Victor-JB/IEEE-Minimalist-AI-Challenge-2026/tools/arm_mujoco/drive_parts.png

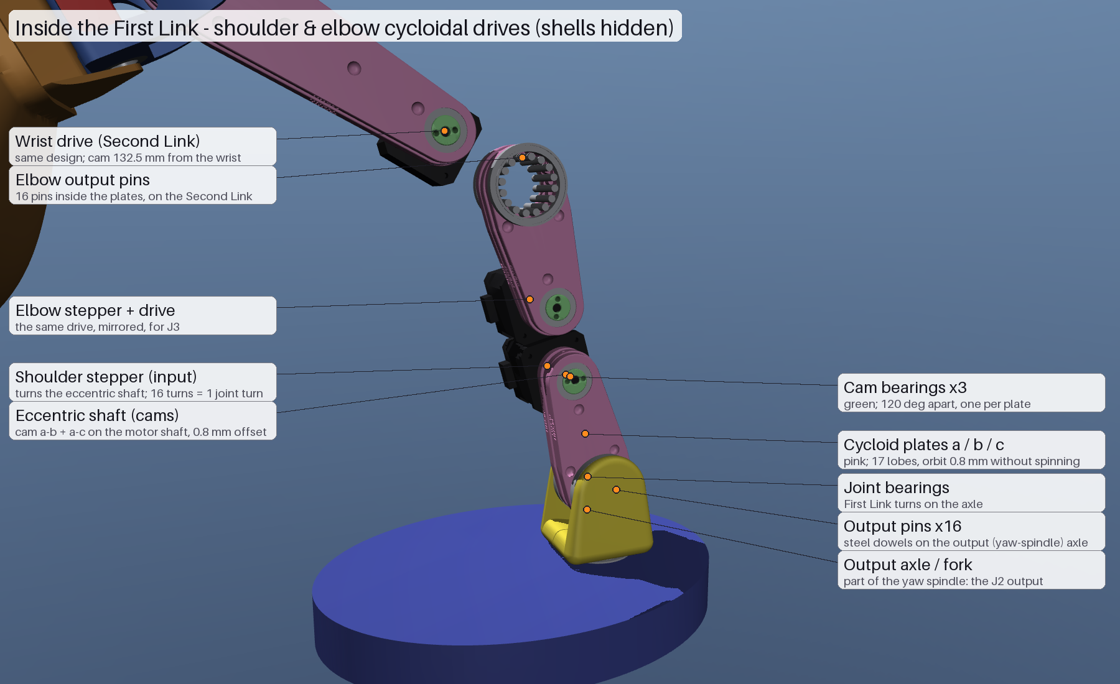
tools/arm_mujoco/drive_parts.png
