Victor-JB/IEEE-Minimalist-AI-Challenge-2026/docs/state_machine_v0_happy_path.png

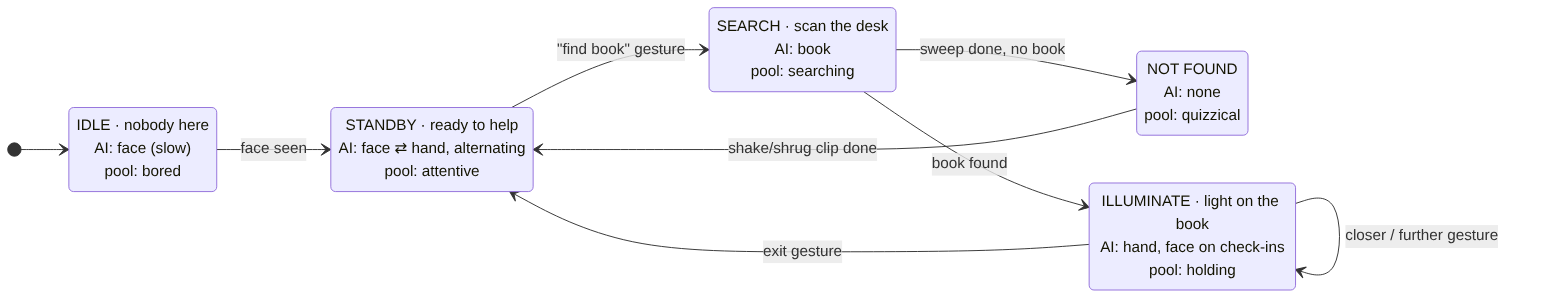
docs/state_machine_v0_happy_path.png
