Victor-JB/IEEE-Minimalist-AI-Challenge-2026/docs/state_machine_v1_fault.png

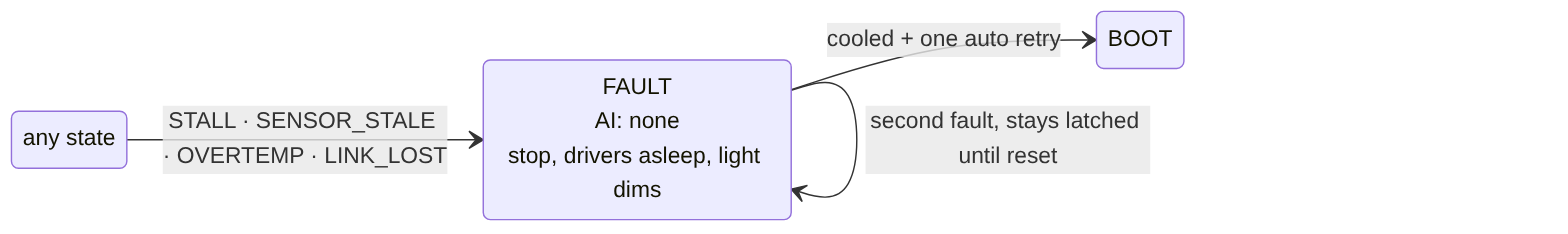
docs/state_machine_v1_fault.png
