Victor-JB/IEEE-Minimalist-AI-Challenge-2026/docs/state_machine_v1_production.png

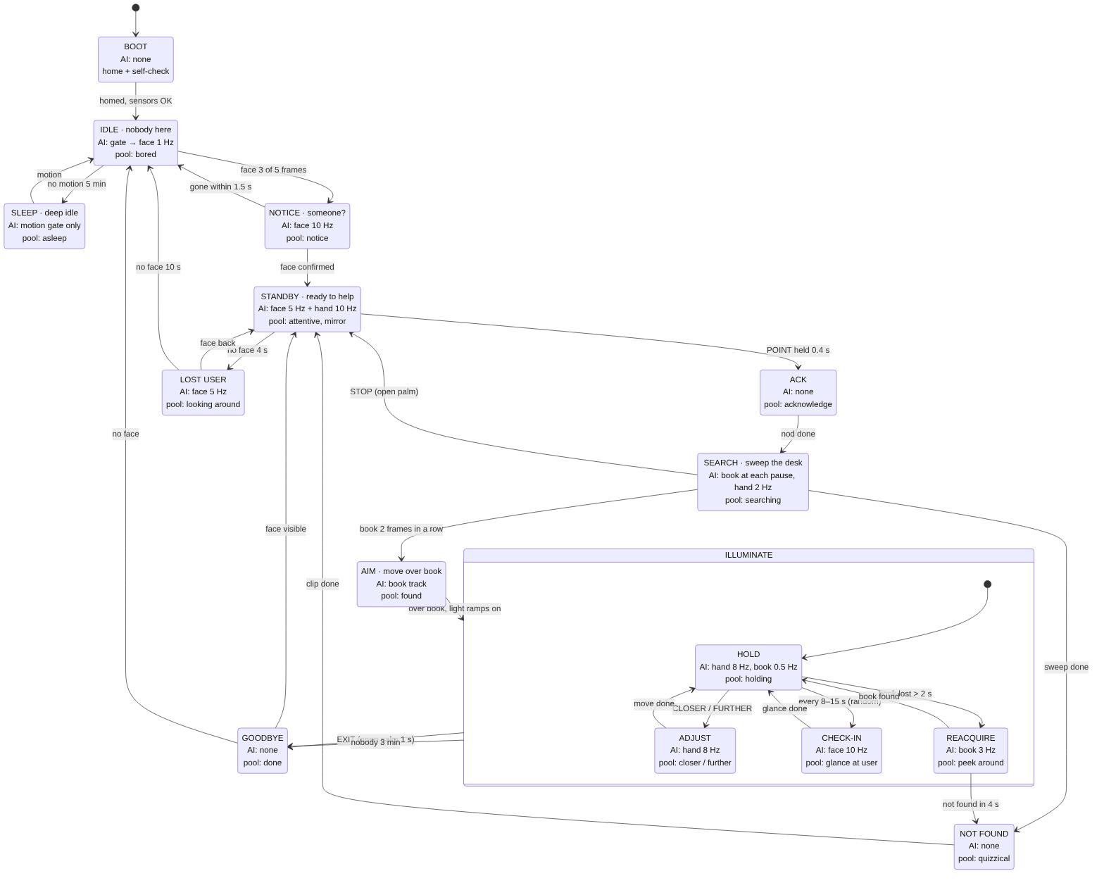
docs/state_machine_v1_production.png
