Victor-JB/IEEE-Minimalist-AI-Challenge-2026/motion_lib/gamma_comparison/out_of_reach.png

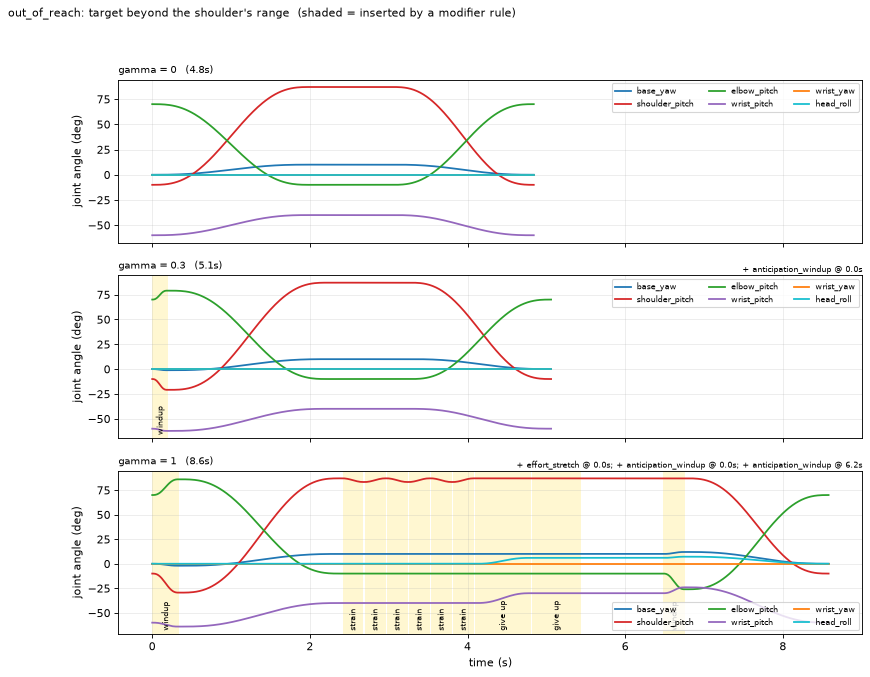
motion_lib/gamma_comparison/out_of_reach.png
