Victor-JB/IEEE-Minimalist-AI-Challenge-2026/motion_lib/gamma_comparison/point_at_object.png

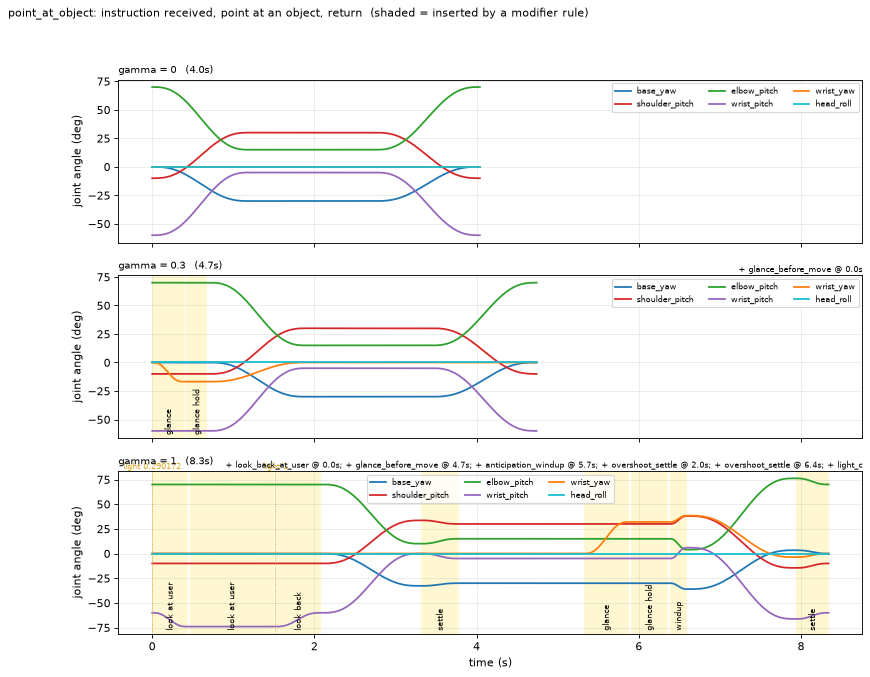
motion_lib/gamma_comparison/point_at_object.png
