Victor-JB/IEEE-Minimalist-AI-Challenge-2026/motion_lib/gamma_comparison/reaim_light.png

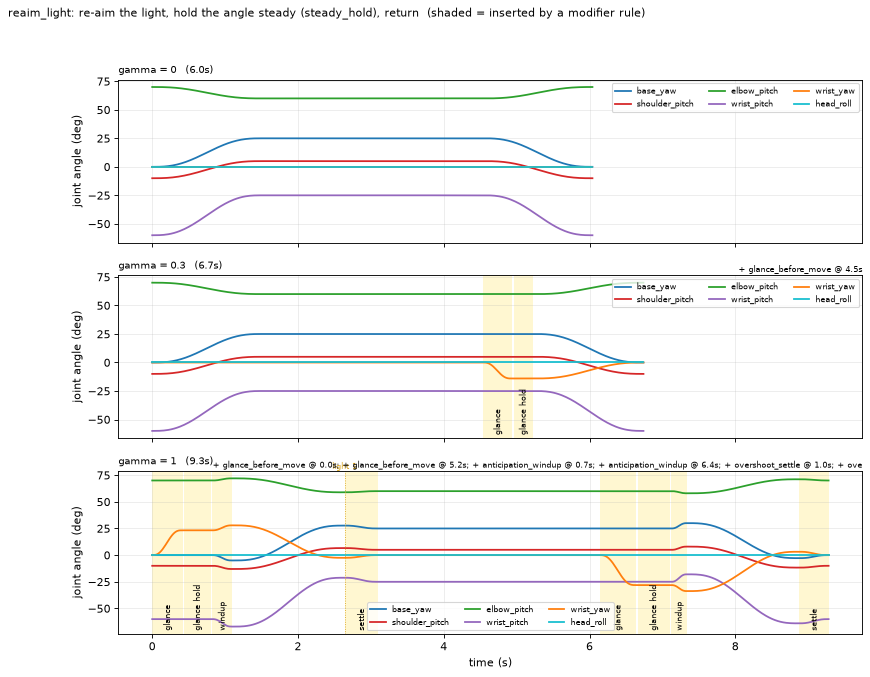
motion_lib/gamma_comparison/reaim_light.png
