Victor-JB/IEEE-Minimalist-AI-Challenge-2026/motion_lib/gamma_comparison/social_greeting.png

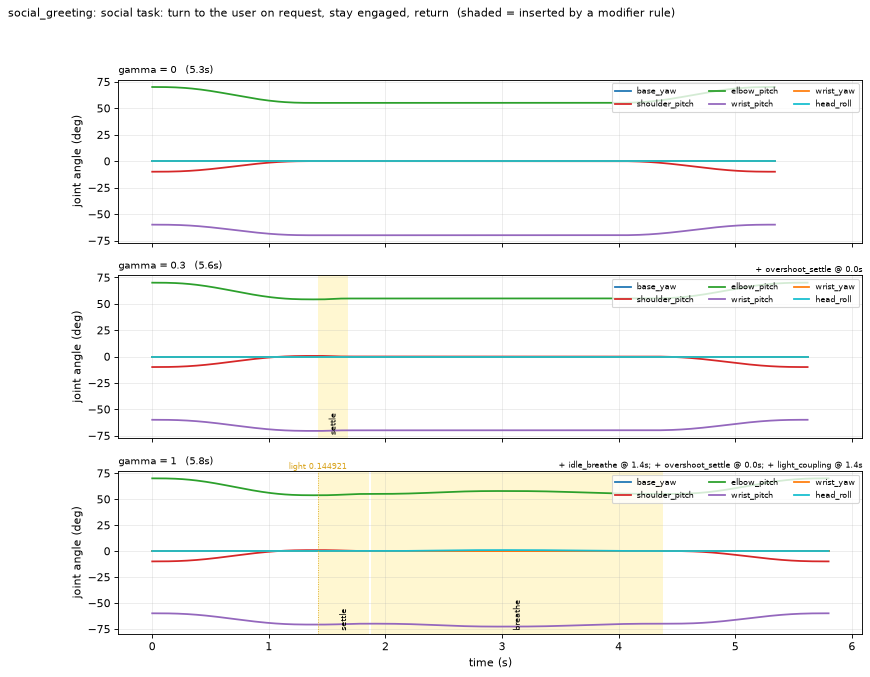
motion_lib/gamma_comparison/social_greeting.png
