Victor-JB/IEEE-Minimalist-AI-Challenge-2026/motion_lib/gamma_comparison/uncertain_move.png

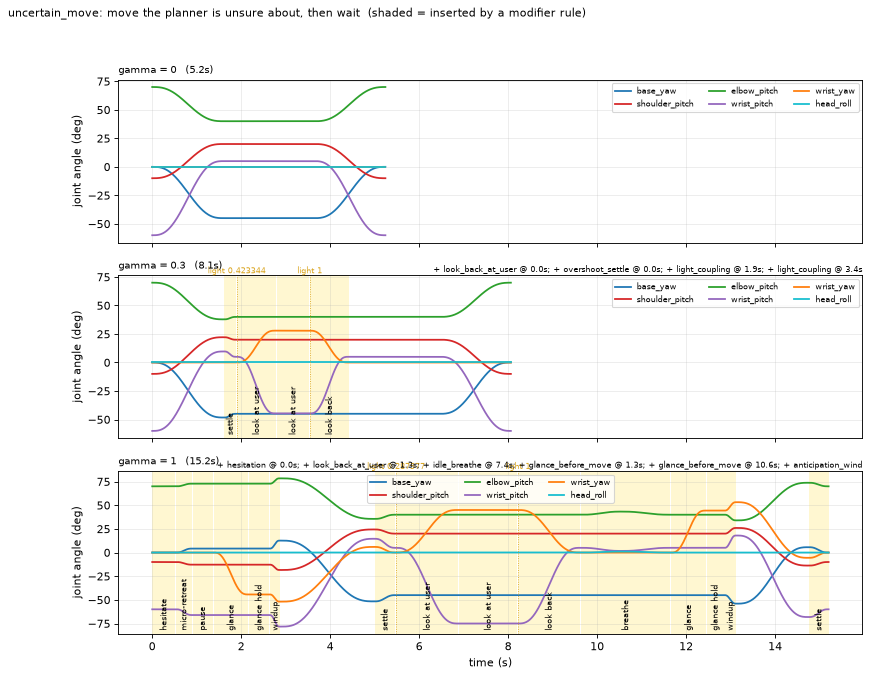
motion_lib/gamma_comparison/uncertain_move.png
