Victor-JB/IEEE-Minimalist-AI-Challenge-2026/motion_lib/review/clips/confident_snap__emphatic.png

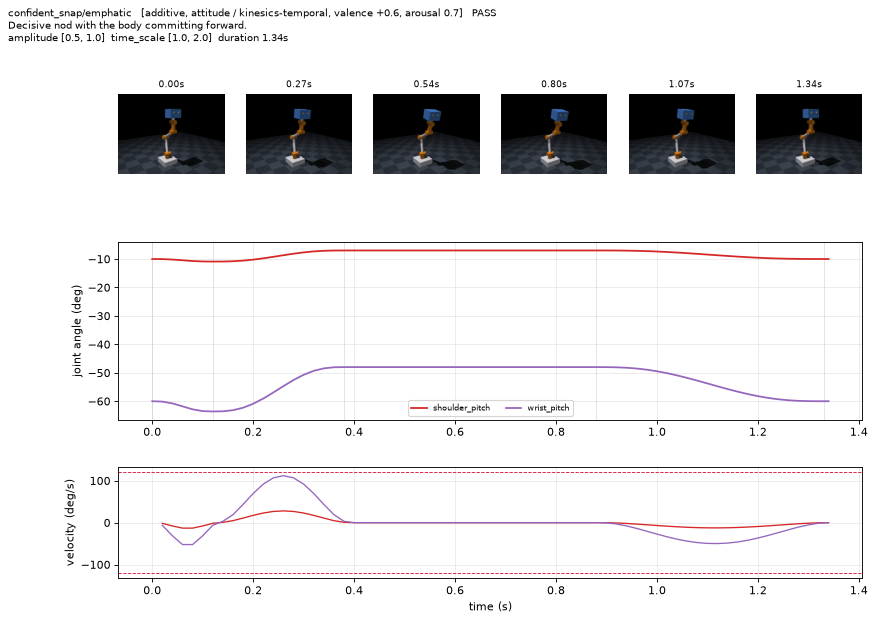
motion_lib/review/clips/confident_snap__emphatic.png
