Victor-JB/IEEE-Minimalist-AI-Challenge-2026/motion_lib/review/clips/curious_head_tilt__double.png

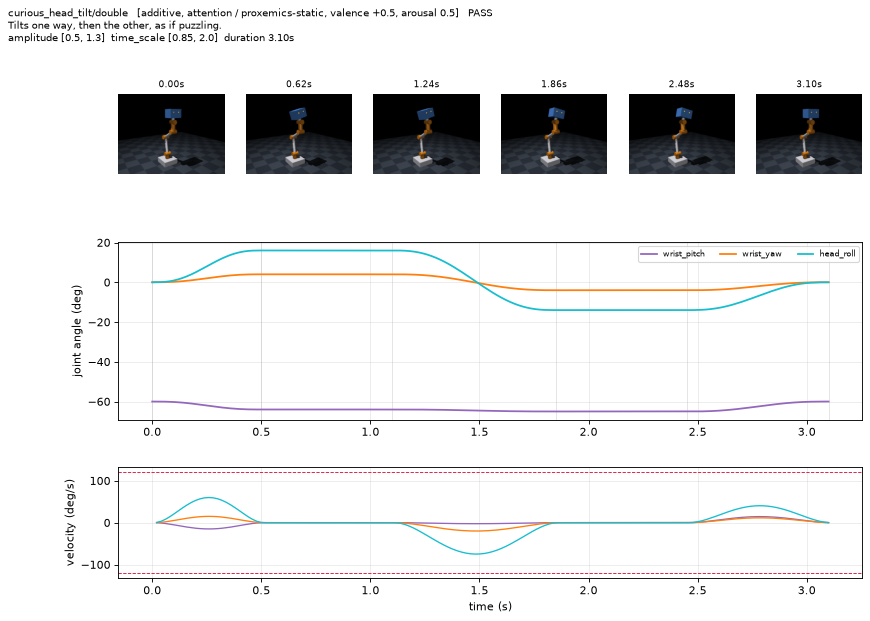
motion_lib/review/clips/curious_head_tilt__double.png
