Victor-JB/IEEE-Minimalist-AI-Challenge-2026/motion_lib/review/clips/dance_110__party.png

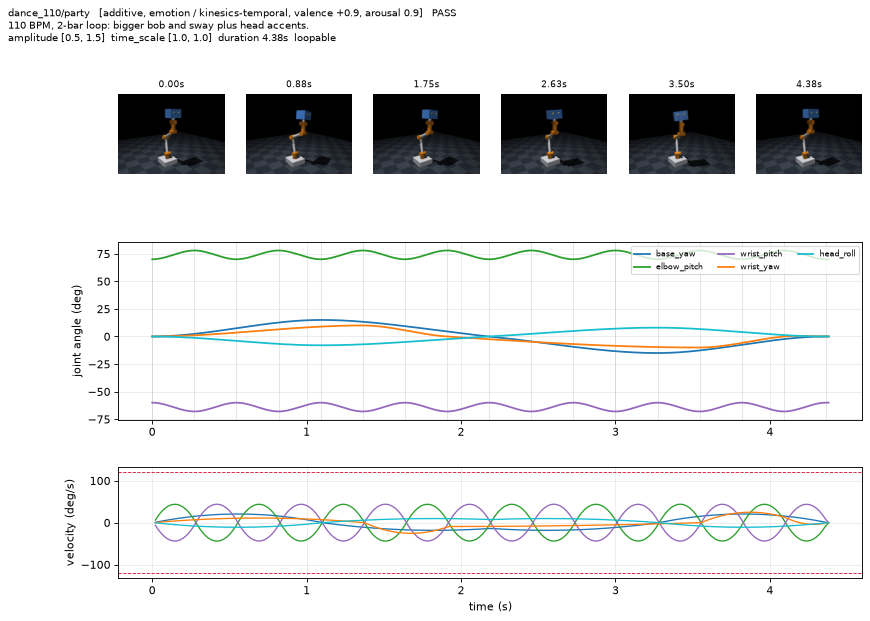
motion_lib/review/clips/dance_110__party.png
