Victor-JB/IEEE-Minimalist-AI-Challenge-2026/motion_lib/review/clips/double_take__big.png

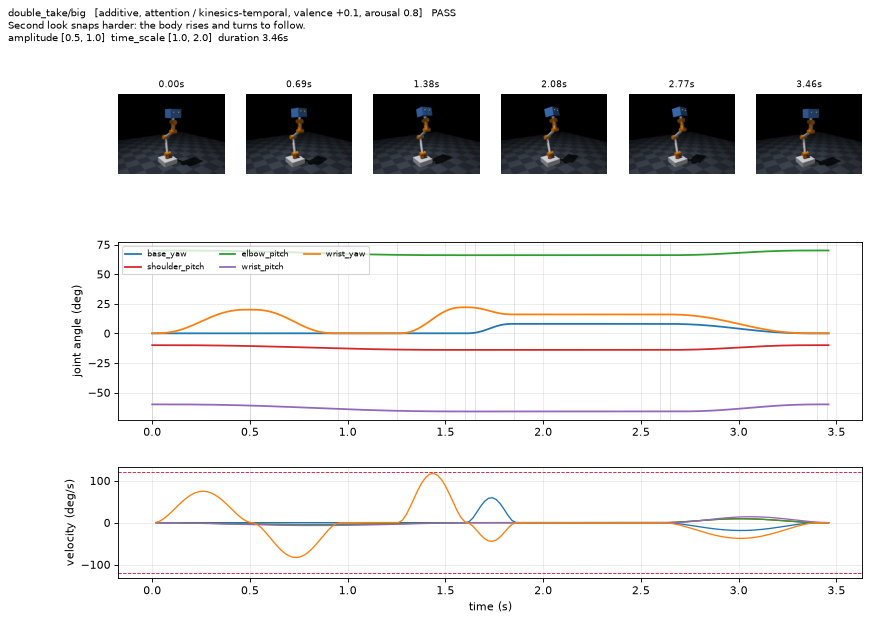
motion_lib/review/clips/double_take__big.png
