Victor-JB/IEEE-Minimalist-AI-Challenge-2026/motion_lib/review/clips/excited_bounce__big_eager.png

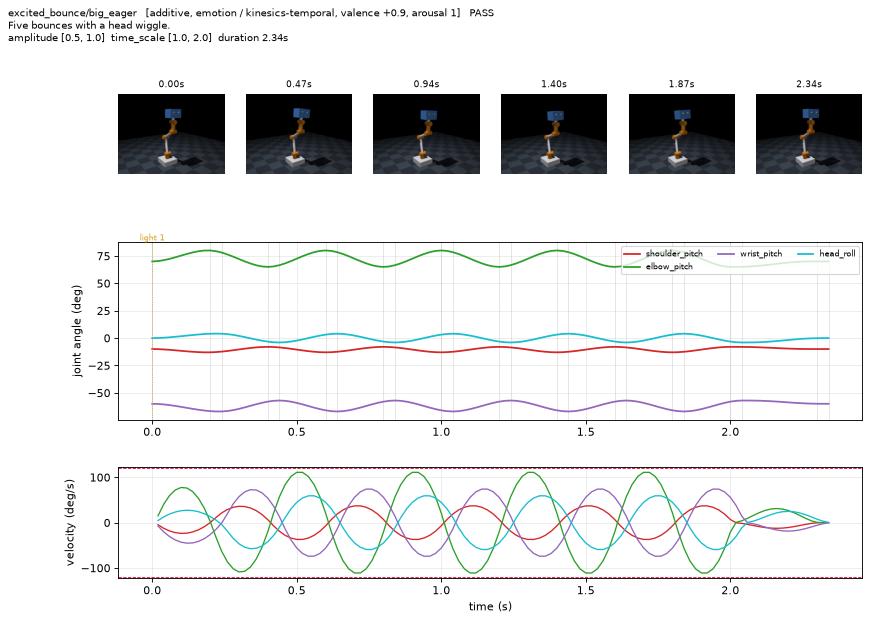
motion_lib/review/clips/excited_bounce__big_eager.png
