Victor-JB/IEEE-Minimalist-AI-Challenge-2026/motion_lib/review/clips/go_to_sleep__quick.png

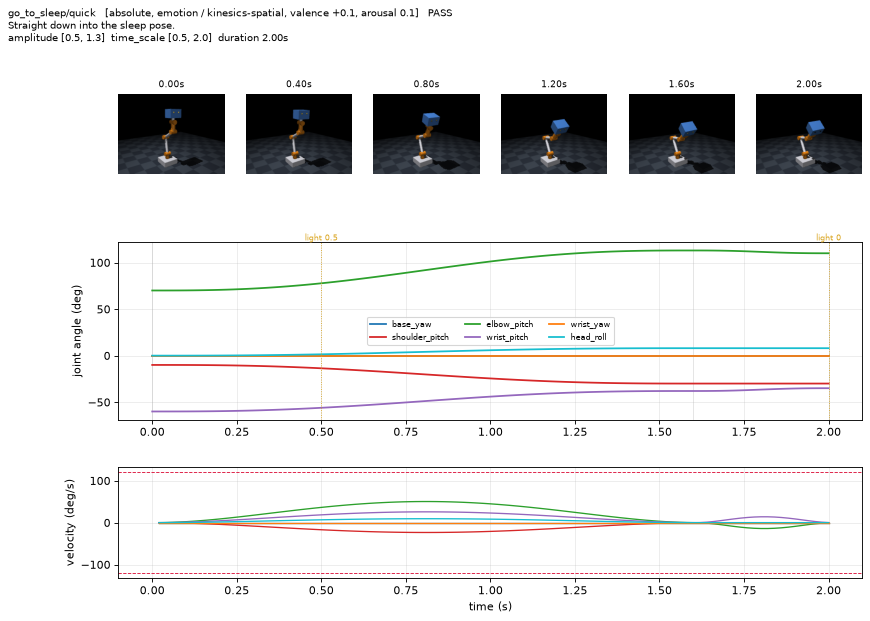
motion_lib/review/clips/go_to_sleep__quick.png
