Victor-JB/IEEE-Minimalist-AI-Challenge-2026/motion_lib/review/clips/hesitate__unsure.png

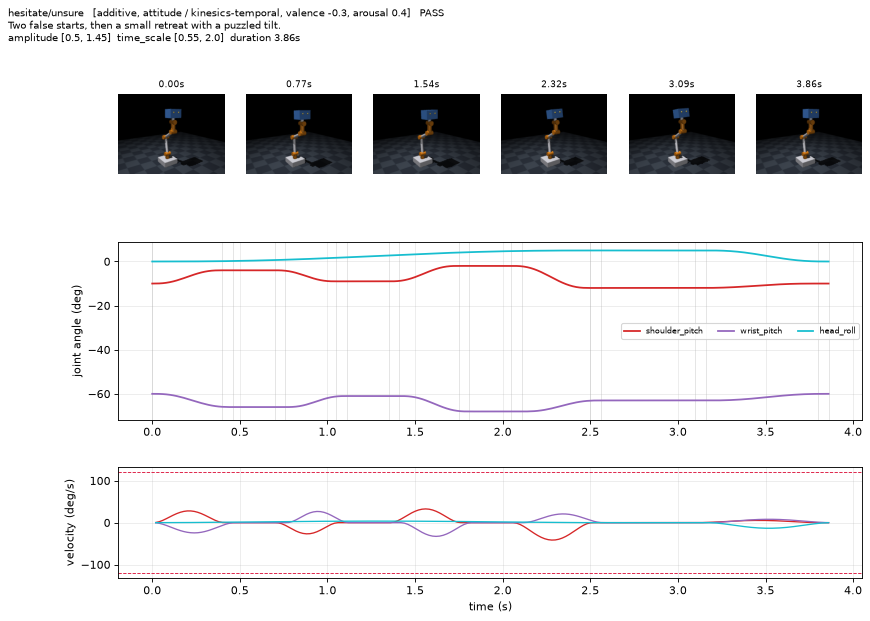
motion_lib/review/clips/hesitate__unsure.png
