Victor-JB/IEEE-Minimalist-AI-Challenge-2026/motion_lib/review/clips/home__brisk.png

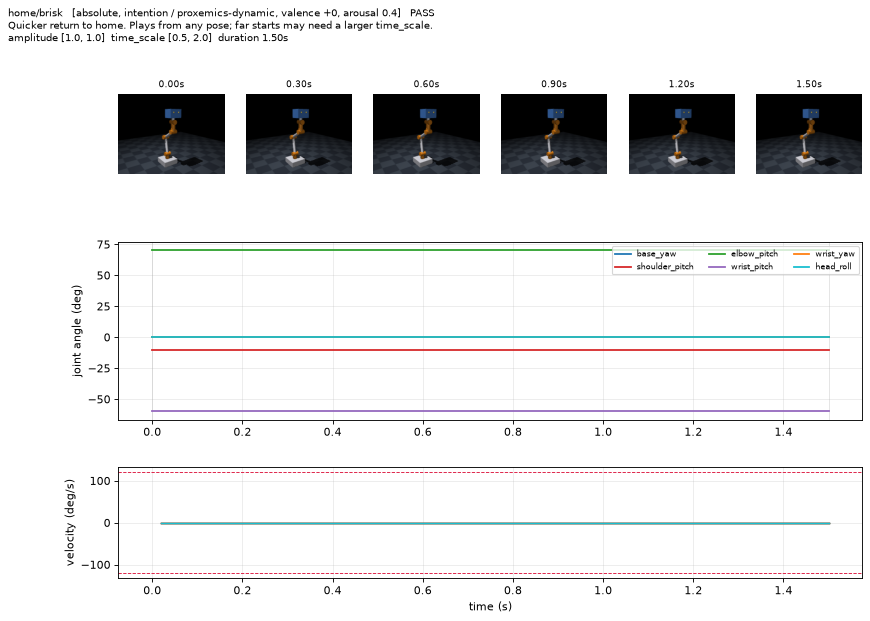
motion_lib/review/clips/home__brisk.png
