Victor-JB/IEEE-Minimalist-AI-Challenge-2026/motion_lib/review/clips/idle_breathe__calm.png

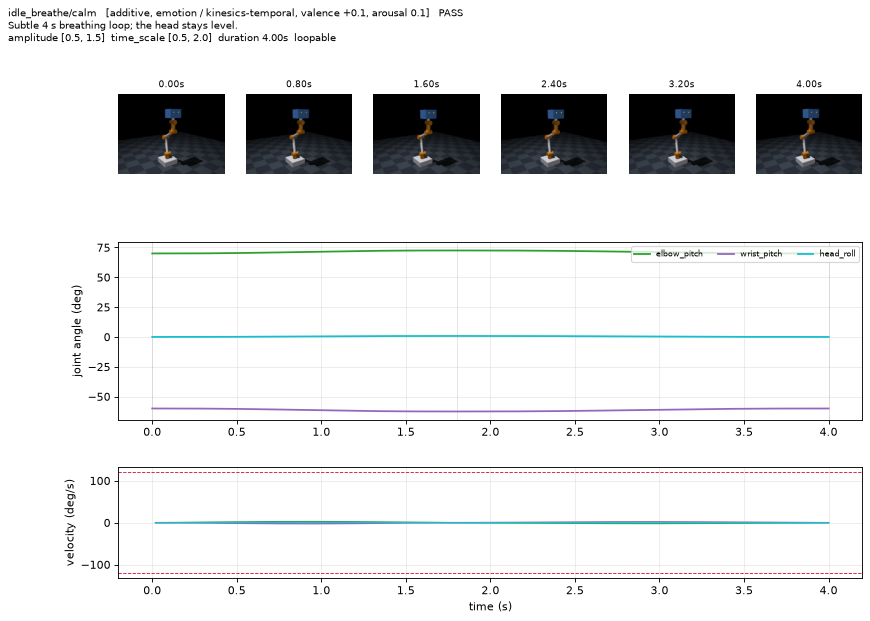
motion_lib/review/clips/idle_breathe__calm.png
