Victor-JB/IEEE-Minimalist-AI-Challenge-2026/motion_lib/review/clips/lean_in_interest__deep.png

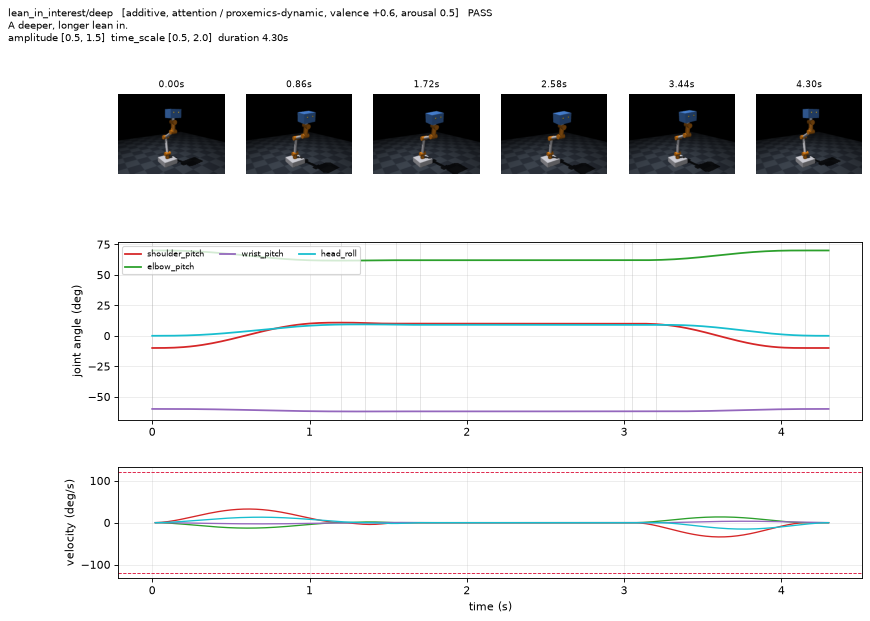
motion_lib/review/clips/lean_in_interest__deep.png
