Victor-JB/IEEE-Minimalist-AI-Challenge-2026/motion_lib/review/clips/look_at_user_return__quick_left.png

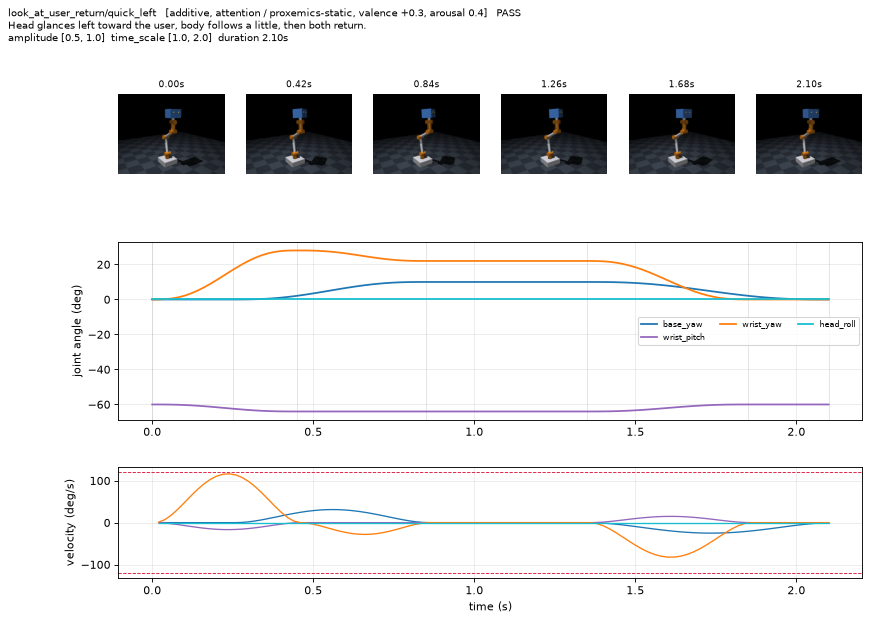
motion_lib/review/clips/look_at_user_return__quick_left.png
