Victor-JB/IEEE-Minimalist-AI-Challenge-2026/motion_lib/review/clips/nod_yes__big_eager.png

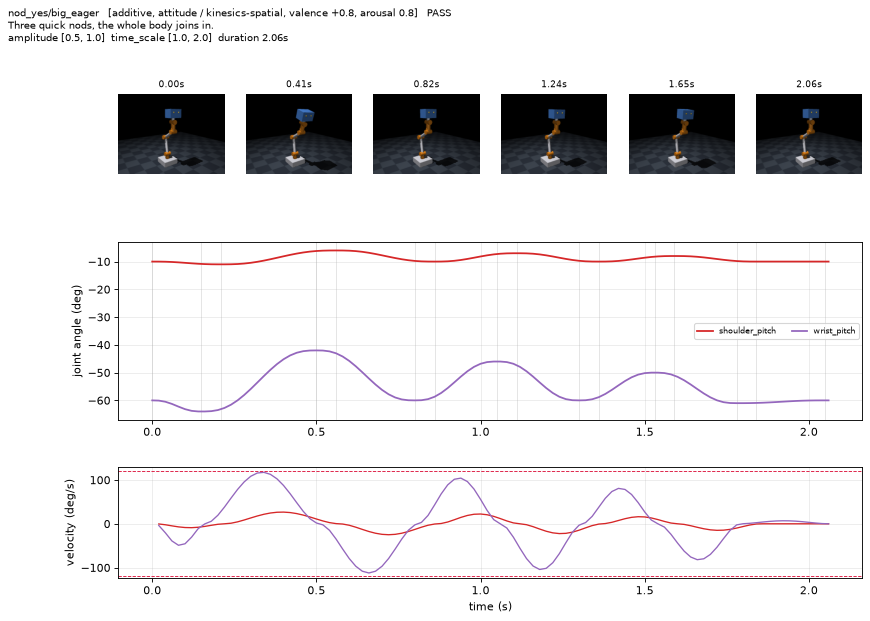
motion_lib/review/clips/nod_yes__big_eager.png
