Victor-JB/IEEE-Minimalist-AI-Challenge-2026/motion_lib/review/clips/nod_yes__medium.png

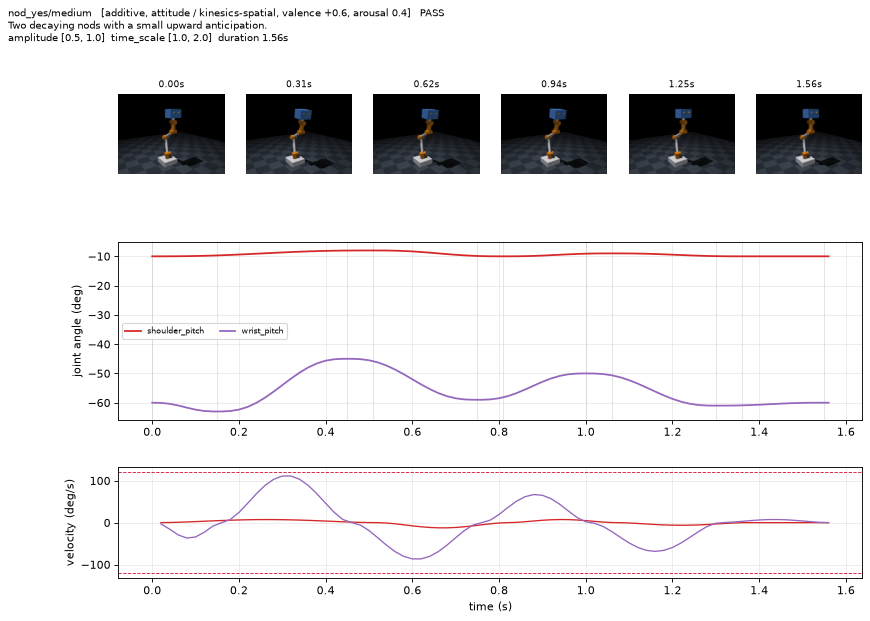
motion_lib/review/clips/nod_yes__medium.png
