Victor-JB/IEEE-Minimalist-AI-Challenge-2026/motion_lib/review/clips/nod_yes__small_calm.png

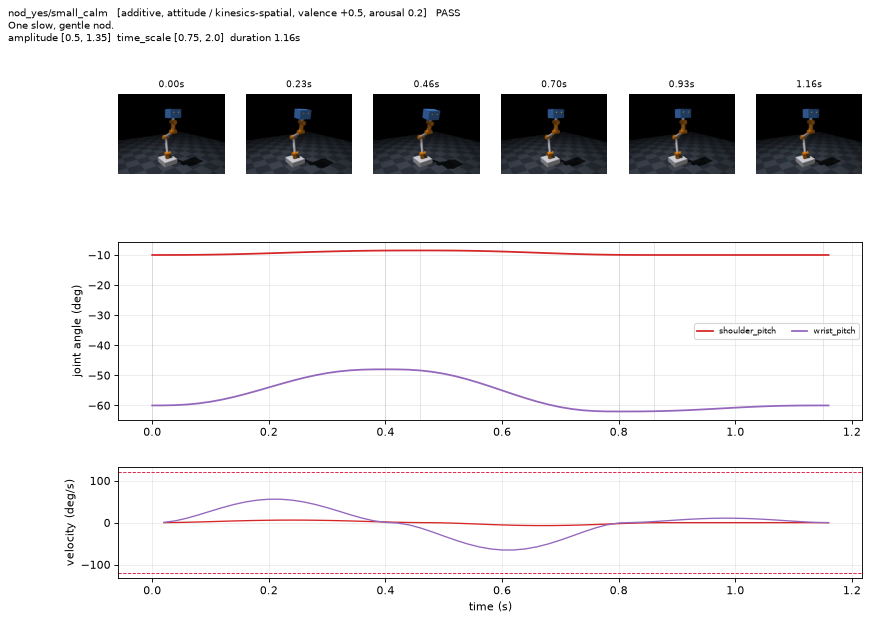
motion_lib/review/clips/nod_yes__small_calm.png
