Victor-JB/IEEE-Minimalist-AI-Challenge-2026/motion_lib/review/clips/perk_up__small.png

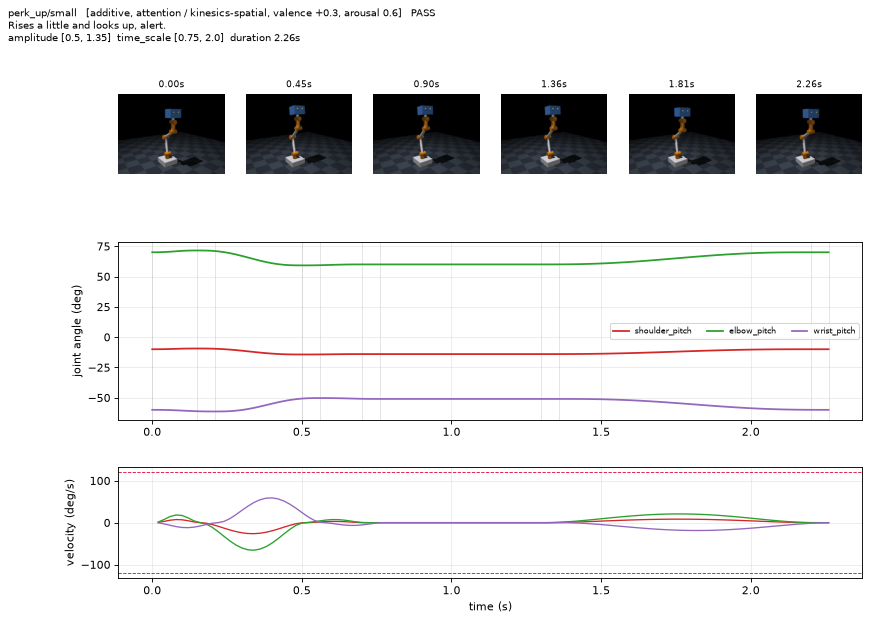
motion_lib/review/clips/perk_up__small.png
