Victor-JB/IEEE-Minimalist-AI-Challenge-2026/motion_lib/review/clips/relaxed_sit_down__calm.png

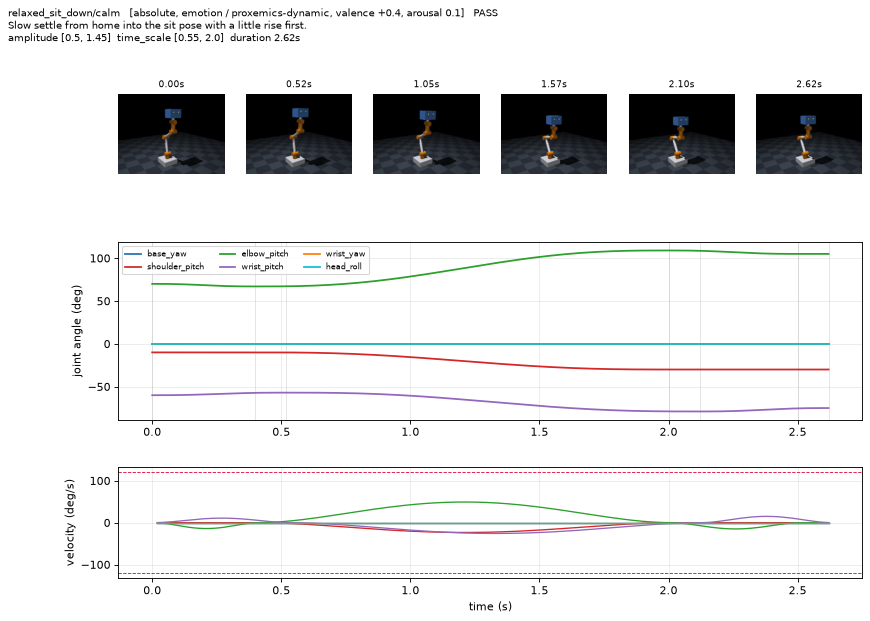
motion_lib/review/clips/relaxed_sit_down__calm.png
