Victor-JB/IEEE-Minimalist-AI-Challenge-2026/motion_lib/review/clips/sad_droop__slight.png

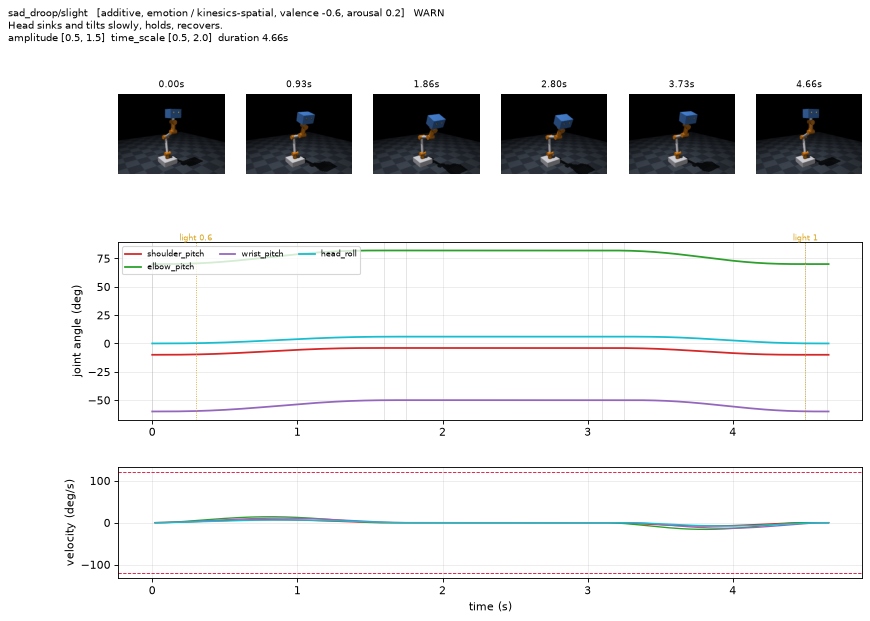
motion_lib/review/clips/sad_droop__slight.png
