Victor-JB/IEEE-Minimalist-AI-Challenge-2026/motion_lib/review/clips/scan_room__calm.png

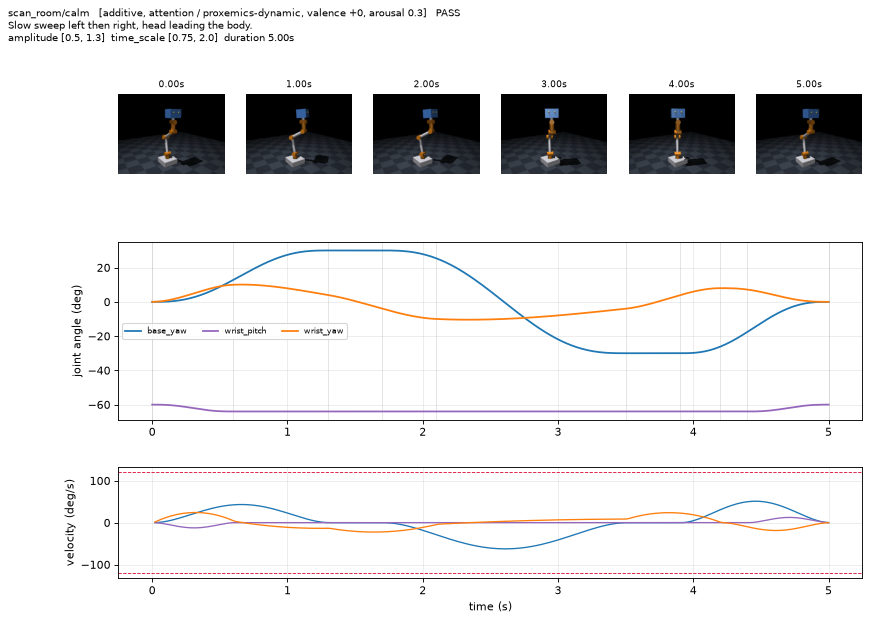
motion_lib/review/clips/scan_room__calm.png
