Victor-JB/IEEE-Minimalist-AI-Challenge-2026/motion_lib/review/clips/shake_no__small_calm.png

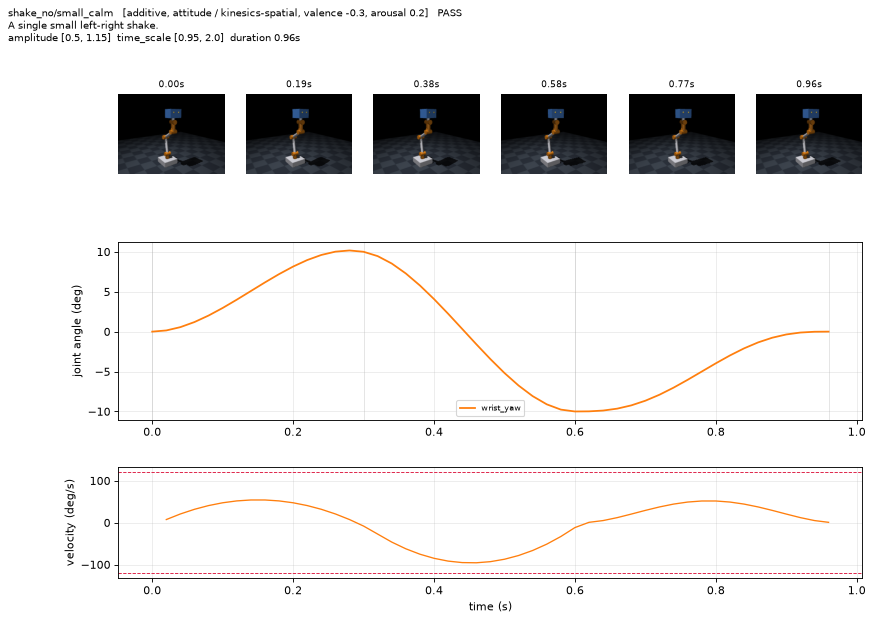
motion_lib/review/clips/shake_no__small_calm.png
