Victor-JB/IEEE-Minimalist-AI-Challenge-2026/motion_lib/review/clips/shrug_fail__big.png

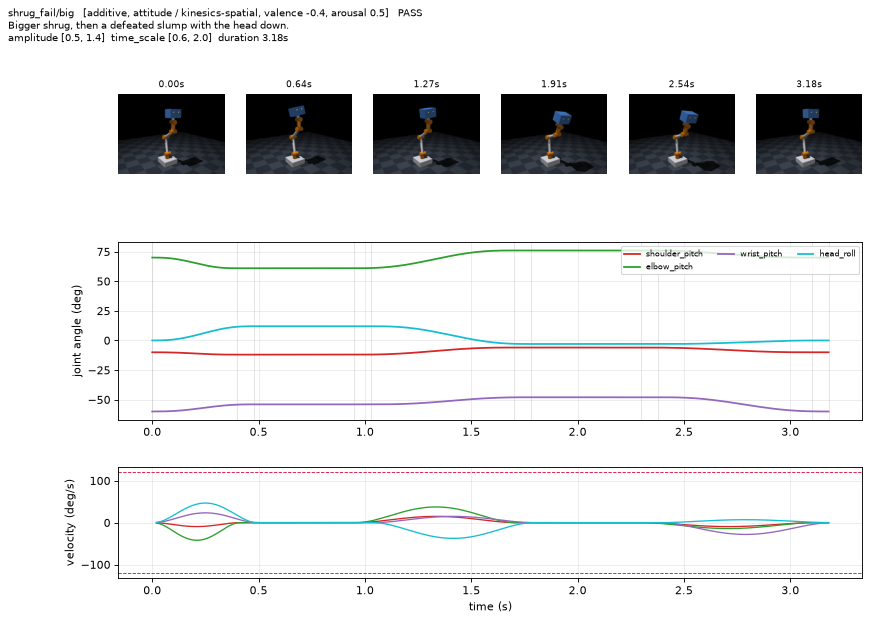
motion_lib/review/clips/shrug_fail__big.png
