Victor-JB/IEEE-Minimalist-AI-Challenge-2026/motion_lib/review/clips/startle_recoil__big.png

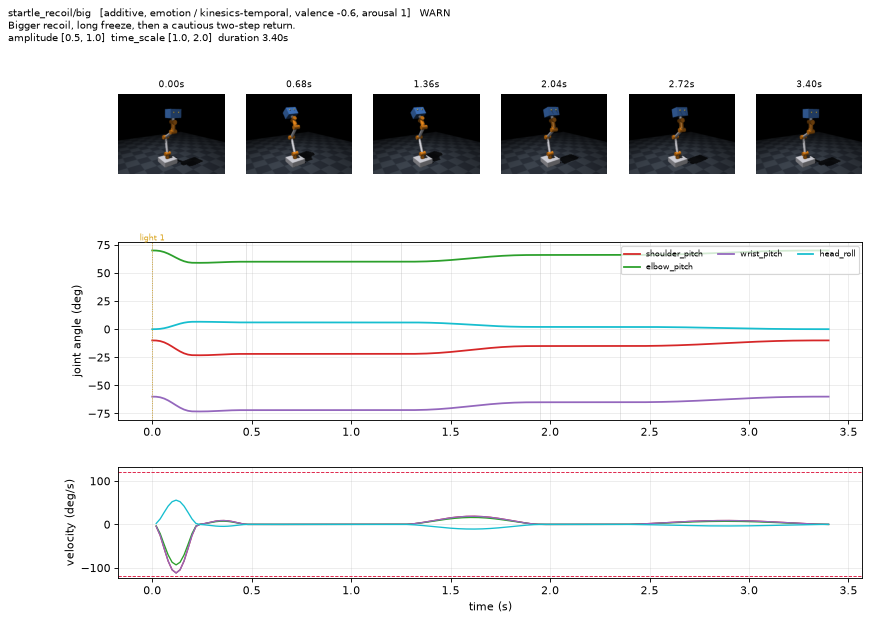
motion_lib/review/clips/startle_recoil__big.png
