Victor-JB/IEEE-Minimalist-AI-Challenge-2026/motion_lib/review/clips/tail_wag__small.png

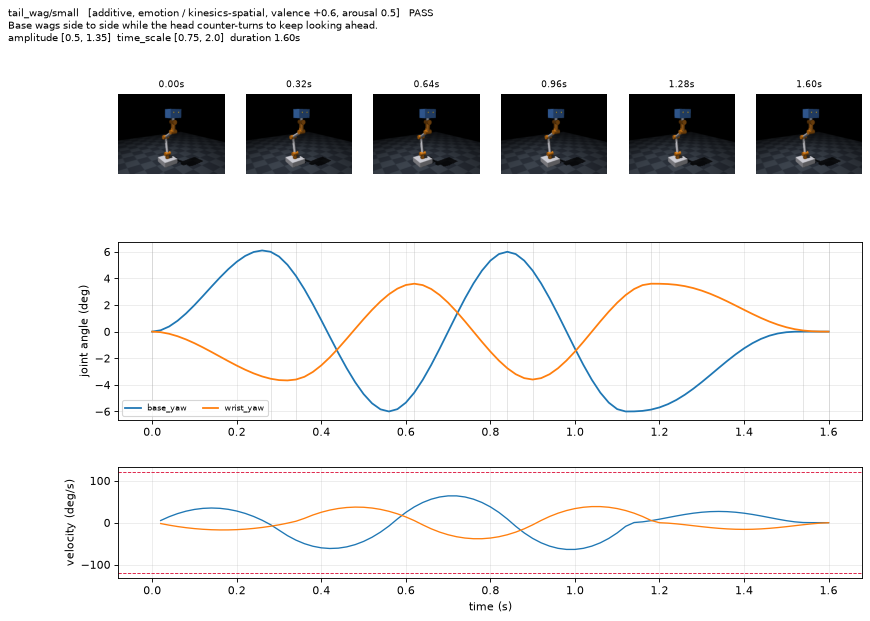
motion_lib/review/clips/tail_wag__small.png
