Victor-JB/IEEE-Minimalist-AI-Challenge-2026/motion_lib/review/clips/wake_up__quick_bright.png

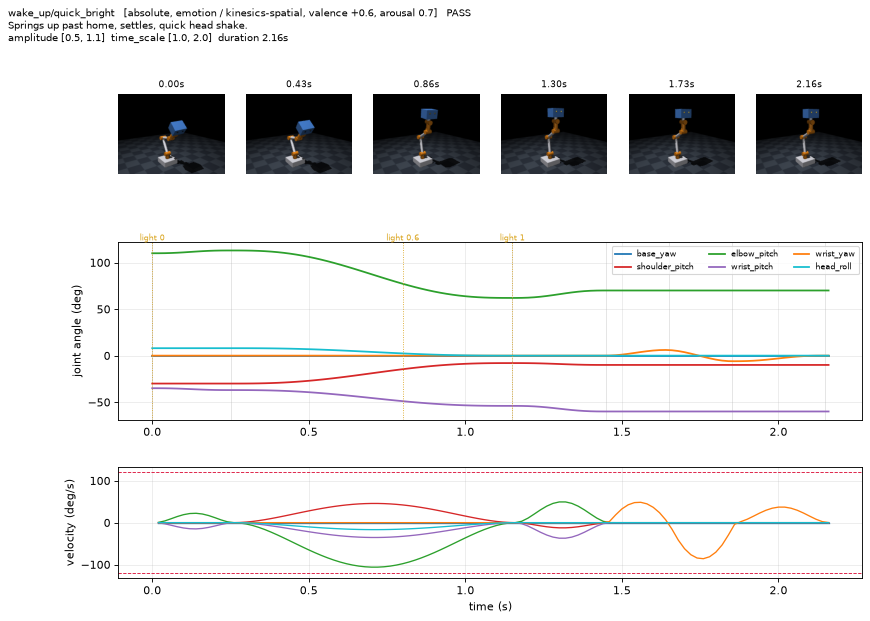
motion_lib/review/clips/wake_up__quick_bright.png
