Victor-JB/IEEE-Minimalist-AI-Challenge-2026/tools/motion_lib/gamma_comparison/reach_desk_spot.png

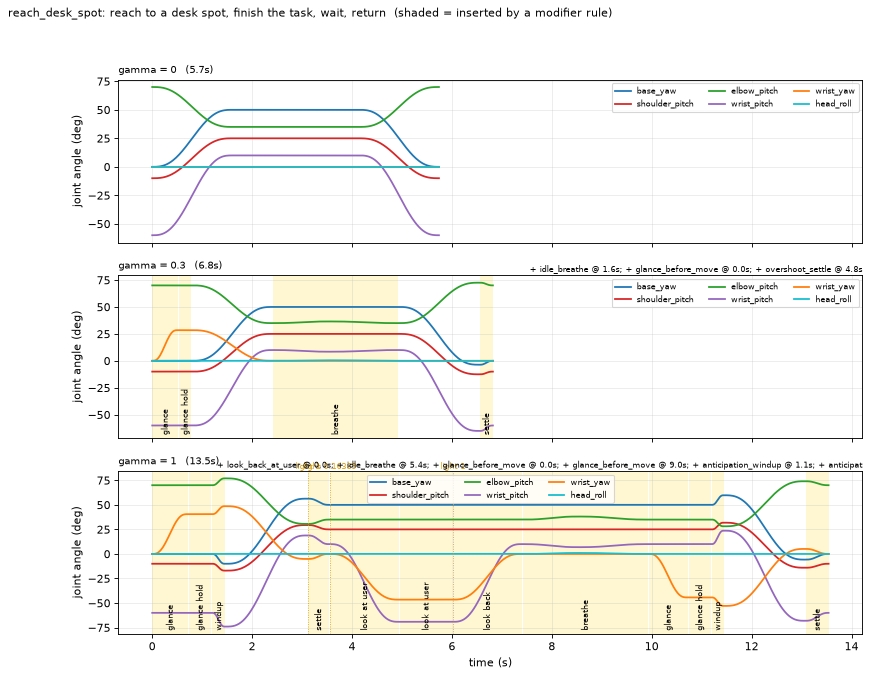
tools/motion_lib/gamma_comparison/reach_desk_spot.png
