Victor-JB/IEEE-Minimalist-AI-Challenge-2026/tools/motion_lib/gamma_comparison/return_home.png

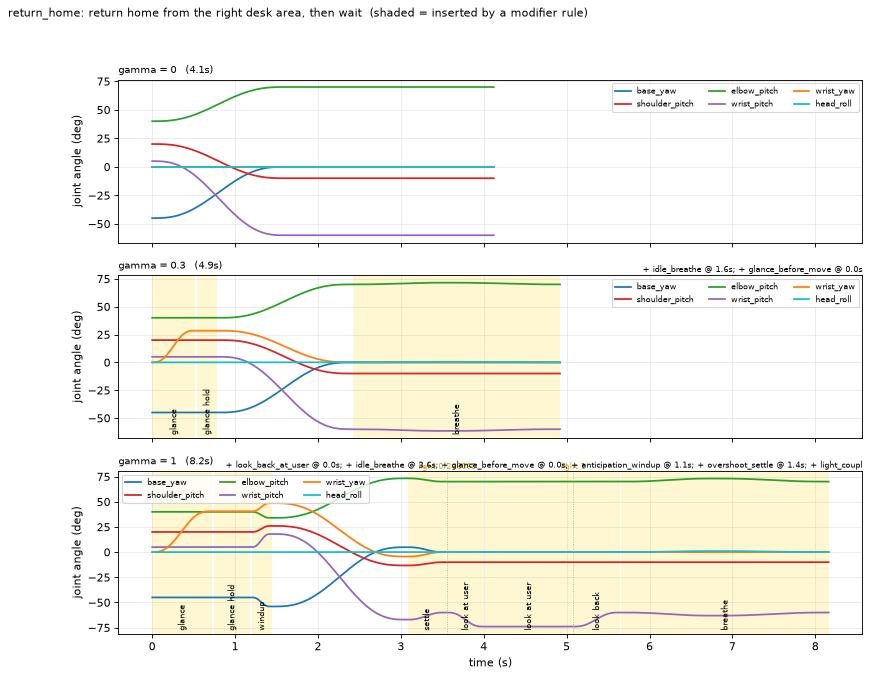
tools/motion_lib/gamma_comparison/return_home.png
