Victor-JB/IEEE-Minimalist-AI-Challenge-2026/tools/motion_lib/review/clips/approach_object__eager.png

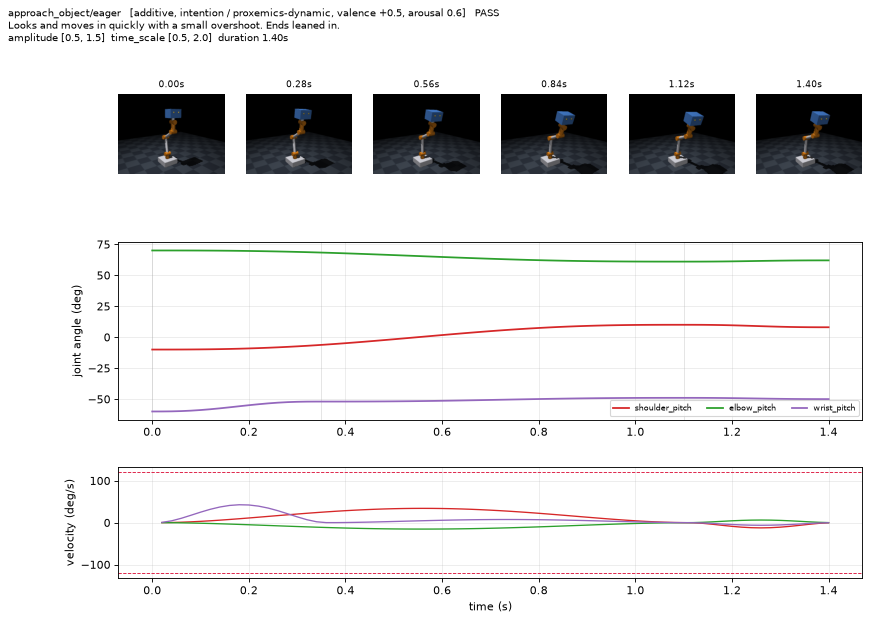
tools/motion_lib/review/clips/approach_object__eager.png
