Victor-JB/IEEE-Minimalist-AI-Challenge-2026/tools/motion_lib/review/clips/avoid_object__mild.png

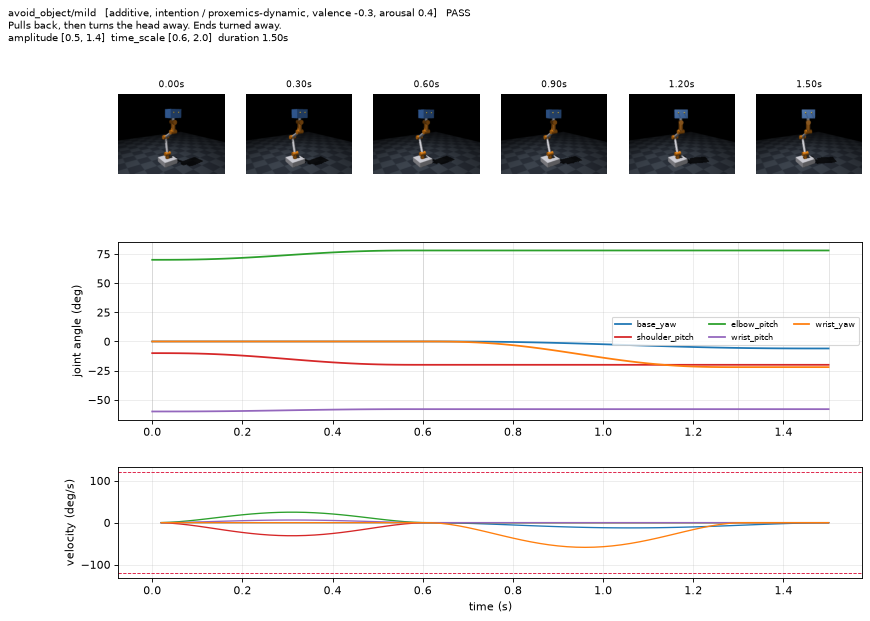
tools/motion_lib/review/clips/avoid_object__mild.png
