Victor-JB/IEEE-Minimalist-AI-Challenge-2026/tools/motion_lib/review/clips/celebrate__big.png

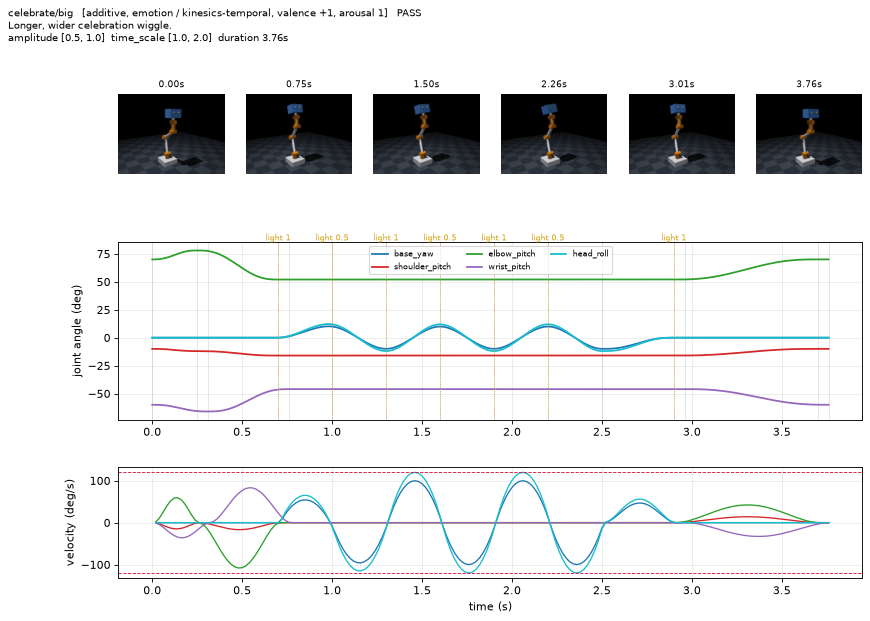
tools/motion_lib/review/clips/celebrate__big.png
