Victor-JB/IEEE-Minimalist-AI-Challenge-2026/tools/motion_lib/review/clips/dance_90__groove.png

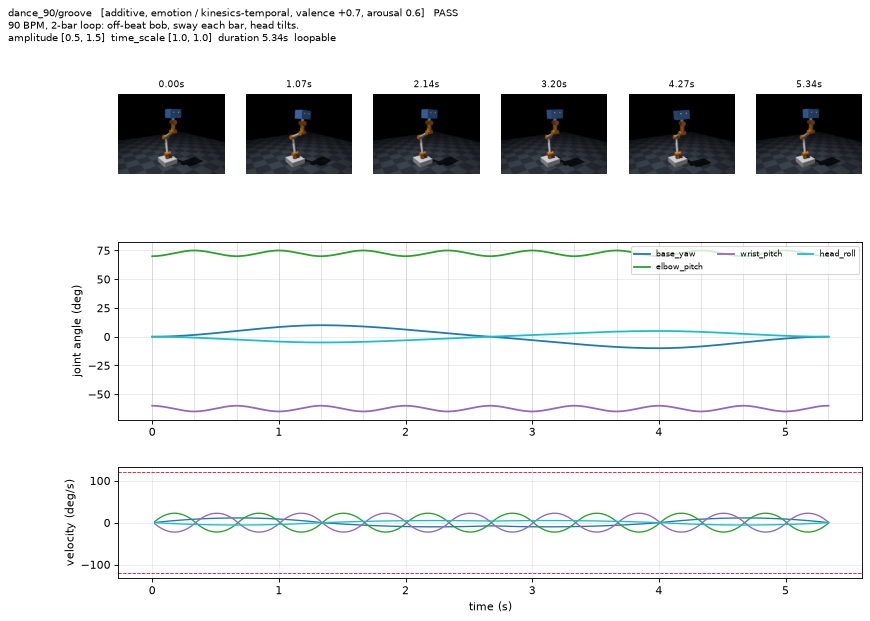
tools/motion_lib/review/clips/dance_90__groove.png
