Victor-JB/IEEE-Minimalist-AI-Challenge-2026/tools/motion_lib/review/clips/glance_then_reach__right.png

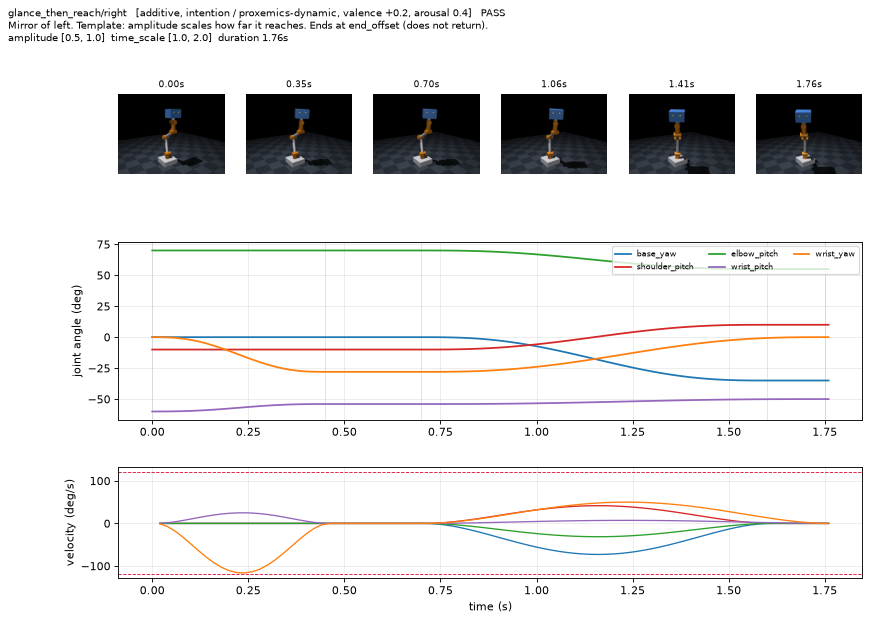
tools/motion_lib/review/clips/glance_then_reach__right.png
