Victor-JB/IEEE-Minimalist-AI-Challenge-2026/tools/motion_lib/review/clips/go_to_sleep__drowsy.png

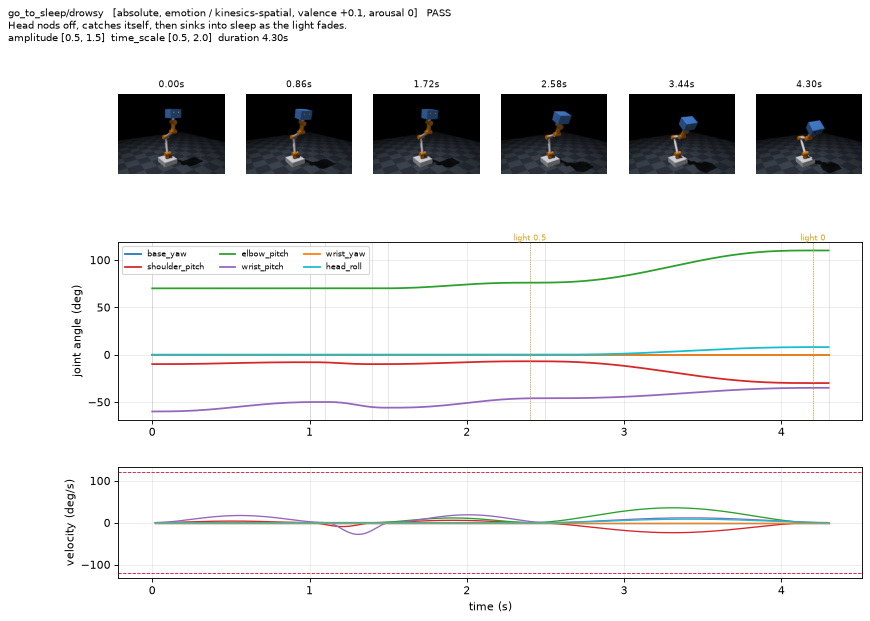
tools/motion_lib/review/clips/go_to_sleep__drowsy.png
