Victor-JB/IEEE-Minimalist-AI-Challenge-2026/tools/motion_lib/review/clips/nuzzle_touch__affectionate.png

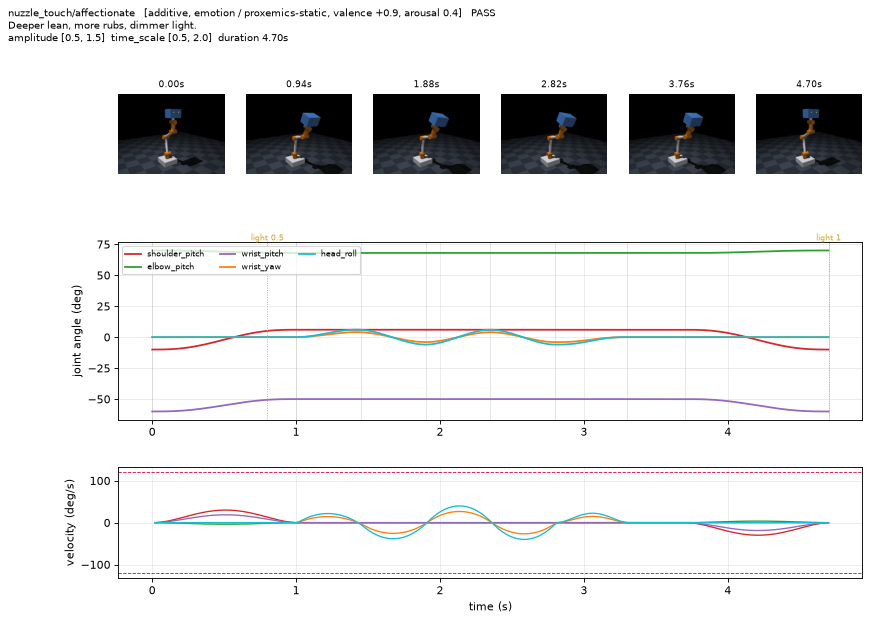
tools/motion_lib/review/clips/nuzzle_touch__affectionate.png
