Victor-JB/IEEE-Minimalist-AI-Challenge-2026/tools/motion_lib/review/clips/nuzzle_touch__gentle.png

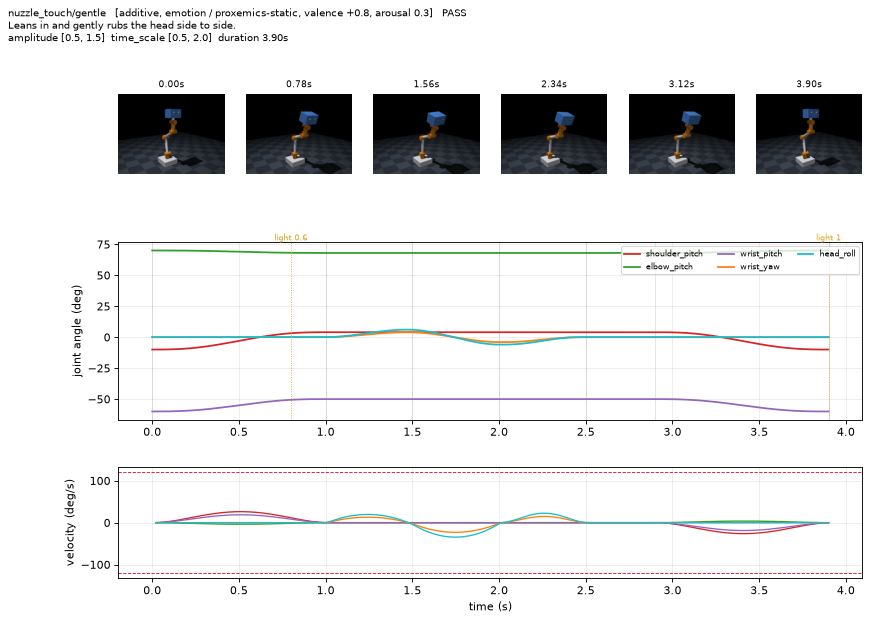
tools/motion_lib/review/clips/nuzzle_touch__gentle.png
