Victor-JB/IEEE-Minimalist-AI-Challenge-2026/tools/motion_lib/review/clips/point_with_head__left_small.png

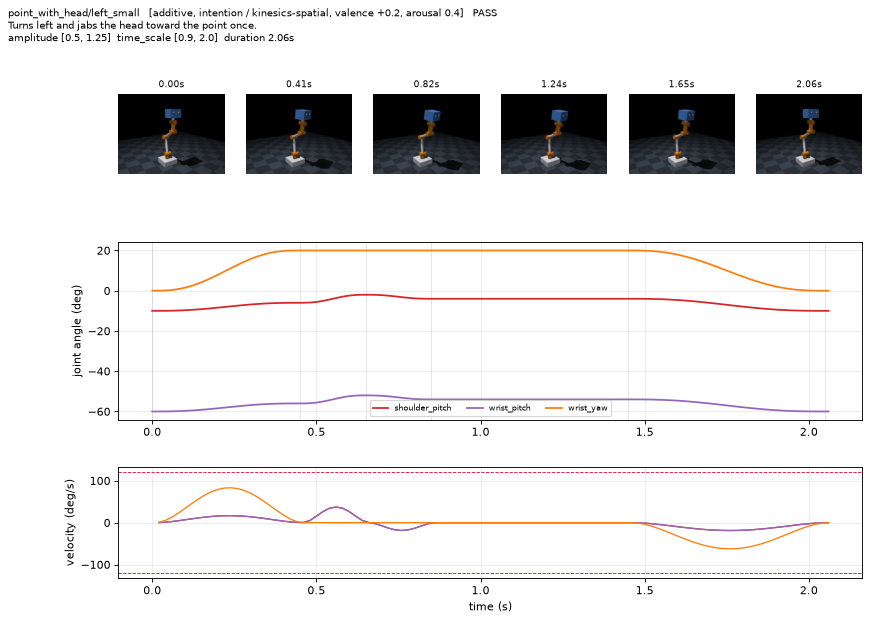
tools/motion_lib/review/clips/point_with_head__left_small.png
