Victor-JB/IEEE-Minimalist-AI-Challenge-2026/tools/motion_lib/review/clips/relaxed_sit_down__quick_plop.png

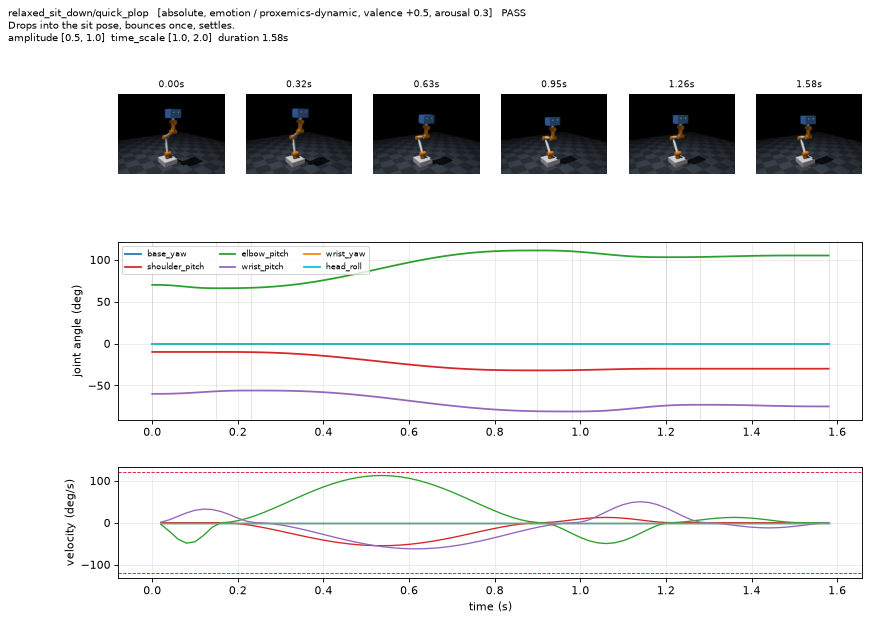
tools/motion_lib/review/clips/relaxed_sit_down__quick_plop.png
