Victor-JB/IEEE-Minimalist-AI-Challenge-2026/tools/motion_lib/review/clips/sad_droop__deep.png

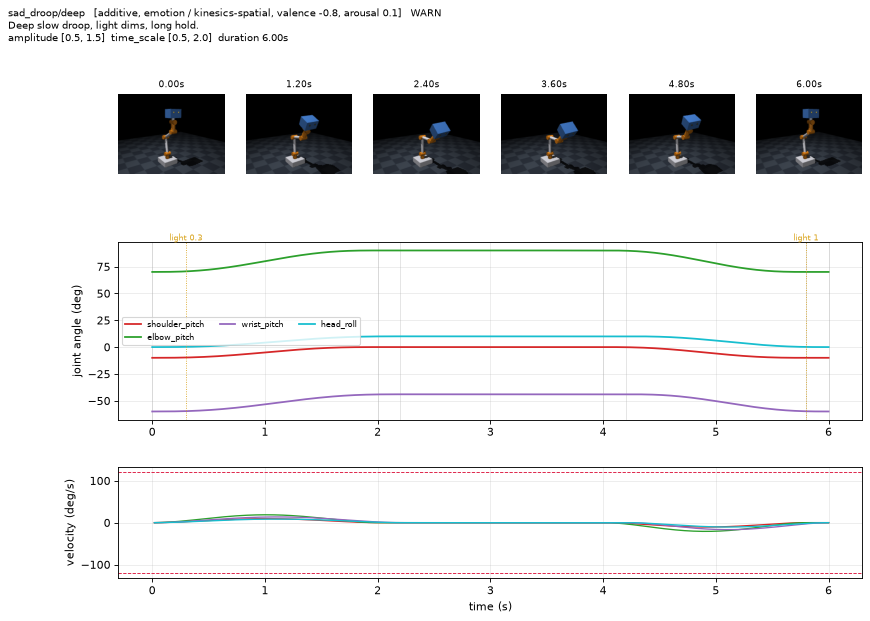
tools/motion_lib/review/clips/sad_droop__deep.png
