Victor-JB/IEEE-Minimalist-AI-Challenge-2026/tools/motion_lib/review/clips/scan_room__alert.png

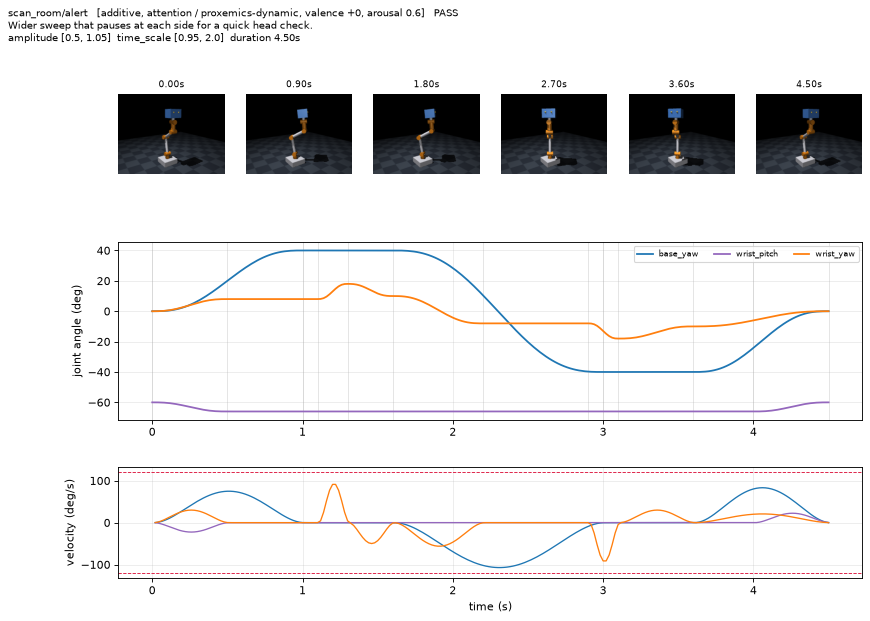
tools/motion_lib/review/clips/scan_room__alert.png
