Victor-JB/IEEE-Minimalist-AI-Challenge-2026/tools/motion_lib/review/clips/shake_no__big_emphatic.png

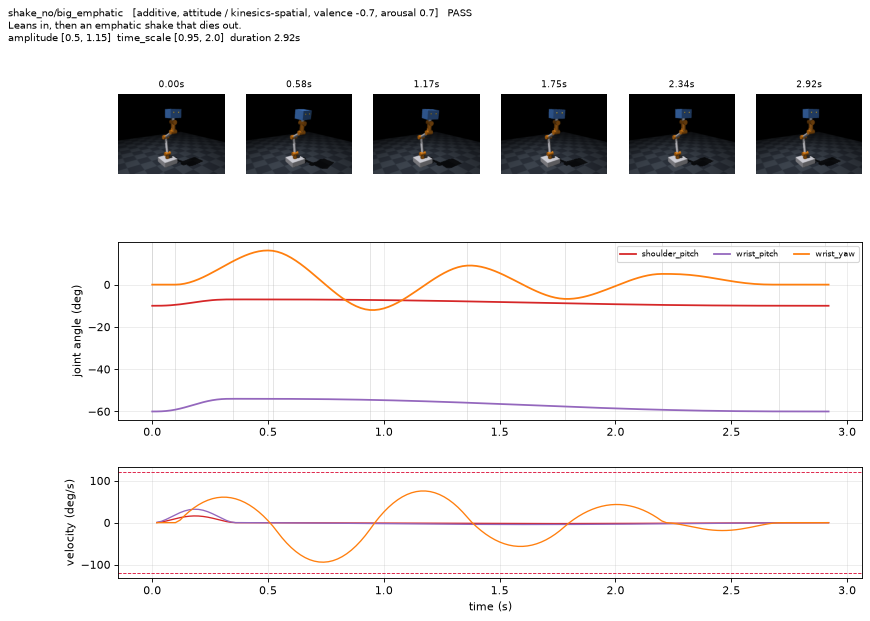
tools/motion_lib/review/clips/shake_no__big_emphatic.png
