Victor-JB/IEEE-Minimalist-AI-Challenge-2026/tools/motion_lib/review/clips/shrug_fail__small.png

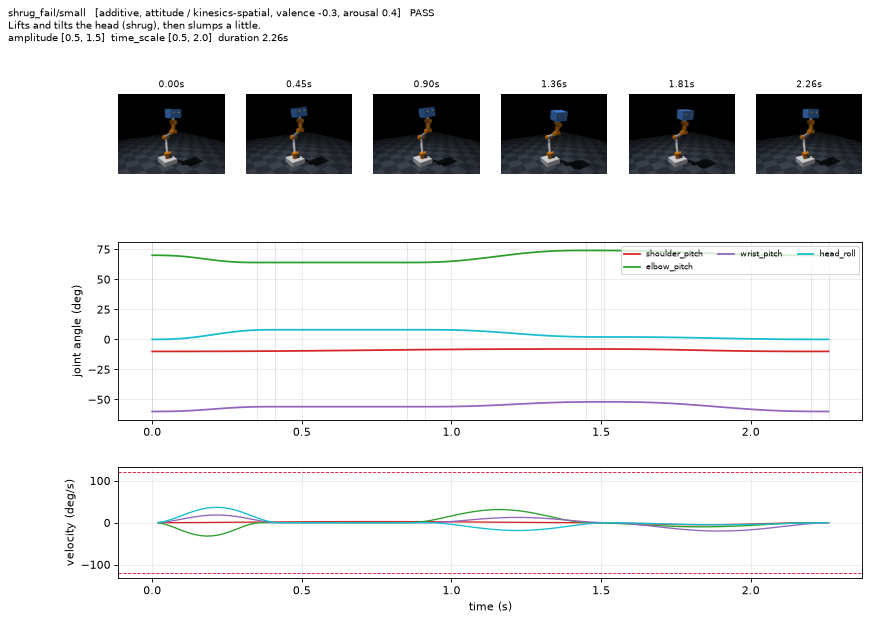
tools/motion_lib/review/clips/shrug_fail__small.png
