Victor-JB/IEEE-Minimalist-AI-Challenge-2026/tools/motion_lib/review/clips/stretch_reach_limit__short_try.png

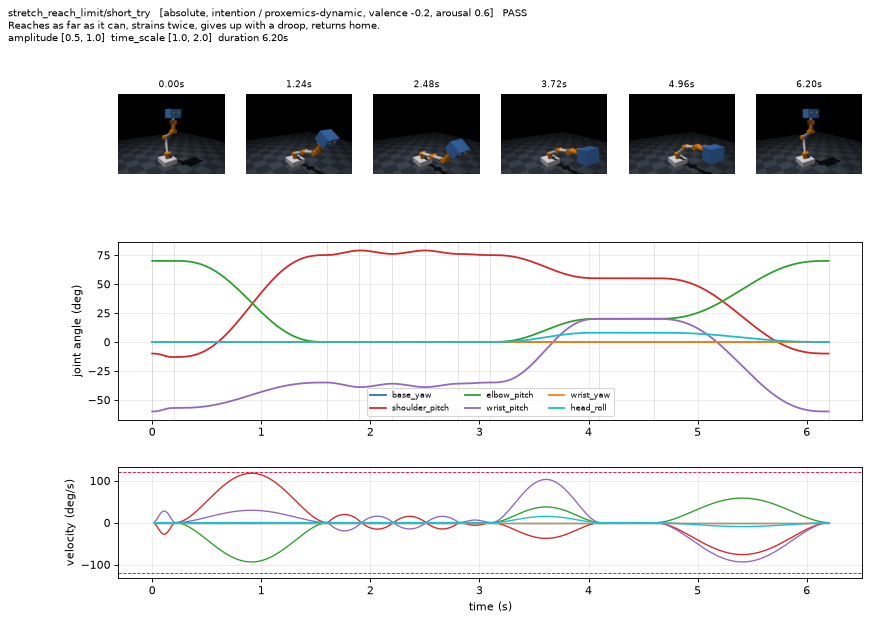
tools/motion_lib/review/clips/stretch_reach_limit__short_try.png
