Victor-JB/IEEE-Minimalist-AI-Challenge-2026/tools/motion_lib/review/clips/tail_wag__big.png

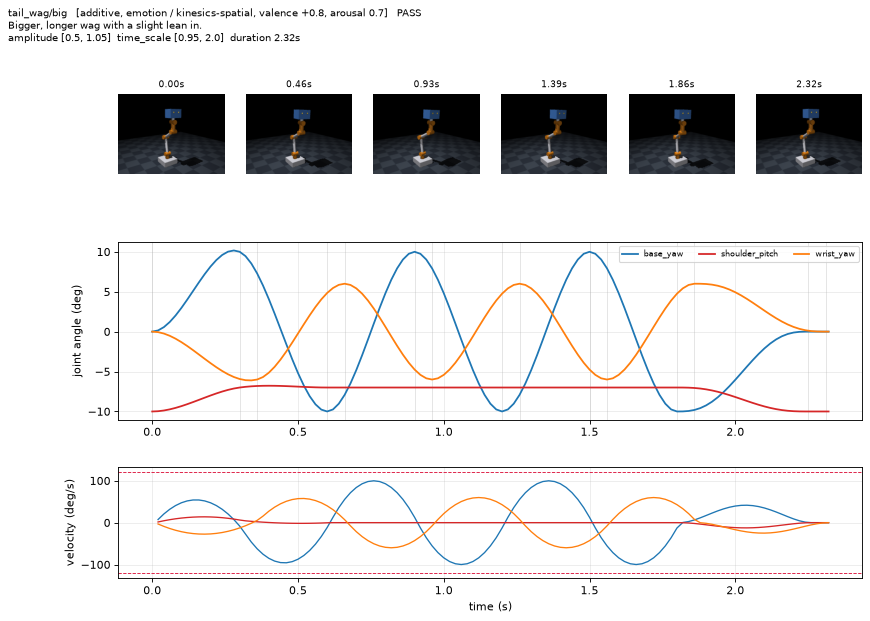
tools/motion_lib/review/clips/tail_wag__big.png
