Victor-JB/IEEE-Minimalist-AI-Challenge-2026/tools/motion_lib/review/clips/wake_up__slow_groggy.png

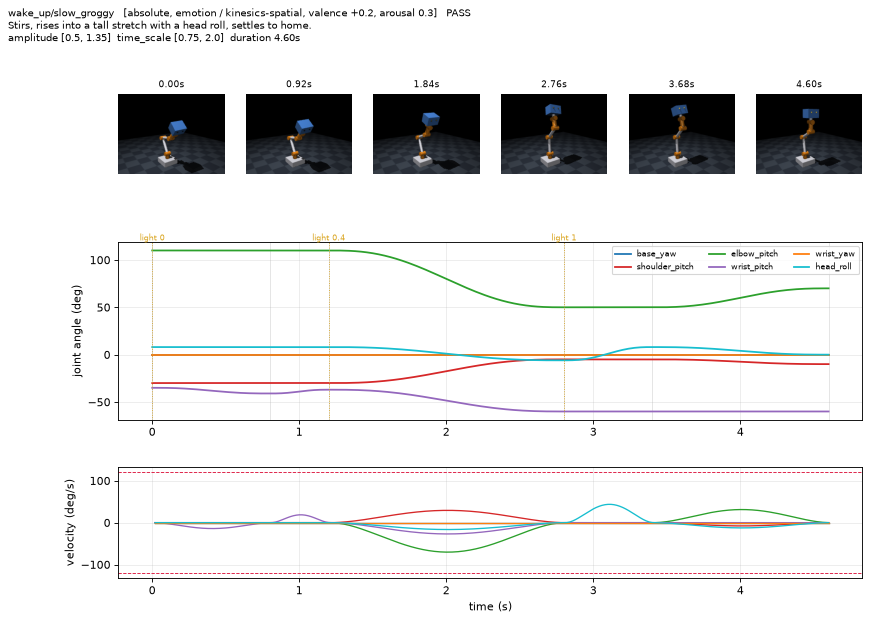
tools/motion_lib/review/clips/wake_up__slow_groggy.png
