Victor-JB/IEEE-Minimalist-AI-Challenge-2026/arm/cad/01_housing_center_housing_red.stl

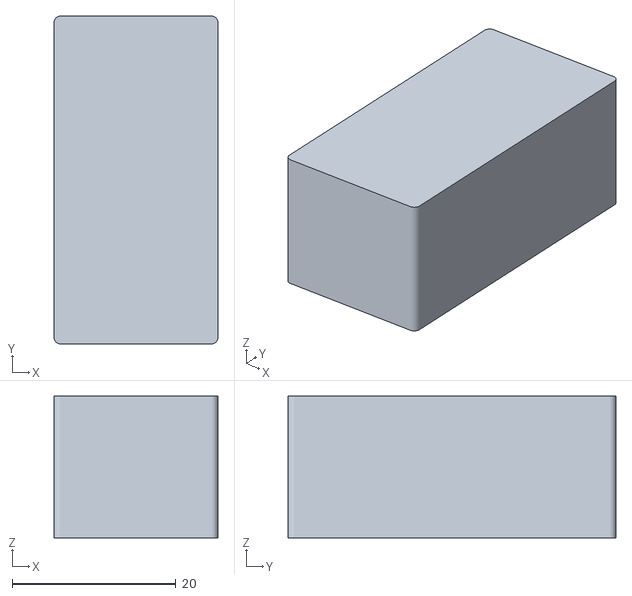
[picture p69: CAD file, 2026-10-12]
arm/cad/01_housing_center_housing_red.stl
20.0 x 40.0 x 17.3
