Victor-JB/IEEE-Minimalist-AI-Challenge-2026/arm_mujoco/meshes/cam_a_c_body1.stl

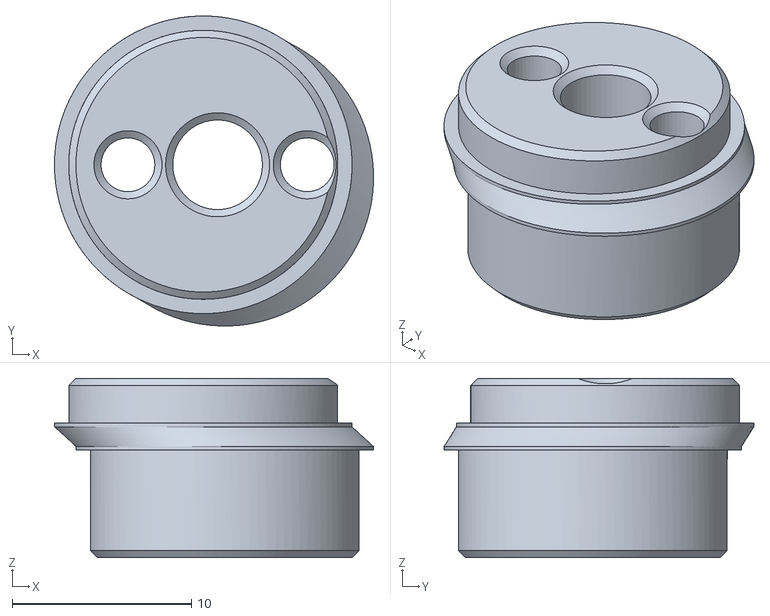
[picture p70: CAD file, 2026-10-12]
arm_mujoco/meshes/cam_a_c_body1.stl
17.8 x 17.3 x 10.0
