Victor-JB/IEEE-Minimalist-AI-Challenge-2026/arm/cad/17hs4023_stepper_42x23_stator.stl

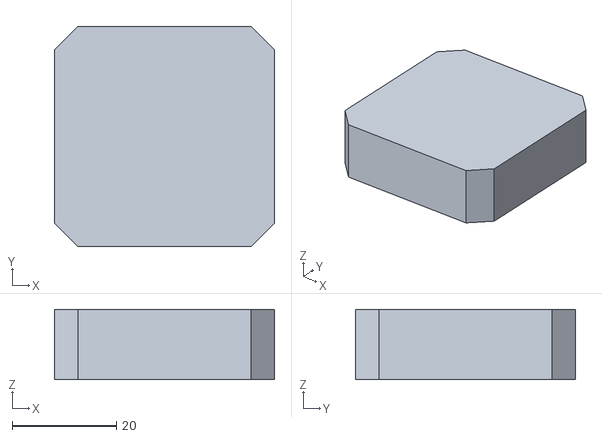
[picture p71: CAD file, 2026-10-12]
arm/cad/17hs4023_stepper_42x23_stator.stl
42.3 x 42.3 x 13.5
