Victor-JB/IEEE-Minimalist-AI-Challenge-2026/arm_mujoco/meshes/02_output_shaft_and_horn_output_shaft_brass_spline_envelope.stl

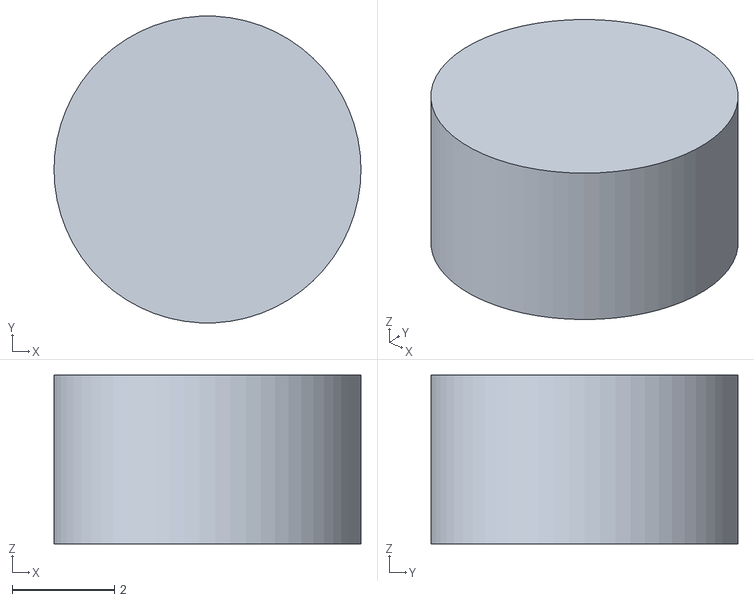
[picture p72: CAD file, 2026-10-12]
arm_mujoco/meshes/02_output_shaft_and_horn_output_shaft_brass_spline_envelope.stl
6.00 x 5.99 x 3.30
