Victor-JB/IEEE-Minimalist-AI-Challenge-2026/tools/arm_mujoco/meshes/base_base_plate_underside_motor_bracket.stl

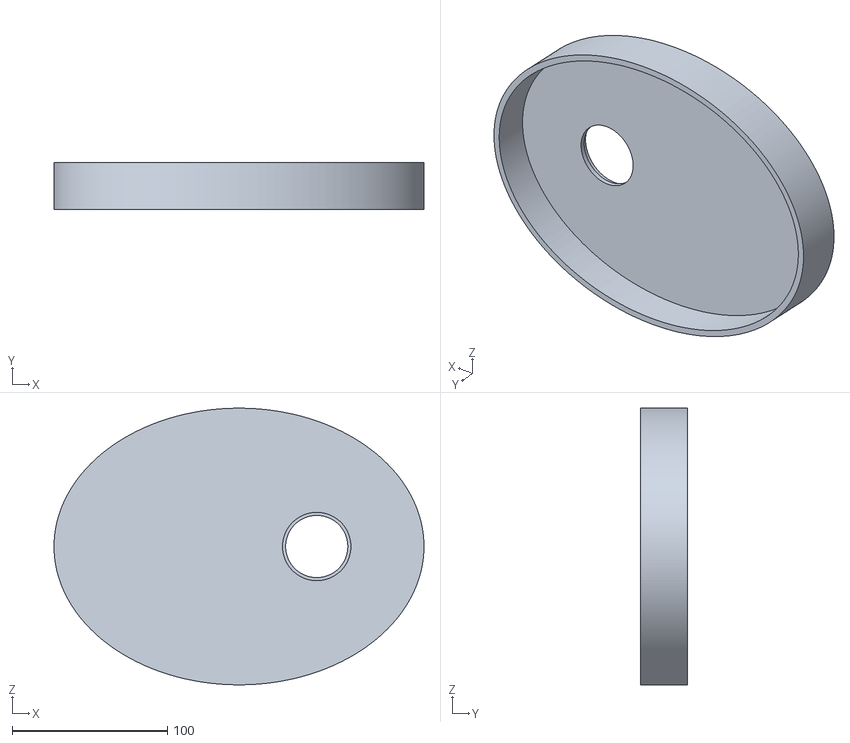
[picture p73: CAD file, 2026-10-12]
tools/arm_mujoco/meshes/base_base_plate_underside_motor_bracket.stl
238.0 x 30.0 x 178.0
