Victor-JB/IEEE-Minimalist-AI-Challenge-2026/arm_mujoco/meshes/17hs4023_stepper_42x23_rear_end_cap.stl

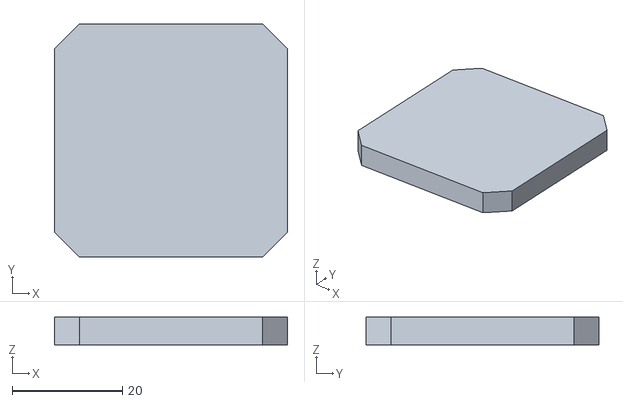
[picture p74: CAD file, 2026-10-12]
arm_mujoco/meshes/17hs4023_stepper_42x23_rear_end_cap.stl
42.3 x 42.3 x 5.00
