Victor-JB/IEEE-Minimalist-AI-Challenge-2026/tools/arm_mujoco/meshes/bearing_1_body1.stl

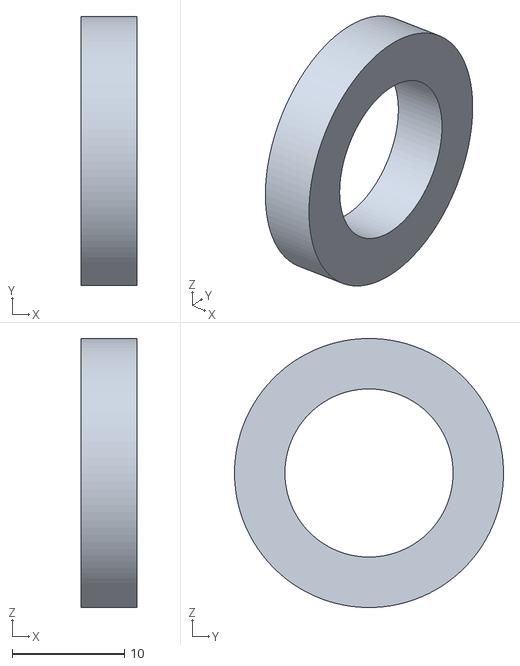
[picture p75: CAD file, 2026-10-12]
tools/arm_mujoco/meshes/bearing_1_body1.stl
5.00 x 24.0 x 24.0
