Victor-JB/IEEE-Minimalist-AI-Challenge-2026/tools/arm_mujoco/meshes/base_drive_20t_pinion_20t_pinion_with_d_shaft_hub.stl

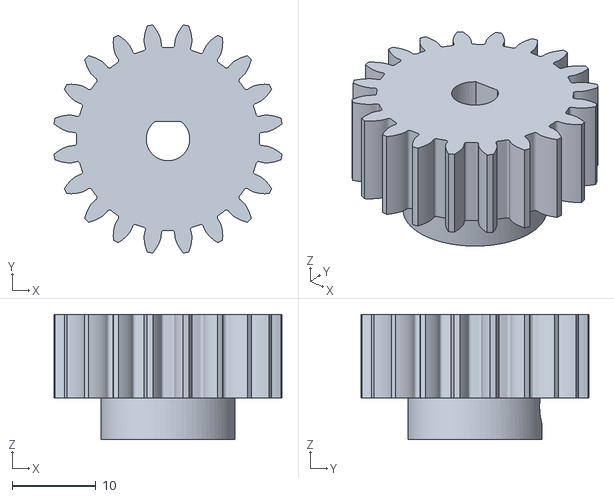
[picture p76: CAD file, 2026-10-12]
tools/arm_mujoco/meshes/base_drive_20t_pinion_20t_pinion_with_d_shaft_hub.stl
27.3 x 27.3 x 15.0
