Victor-JB/IEEE-Minimalist-AI-Challenge-2026/tools/arm_mujoco/meshes/ring_b_body1.stl

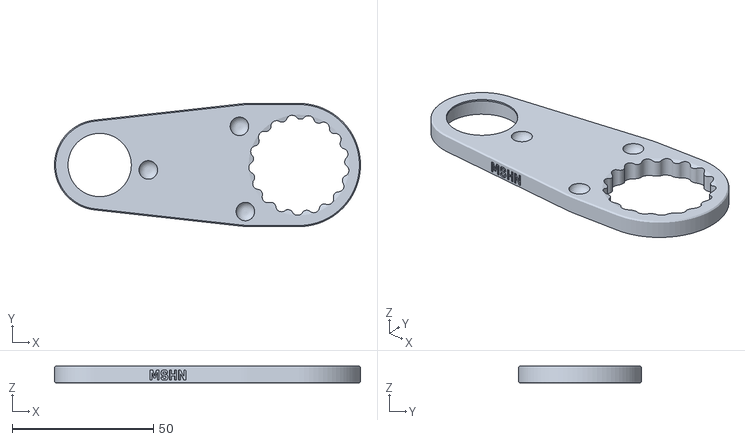
[picture p77: CAD file, 2026-10-12]
tools/arm_mujoco/meshes/ring_b_body1.stl
108.3 x 43.6 x 6.00
