Victor-JB/IEEE-Minimalist-AI-Challenge-2026/tools/arm_mujoco/meshes/ring_a_body1_2.stl

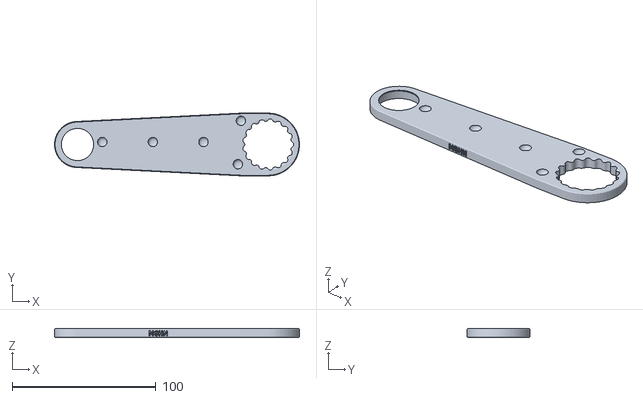
[picture p78: CAD file, 2026-10-12]
tools/arm_mujoco/meshes/ring_a_body1_2.stl
170.3 x 43.6 x 6.00
