Victor-JB/IEEE-Minimalist-AI-Challenge-2026/tools/arm_mujoco/meshes/stepper_body1.stl

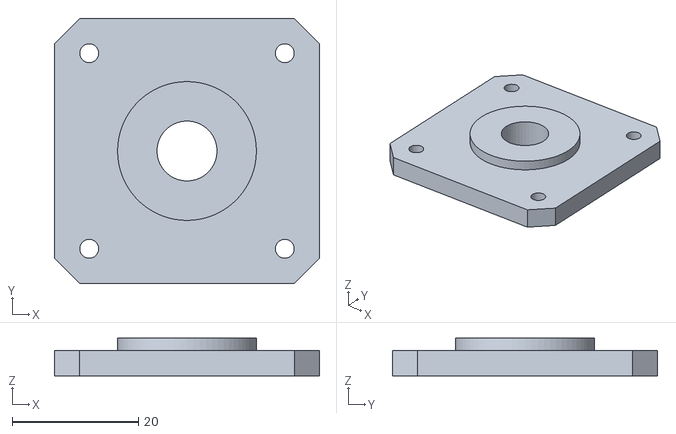
[picture p79: CAD file, 2026-10-12]
tools/arm_mujoco/meshes/stepper_body1.stl
42.0 x 42.0 x 6.00
