Victor-JB/IEEE-Minimalist-AI-Challenge-2026/tools/arm_mujoco/meshes/enclosuretop_body1.stl

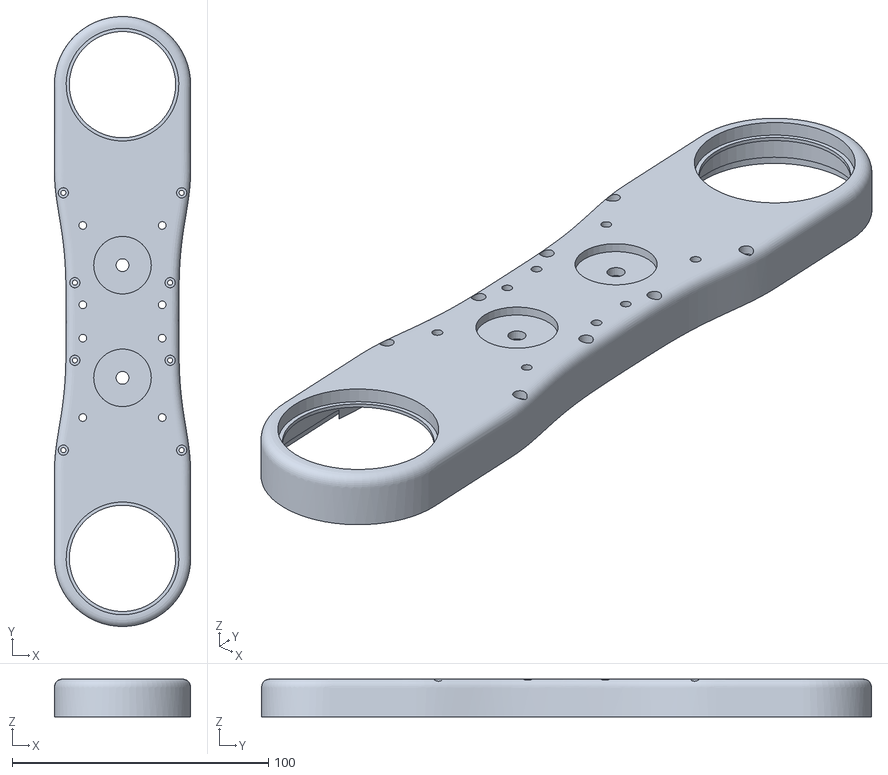
[picture p80: CAD file, 2026-10-12]
tools/arm_mujoco/meshes/enclosuretop_body1.stl
53.2 x 238.2 x 14.8
