Victor-JB/IEEE-Minimalist-AI-Challenge-2026/tools/arm_mujoco/meshes/17hs4023_stepper_42x23_shaft.stl

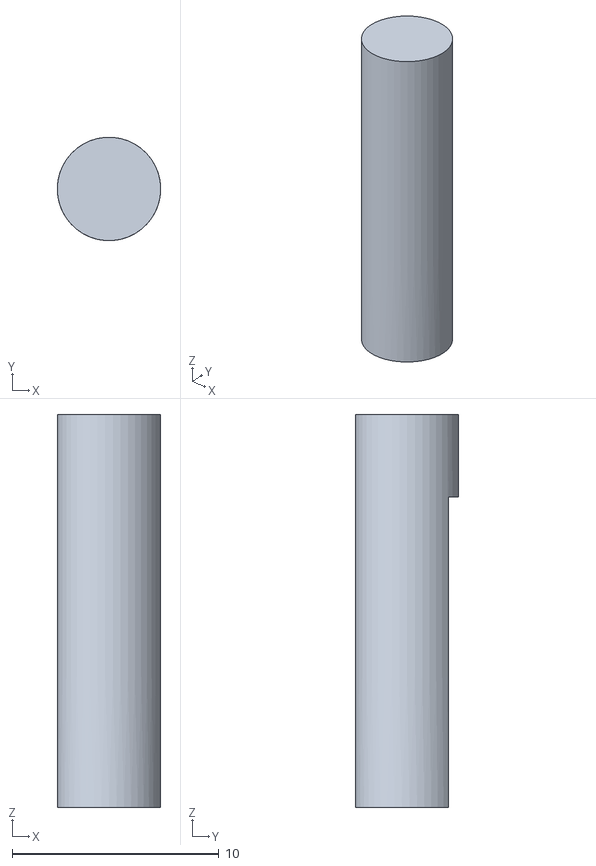
[picture p81: CAD file, 2026-10-12]
tools/arm_mujoco/meshes/17hs4023_stepper_42x23_shaft.stl
5.00 x 4.99 x 19.0
