Victor-JB/IEEE-Minimalist-AI-Challenge-2026/tools/arm_mujoco/meshes/shelltop_body9.stl

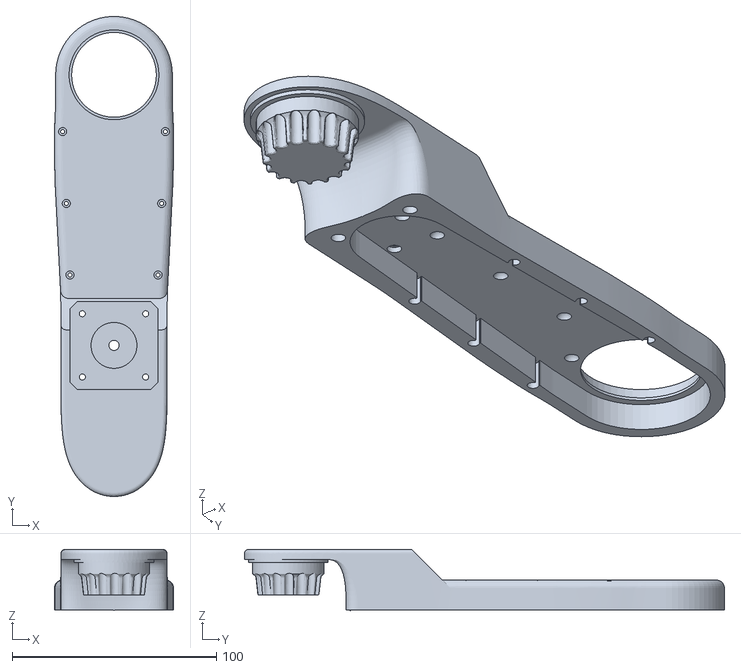
[picture p82: CAD file, 2026-10-12]
tools/arm_mujoco/meshes/shelltop_body9.stl
58.4 x 235.1 x 30.0
