Victor-JB/IEEE-Minimalist-AI-Challenge-2026/tools/arm_mujoco/meshes/17hs4023_stepper_42x23_front_end_cap.stl

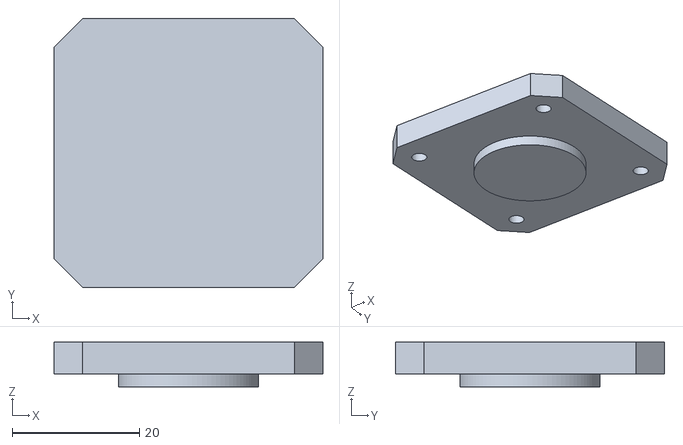
[picture p83: CAD file, 2026-10-12]
tools/arm_mujoco/meshes/17hs4023_stepper_42x23_front_end_cap.stl
42.3 x 42.3 x 7.00
