Victor-JB/IEEE-Minimalist-AI-Challenge-2026/(list of files, cad)

Other CAD files:
tools/arm_mujoco/meshes/cam_a_b_mirror_body1.stl
tools/arm_mujoco/meshes/cam_a_c_body1_2.stl
tools/arm_mujoco/meshes/ring_b_mirror_body1.stl
tools/arm_mujoco/meshes/cam_a_b_body1.stl
tools/arm_mujoco/meshes/ring_a_mirror_body1.stl
tools/arm_mujoco/meshes/ring_b_body1_2.stl
tools/arm_mujoco/meshes/cam_bearing_body1_2.stl
tools/arm_mujoco/meshes/cam_bearing_mirror_body1.stl
