Victor-JB/IEEE-Minimalist-AI-Challenge-2026/tools/arm_mujoco/stepper_step.png

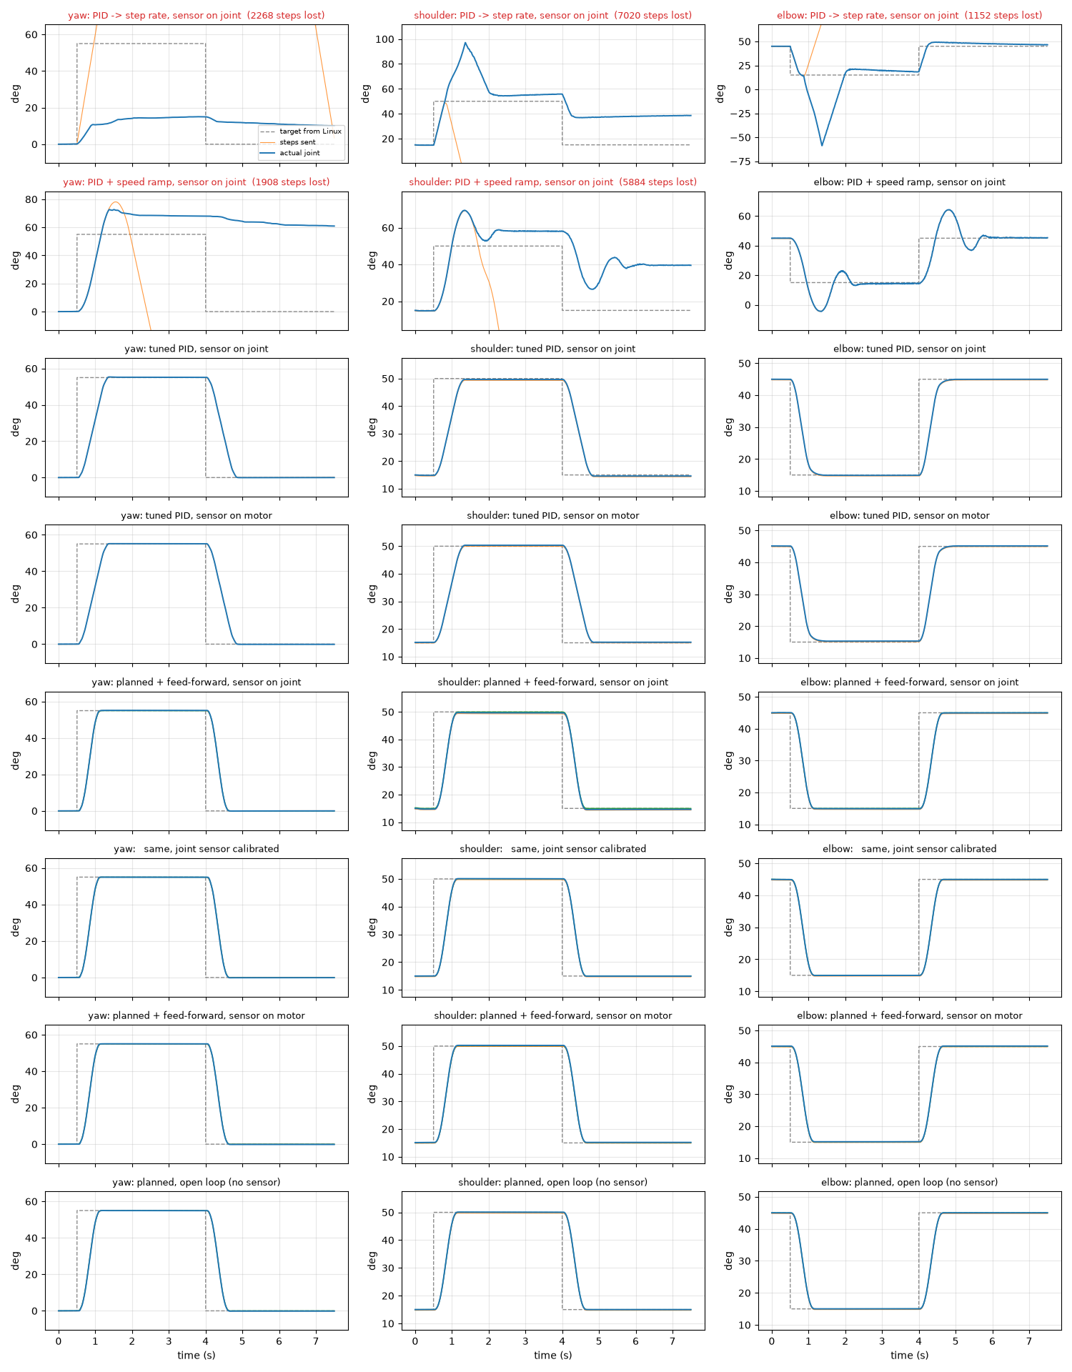
tools/arm_mujoco/stepper_step.png
