Victor-JB/IEEE-Minimalist-AI-Challenge-2026/motion_lib/validation_report.md

# Clip validation report

Generated by `python motion_lib/validate.py`. Limits come from `sim/robot.toml`: 120 deg/s, 2500 deg/s^2, 100000 deg/s^3, 3 deg joint margin, 50 Hz.

**58 pass, 4 warn, 0 fail** of 62 clip variants.

- PASS: clean at default params from home / entry pose and from every sampled start pose.
- WARN: clean from home, but fails from some sampled start poses (usually joint-limit headroom).
- FAIL: fails at default params; do not use until fixed in author.py.
- Grid: amplitude x time_scale, from home or the entry pose. Ranges are shrunk until every corner passes; reasons are in the notes.

| clip | variant | status | grid pass | amplitude | time_scale | peak vel | peak torque | notes |
|---|---|---|---|---|---|---|---|---|
| approach_object | cautious | PASS | 9/9 | 0.5-1.5 | 0.5-2 | 30.0 | 0.54 N*m (shoulder_pitch) |  |
| approach_object | eager | PASS | 9/9 | 0.5-1.5 | 0.5-2 | 42.7 | 0.69 N*m (shoulder_pitch) |  |
| avoid_object | mild | PASS | 8/9 | 0.5-1.4 | 0.6-2 | 58.9 | 0.51 N*m (wrist_yaw) | corner: amplitude max -> 1.4 with time_scale min -> 0.6: velocity 149 deg/s on wrist_yaw > 120 |
| avoid_object | strong | WARN | 5/9 | 0.5-1.2 | 1-2 | 102.1 | 0.89 N*m (wrist_yaw) | amplitude max 1.5 -> 1.3: velocity 128 deg/s on wrist_yaw > 120<br>time_scale min 0.5 -> 0.9: velocity 204 deg/s on wrist_yaw > 120<br>corner: amplitude max -> 1.2 with time_scale min -> 1: velocity 130 deg/s on wrist_yaw > 120<br>fails from 2/10 sampled start poses (first: start #4: elbow_pitch reaches 118.0 (limit 120 - 3 margin)); a selector must check headroom first |
| celebrate | big | PASS | 5/9 | 0.5-1 | 1-2 | 119.8 | 1.22 N*m (elbow_pitch) | amplitude max 1.5 -> 1: velocity 180 deg/s on head_roll > 120<br>time_scale min 0.5 -> 1: velocity 238 deg/s on head_roll > 120 |
| celebrate | medium | PASS | 6/9 | 0.5-1.05 | 0.95-2 | 108.1 | 1.22 N*m (elbow_pitch) | amplitude max 1.5 -> 1.05: velocity 162 deg/s on elbow_pitch > 120<br>time_scale min 0.5 -> 0.95: velocity 214 deg/s on elbow_pitch > 120 |
| confident_snap | emphatic | PASS | 5/9 | 0.5-1 | 1-2 | 112.1 | 0.96 N*m (wrist_pitch) | amplitude max 1.5 -> 1.05: velocity 168 deg/s on wrist_pitch > 120<br>time_scale min 0.5 -> 0.95: velocity 219 deg/s on wrist_pitch > 120<br>corner: amplitude max -> 1 with time_scale min -> 1: velocity 123 deg/s on wrist_pitch > 120 |
| confident_snap | firm | PASS | 5/9 | 0.5-1 | 1-2 | 114.9 | 0.98 N*m (wrist_pitch) | amplitude max 1.5 -> 1: velocity 172 deg/s on wrist_pitch > 120<br>time_scale min 0.5 -> 1: velocity 226 deg/s on wrist_pitch > 120 |
| curious_head_tilt | double | PASS | 7/9 | 0.5-1.3 | 0.85-2 | 74.9 | 0.66 N*m (head_roll) | time_scale min 0.5 -> 0.65: velocity 149 deg/s on head_roll > 120<br>corner: amplitude max -> 1.3 with time_scale min -> 0.85: velocity 172 deg/s on head_roll > 120 |
| curious_head_tilt | single | PASS | 6/9 | 0.5-1.25 | 0.9-2 | 80.7 | 0.69 N*m (head_roll) | amplitude max 1.5 -> 1.45: velocity 121 deg/s on head_roll > 120<br>time_scale min 0.5 -> 0.7: velocity 159 deg/s on head_roll > 120<br>corner: amplitude max -> 1.25 with time_scale min -> 0.9: velocity 166 deg/s on head_roll > 120 |
| dance_110 | groove | PASS | 9/9 | 0.5-1.5 | 1-1 | 27.5 | 0.59 N*m (elbow_pitch) |  |
| dance_110 | party | PASS | 8/9 | 0.5-1.5 | 1-1 | 44.0 | 0.74 N*m (elbow_pitch) |  |
| dance_128 | groove | PASS | 8/9 | 0.5-1.5 | 1-1 | 32.0 | 0.63 N*m (elbow_pitch) |  |
| dance_128 | party | PASS | 7/9 | 0.5-1.5 | 1-1 | 51.2 | 0.80 N*m (elbow_pitch) |  |
| dance_90 | groove | PASS | 9/9 | 0.5-1.5 | 1-1 | 22.5 | 0.54 N*m (elbow_pitch) |  |
| dance_90 | party | PASS | 9/9 | 0.5-1.5 | 1-1 | 36.0 | 0.67 N*m (elbow_pitch) |  |
| double_take | big | PASS | 6/9 | 0.5-1 | 1-2 | 117.4 | 1.02 N*m (wrist_yaw) | amplitude max 1.5 -> 1: velocity 176 deg/s on wrist_yaw > 120<br>time_scale min 0.5 -> 1: velocity 233 deg/s on wrist_yaw > 120 |
| double_take | subtle | PASS | 6/9 | 0.5-1.05 | 0.95-2 | 106.7 | 0.92 N*m (wrist_yaw) | amplitude max 1.5 -> 1.05: velocity 160 deg/s on wrist_yaw > 120<br>time_scale min 0.5 -> 0.95: velocity 212 deg/s on wrist_yaw > 120 |
| excited_bounce | big_eager | PASS | 5/9 | 0.5-1 | 1-2 | 111.0 | 1.26 N*m (elbow_pitch) | amplitude max 1.5 -> 1.05: velocity 167 deg/s on elbow_pitch > 120<br>time_scale min 0.5 -> 0.95: velocity 222 deg/s on elbow_pitch > 120<br>corner: amplitude max -> 1 with time_scale min -> 1: velocity 124 deg/s on elbow_pitch > 120 |
| excited_bounce | medium | PASS | 5/9 | 0.5-1.2 | 0.95-2 | 88.8 | 1.07 N*m (elbow_pitch) | amplitude max 1.5 -> 1.3: velocity 133 deg/s on elbow_pitch > 120<br>time_scale min 0.5 -> 0.85: velocity 178 deg/s on elbow_pitch > 120<br>corner: amplitude max -> 1.2 with time_scale min -> 0.95: velocity 137 deg/s on elbow_pitch > 120 |
| glance_then_reach | left | PASS | 6/9 | 0.5-1 | 1-2 | 116.4 | 1.01 N*m (wrist_yaw) | amplitude max 1.5 -> 1: velocity 175 deg/s on wrist_yaw > 120<br>time_scale min 0.5 -> 1: velocity 232 deg/s on wrist_yaw > 120 |
| glance_then_reach | right | PASS | 6/9 | 0.5-1 | 1-2 | 116.4 | 1.01 N*m (wrist_yaw) | amplitude max 1.5 -> 1: velocity 175 deg/s on wrist_yaw > 120<br>time_scale min 0.5 -> 1: velocity 232 deg/s on wrist_yaw > 120 |
| go_to_sleep | drowsy | PASS | 9/9 | 0.5-1.5 | 0.5-2 | 35.4 | 0.54 N*m (elbow_pitch) |  |
| go_to_sleep | quick | PASS | 6/9 | 0.5-1.3 | 0.5-2 | 50.4 | 0.67 N*m (elbow_pitch) | amplitude max 1.5 -> 1.3: elbow_pitch reaches 118.5 (limit 120 - 3 margin) |
| hesitate | subtle | PASS | 9/9 | 0.5-1.5 | 0.5-2 | 28.1 | 0.54 N*m (shoulder_pitch) |  |
| hesitate | unsure | PASS | 8/9 | 0.5-1.45 | 0.55-2 | 41.6 | 0.68 N*m (shoulder_pitch) | corner: amplitude max -> 1.45 with time_scale min -> 0.55: velocity 123 deg/s on shoulder_pitch > 120 |
| home | brisk | PASS | 9/9 | 1-1 | 0.5-2 | 0.0 | 0.34 N*m (elbow_pitch) |  |
| home | gentle | PASS | 9/9 | 1-1 | 0.5-2 | 0.0 | 0.34 N*m (elbow_pitch) |  |
| idle_breathe | alert | PASS | 9/9 | 0.5-1.5 | 0.5-2 | 2.9 | 0.36 N*m (elbow_pitch) |  |
| idle_breathe | calm | PASS | 9/9 | 0.5-1.5 | 0.5-2 | 2.6 | 0.36 N*m (elbow_pitch) |  |
| lean_in_interest | deep | PASS | 9/9 | 0.5-1.5 | 0.5-2 | 34.1 | 0.72 N*m (shoulder_pitch) |  |
| lean_in_interest | subtle | PASS | 9/9 | 0.5-1.5 | 0.5-2 | 25.0 | 0.57 N*m (shoulder_pitch) |  |
| look_at_user_return | quick_left | PASS | 6/9 | 0.5-1 | 1-2 | 116.4 | 1.01 N*m (wrist_yaw) | amplitude max 1.5 -> 1: velocity 175 deg/s on wrist_yaw > 120<br>time_scale min 0.5 -> 1: velocity 232 deg/s on wrist_yaw > 120 |
| look_at_user_return | slow_right | PASS | 6/9 | 0.5-1 | 1-2 | 116.4 | 1.01 N*m (wrist_yaw) | amplitude max 1.5 -> 1: velocity 175 deg/s on wrist_yaw > 120<br>time_scale min 0.5 -> 1: velocity 232 deg/s on wrist_yaw > 120 |
| nod_yes | big_eager | PASS | 6/9 | 0.5-1 | 1-2 | 117.4 | 1.06 N*m (wrist_pitch) | amplitude max 1.5 -> 1: velocity 176 deg/s on wrist_pitch > 120<br>time_scale min 0.5 -> 1: velocity 230 deg/s on wrist_pitch > 120 |
| nod_yes | medium | PASS | 6/9 | 0.5-1 | 1-2 | 111.2 | 0.94 N*m (wrist_pitch) | amplitude max 1.5 -> 1.05: velocity 167 deg/s on wrist_pitch > 120<br>time_scale min 0.5 -> 0.95: velocity 222 deg/s on wrist_pitch > 120<br>corner: amplitude max -> 1 with time_scale min -> 1: velocity 124 deg/s on wrist_pitch > 120 |
| nod_yes | small_calm | PASS | 7/9 | 0.5-1.35 | 0.75-2 | 65.2 | 0.60 N*m (wrist_pitch) | time_scale min 0.5 -> 0.6: velocity 128 deg/s on wrist_pitch > 120<br>corner: amplitude max -> 1.35 with time_scale min -> 0.75: velocity 161 deg/s on wrist_pitch > 120 |
| nuzzle_touch | affectionate | PASS | 9/9 | 0.5-1.5 | 0.5-2 | 40.0 | 0.72 N*m (shoulder_pitch) |  |
| nuzzle_touch | gentle | PASS | 9/9 | 0.5-1.5 | 0.5-2 | 34.5 | 0.66 N*m (shoulder_pitch) |  |
| perk_up | big | PASS | 6/9 | 0.5-1.1 | 0.95-2 | 97.3 | 1.15 N*m (elbow_pitch) | amplitude max 1.5 -> 1.2: velocity 146 deg/s on elbow_pitch > 120<br>time_scale min 0.5 -> 0.85: velocity 193 deg/s on elbow_pitch > 120<br>corner: amplitude max -> 1.1 with time_scale min -> 0.95: velocity 137 deg/s on elbow_pitch > 120 |
| perk_up | small | PASS | 7/9 | 0.5-1.35 | 0.75-2 | 65.6 | 0.88 N*m (elbow_pitch) | time_scale min 0.5 -> 0.6: velocity 129 deg/s on elbow_pitch > 120<br>corner: amplitude max -> 1.35 with time_scale min -> 0.75: velocity 163 deg/s on elbow_pitch > 120 |
| point_with_head | left_small | PASS | 6/9 | 0.5-1.25 | 0.9-2 | 83.1 | 0.72 N*m (wrist_yaw) | amplitude max 1.5 -> 1.4: velocity 125 deg/s on wrist_yaw > 120<br>time_scale min 0.5 -> 0.75: velocity 166 deg/s on wrist_yaw > 120<br>corner: amplitude max -> 1.25 with time_scale min -> 0.9: velocity 155 deg/s on wrist_yaw > 120 |
| point_with_head | right_big | PASS | 6/9 | 0.5-1.15 | 0.9-2 | 93.7 | 0.95 N*m (shoulder_pitch) | amplitude max 1.5 -> 1.25: velocity 140 deg/s on wrist_yaw > 120<br>time_scale min 0.5 -> 0.8: velocity 186 deg/s on wrist_yaw > 120<br>corner: amplitude max -> 1.15 with time_scale min -> 0.9: velocity 146 deg/s on wrist_yaw > 120 |
| relaxed_sit_down | calm | PASS | 8/9 | 0.5-1.45 | 0.55-2 | 49.2 | 0.50 N*m (elbow_pitch) | corner: amplitude max -> 1.45 with time_scale min -> 0.55: velocity 122 deg/s on elbow_pitch > 120 |
| relaxed_sit_down | quick_plop | PASS | 4/9 | 0.5-1 | 1-2 | 112.4 | 0.77 N*m (elbow_pitch) | amplitude max 1.5 -> 1.05: elbow_pitch reaches 121.5 (limit 120 - 3 margin)<br>time_scale min 0.5 -> 0.95: velocity 224 deg/s on elbow_pitch > 120<br>corner: amplitude max -> 1 with time_scale min -> 1: velocity 122 deg/s on elbow_pitch > 120 |
| sad_droop | deep | WARN | 9/9 | 0.5-1.5 | 0.5-2 | 20.8 | 0.68 N*m (elbow_pitch) | fails from 3/10 sampled start poses (first: start #4: elbow_pitch reaches 127.0 (limit 120 - 3 margin)); a selector must check headroom first |
| sad_droop | slight | WARN | 9/9 | 0.5-1.5 | 0.5-2 | 16.1 | 0.59 N*m (elbow_pitch) | fails from 2/10 sampled start poses (first: start #4: elbow_pitch reaches 119.0 (limit 120 - 3 margin)); a selector must check headroom first |
| scan_room | alert | PASS | 5/9 | 0.5-1.05 | 0.95-2 | 107.1 | 0.93 N*m (base_yaw) | amplitude max 1.5 -> 1.05: velocity 161 deg/s on base_yaw > 120<br>time_scale min 0.5 -> 0.95: velocity 214 deg/s on base_yaw > 120 |
| scan_room | calm | PASS | 7/9 | 0.5-1.3 | 0.75-2 | 62.5 | 0.55 N*m (base_yaw) | time_scale min 0.5 -> 0.55: velocity 125 deg/s on base_yaw > 120<br>corner: amplitude max -> 1.3 with time_scale min -> 0.75: velocity 170 deg/s on base_yaw > 120 |
| shake_no | big_emphatic | PASS | 6/9 | 0.5-1.15 | 0.95-2 | 94.3 | 0.82 N*m (wrist_yaw) | amplitude max 1.5 -> 1.25: velocity 141 deg/s on wrist_yaw > 120<br>time_scale min 0.5 -> 0.85: velocity 188 deg/s on wrist_yaw > 120<br>corner: amplitude max -> 1.15 with time_scale min -> 0.95: velocity 138 deg/s on wrist_yaw > 120 |
| shake_no | medium | PASS | 6/9 | 0.5-1.15 | 0.95-2 | 94.1 | 0.82 N*m (wrist_yaw) | amplitude max 1.5 -> 1.25: velocity 141 deg/s on wrist_yaw > 120<br>time_scale min 0.5 -> 0.85: velocity 187 deg/s on wrist_yaw > 120<br>corner: amplitude max -> 1.15 with time_scale min -> 0.95: velocity 138 deg/s on wrist_yaw > 120 |
| shake_no | small_calm | PASS | 6/9 | 0.5-1.15 | 0.95-2 | 95.7 | 0.83 N*m (wrist_yaw) | amplitude max 1.5 -> 1.25: velocity 144 deg/s on wrist_yaw > 120<br>time_scale min 0.5 -> 0.85: velocity 189 deg/s on wrist_yaw > 120<br>corner: amplitude max -> 1.15 with time_scale min -> 0.95: velocity 141 deg/s on wrist_yaw > 120 |
| shrug_fail | big | PASS | 8/9 | 0.5-1.4 | 0.6-2 | 46.7 | 0.68 N*m (elbow_pitch) | corner: amplitude max -> 1.4 with time_scale min -> 0.6: velocity 138 deg/s on head_roll > 120 |
| shrug_fail | small | PASS | 9/9 | 0.5-1.5 | 0.5-2 | 36.5 | 0.60 N*m (elbow_pitch) |  |
| startle_recoil | big | WARN | 5/9 | 0.5-1 | 1-2 | 111.9 | 1.96 N*m (shoulder_pitch) | amplitude max 1.5 -> 1.05: velocity 168 deg/s on wrist_pitch > 120<br>time_scale min 0.5 -> 0.95: velocity 217 deg/s on wrist_pitch > 120<br>corner: amplitude max -> 1 with time_scale min -> 1: velocity 123 deg/s on shoulder_pitch > 120<br>fails from 4/10 sampled start poses (first: start #0: wrist_pitch reaches -90.2 (limit -90 + 3 margin)); a selector must check headroom first |
| startle_recoil | small | PASS | 5/9 | 0.5-1.15 | 0.95-2 | 95.5 | 1.83 N*m (shoulder_pitch) | amplitude max 1.5 -> 1.25: velocity 143 deg/s on shoulder_pitch > 120<br>time_scale min 0.5 -> 0.85: velocity 176 deg/s on shoulder_pitch > 120<br>corner: amplitude max -> 1.15 with time_scale min -> 0.95: velocity 141 deg/s on shoulder_pitch > 120 |
| stretch_reach_limit | persistent | PASS | 5/9 | 0.5-1 | 1-2 | 117.8 | 1.60 N*m (shoulder_pitch) | amplitude max 1.5 -> 1: shoulder_pitch reaches 123.5 (limit 90 - 3 margin)<br>time_scale min 0.5 -> 1: velocity 236 deg/s on shoulder_pitch > 120 |
| stretch_reach_limit | short_try | PASS | 5/9 | 0.5-1 | 1-2 | 117.8 | 1.60 N*m (shoulder_pitch) | amplitude max 1.5 -> 1: shoulder_pitch reaches 123.5 (limit 90 - 3 margin)<br>time_scale min 0.5 -> 1: velocity 236 deg/s on shoulder_pitch > 120 |
| tail_wag | big | PASS | 6/9 | 0.5-1.05 | 0.95-2 | 99.9 | 0.87 N*m (base_yaw) | amplitude max 1.5 -> 1.15: velocity 150 deg/s on base_yaw > 120<br>time_scale min 0.5 -> 0.85: velocity 198 deg/s on base_yaw > 120<br>corner: amplitude max -> 1.05 with time_scale min -> 0.95: velocity 135 deg/s on base_yaw > 120 |
| tail_wag | small | PASS | 7/9 | 0.5-1.35 | 0.75-2 | 63.8 | 0.56 N*m (base_yaw) | time_scale min 0.5 -> 0.6: velocity 128 deg/s on base_yaw > 120<br>corner: amplitude max -> 1.35 with time_scale min -> 0.75: velocity 160 deg/s on base_yaw > 120 |
| wake_up | quick_bright | PASS | 5/9 | 0.5-1.1 | 1-2 | 106.1 | 1.38 N*m (elbow_pitch) | amplitude max 1.5 -> 1.15: velocity 142 deg/s on elbow_pitch > 120<br>time_scale min 0.5 -> 0.95: velocity 212 deg/s on elbow_pitch > 120<br>corner: amplitude max -> 1.1 with time_scale min -> 1: velocity 123 deg/s on elbow_pitch > 120 |
| wake_up | slow_groggy | PASS | 7/9 | 0.5-1.35 | 0.75-2 | 70.3 | 1.03 N*m (elbow_pitch) | time_scale min 0.5 -> 0.6: velocity 140 deg/s on elbow_pitch > 120<br>corner: amplitude max -> 1.35 with time_scale min -> 0.75: velocity 162 deg/s on elbow_pitch > 120 |
