Victor-JB/IEEE-Minimalist-AI-Challenge-2026/arm_mujoco/robot_arm.xml

<!-- Robot arm (ARM v29) for MuJoCo, generated by build_mjcf.py from the Fusion design. -->
<!-- Units: m, kg, s, rad. Fusion -Y (up) is mapped to MuJoCo +Z. Home pose = all joints 0 = arm straight up. -->
<mujoco model="robot_arm">
  <compiler angle="radian" meshdir="meshes" autolimits="true"/>
  <option timestep="0.0005" integrator="implicitfast"/>
  <visual><global offwidth="1600" offheight="1200"/><quality shadowsize="4096"/></visual>
  <default>
    <mesh scale="0.001 0.001 0.001" inertia="exact"/>
    <geom type="mesh"/>
    <default class="visual"><geom contype="0" conaffinity="0" group="2"/></default>
    <default class="solid"><geom contype="1" conaffinity="1" group="2" condim="3" friction="0.6 0.01 0.001" solref="0.004 1" solimp="0.95 0.99 0.001"/></default>
    <default class="shell"><geom contype="1" conaffinity="1" group="1" condim="3" friction="0.6 0.01 0.001" solref="0.004 1" solimp="0.95 0.99 0.001"/></default>
    <default class="gear"><equality solref="0.001 1" solimp="0.95 0.99 0.001"/></default>
  </default>
  <asset>
    <texture name="grid" type="2d" builtin="checker" rgb1="0.82 0.82 0.80" rgb2="0.70 0.70 0.68" width="512" height="512"/>
    <material name="floor" texture="grid" texrepeat="8 8" reflectance="0.05"/>
    <texture name="sky" type="skybox" builtin="gradient" rgb1="0.6 0.75 0.9" rgb2="0.15 0.2 0.3" width="256" height="256"/>
    <material name="pla_base" rgba="0.25 0.29 0.62 1" specular="0.2" shininess="0.2"/>
    <material name="pla_base_pinion" rgba="0.95 0.65 0.25 1" specular="0.2" shininess="0.2"/>
    <material name="pla_yaw_spindle" rgba="0.86 0.80 0.25 1" specular="0.2" shininess="0.2"/>
    <material name="pla_first_link" rgba="0.40 0.75 0.85 1" specular="0.2" shininess="0.2"/>
    <material name="pla_second_link" rgba="0.93 0.45 0.30 1" specular="0.2" shininess="0.2"/>
    <material name="pla_head" rgba="0.30 0.45 0.80 1" specular="0.2" shininess="0.2"/>
    <material name="pla_head_tilt" rgba="0.96 0.65 0.30 1" specular="0.2" shininess="0.2"/>
    <material name="pla_cam" rgba="0.55 0.85 0.55 1" specular="0.2" shininess="0.2"/>
    <material name="pla_plate" rgba="0.85 0.55 0.75 1" specular="0.2" shininess="0.2"/>
    <material name="shell_first_link" rgba="0.40 0.75 0.85 1" specular="0.2" shininess="0.2"/>
    <material name="shell_second_link" rgba="0.93 0.45 0.30 1" specular="0.2" shininess="0.2"/>
    <material name="steel" rgba="0.72 0.73 0.76 1" specular="0.8" shininess="0.8"/>
    <material name="motor" rgba="0.12 0.12 0.13 1" specular="0.5" shininess="0.4"/>
    <material name="servo" rgba="0.75 0.12 0.12 1" specular="0.3" shininess="0.3"/>
    <mesh name="01_housing_cable_strain_relief_rubber" file="01_housing_cable_strain_relief_rubber.stl"/>
    <mesh name="01_housing_center_housing_red" file="01_housing_center_housing_red.stl"/>
    <mesh name="01_housing_lower_cover_black_polymer" file="01_housing_lower_cover_black_polymer.stl"/>
    <mesh name="01_housing_upper_gearbox_and_mounting_tabs_black" file="01_housing_upper_gearbox_and_mounting_tabs_black.stl"/>
    <mesh name="02_output_shaft_and_horn_output_shaft_brass_spline_envelope" file="02_output_shaft_and_horn_output_shaft_brass_spline_envelope.stl"/>
    <mesh name="02_output_shaft_and_horn_retaining_screw_black_steel" file="02_output_shaft_and_horn_retaining_screw_black_steel.stl"/>
    <mesh name="02_output_shaft_and_horn_single_arm_horn_aluminum" file="02_output_shaft_and_horn_single_arm_horn_aluminum.stl"/>
    <mesh name="17hs4023_stepper_42x23_connector" file="17hs4023_stepper_42x23_connector.stl"/>
    <mesh name="17hs4023_stepper_42x23_front_end_cap" file="17hs4023_stepper_42x23_front_end_cap.stl"/>
    <mesh name="17hs4023_stepper_42x23_rear_end_cap" file="17hs4023_stepper_42x23_rear_end_cap.stl"/>
    <mesh name="17hs4023_stepper_42x23_shaft" file="17hs4023_stepper_42x23_shaft.stl"/>
    <mesh name="17hs4023_stepper_42x23_stator" file="17hs4023_stepper_42x23_stator.stl"/>
    <mesh name="1stsegment_body1" file="1stsegment_body1.stl"/>
    <mesh name="1stsegment_body2" file="1stsegment_body2.stl"/>
    <mesh name="2nd_segments_body10" file="2nd_segments_body10.stl"/>
    <mesh name="2nd_segments_body4" file="2nd_segments_body4.stl"/>
    <mesh name="2nd_segments_body8" file="2nd_segments_body8.stl"/>
    <mesh name="2nd_segments_body9" file="2nd_segments_body9.stl"/>
    <mesh name="base_base_plate_underside_motor_bracket" file="base_base_plate_underside_motor_bracket.stl"/>
    <mesh name="base_drive_20t_pinion_20t_pinion_with_d_shaft_hub" file="base_drive_20t_pinion_20t_pinion_with_d_shaft_hub.stl"/>
    <mesh name="bearing_1_body1" file="bearing_1_body1.stl"/>
    <mesh name="bearing_body1" file="bearing_body1.stl"/>
    <mesh name="cam_a_b_body1" file="cam_a_b_body1.stl"/>
    <mesh name="cam_a_b_body1_2" file="cam_a_b_body1_2.stl"/>
    <mesh name="cam_a_b_mirror_body1" file="cam_a_b_mirror_body1.stl"/>
    <mesh name="cam_a_c_body1" file="cam_a_c_body1.stl"/>
    <mesh name="cam_a_c_body1_2" file="cam_a_c_body1_2.stl"/>
    <mesh name="cam_a_c_mirror_body1" file="cam_a_c_mirror_body1.stl"/>
    <mesh name="cam_bearing_body1" file="cam_bearing_body1.stl"/>
    <mesh name="cam_bearing_body1_2" file="cam_bearing_body1_2.stl"/>
    <mesh name="cam_bearing_mirror_body1" file="cam_bearing_mirror_body1.stl"/>
    <mesh name="enclosurebottom_body1" file="enclosurebottom_body1.stl"/>
    <mesh name="enclosuretop_body1" file="enclosuretop_body1.stl"/>
    <mesh name="pin_body1" file="pin_body1.stl"/>
    <mesh name="pin_mirror_body1" file="pin_mirror_body1.stl"/>
    <mesh name="ring_a_body1" file="ring_a_body1.stl"/>
    <mesh name="ring_a_body1_2" file="ring_a_body1_2.stl"/>
    <mesh name="ring_a_mirror_body1" file="ring_a_mirror_body1.stl"/>
    <mesh name="ring_b_body1" file="ring_b_body1.stl"/>
    <mesh name="ring_b_body1_2" file="ring_b_body1_2.stl"/>
    <mesh name="ring_b_mirror_body1" file="ring_b_mirror_body1.stl"/>
    <mesh name="ring_c_body1" file="ring_c_body1.stl"/>
    <mesh name="ring_c_body1_2" file="ring_c_body1_2.stl"/>
    <mesh name="ring_c_mirror_body1" file="ring_c_mirror_body1.stl"/>
    <mesh name="shelltop_body11" file="shelltop_body11.stl"/>
    <mesh name="shelltop_body9" file="shelltop_body9.stl"/>
    <mesh name="stepper_body1" file="stepper_body1.stl"/>
    <mesh name="stepper_body2" file="stepper_body2.stl"/>
    <mesh name="yaw_spindle_base_spindle_100t_drive_wheel" file="yaw_spindle_base_spindle_100t_drive_wheel.stl"/>
    <mesh name="yaw_spindle_base_spindle_100t_drive_wheel_1" file="yaw_spindle_base_spindle_100t_drive_wheel_1.stl"/>
    <mesh name="yaw_spindle_body205" file="yaw_spindle_body205.stl"/>
  </asset>
  <worldbody>
    <light pos="0.6 -0.6 1.4" dir="-0.4 0.4 -1" diffuse="0.8 0.8 0.8" castshadow="true"/>
    <light pos="-0.6 0.4 1.0" dir="0.4 -0.3 -1" diffuse="0.35 0.35 0.35" castshadow="false"/>
    <geom name="table" type="plane" size="1 1 0.02" material="floor" solref="0.004 1" solimp="0.95 0.99 0.001"/>
    <camera name="overview" pos="0.75 -0.75 0.55" xyaxes="0.707 0.707 0 -0.25 0.25 0.935"/>
    <body name="base" pos="0 0 0.0490" quat="0 0 -0.7071068 0.7071068">
      <geom class="solid" mesh="base_base_plate_underside_motor_bracket" pos="0 0 0" quat="1 0 0 0" material="pla_base" density="682.0"/>
      <geom class="visual" mesh="bearing_body1" pos="0 0.041 0" quat="0.7071068 -0.7071068 0 0" material="steel" density="7850"/>
      <geom class="visual" mesh="bearing_body1" pos="0 0.071 0" quat="0.7071068 -0.7071068 0 0" material="steel" density="7850"/>
      <geom class="solid" mesh="stepper_body1" pos="-0.075 0.078 0" quat="0.7071068 0.7071068 0 0" material="motor" mass="0.032321"/>
      <geom class="solid" mesh="stepper_body2" pos="-0.075 0.078 0" quat="0.7071068 0.7071068 0 0" material="motor" mass="0.247679"/>
      <body name="base_pinion" pos="-0.075 0 0">
        <joint name="base_motor_shaft" type="hinge" axis="0 -1 0"/>
        <geom class="visual" mesh="base_drive_20t_pinion_20t_pinion_with_d_shaft_hub" pos="0 0.06 0" quat="0.7071068 -0.7071068 0 0" material="pla_base_pinion" density="682.0"/>
      </body>
      <body name="yaw_spindle" pos="0 0 0">
        <joint name="yaw" type="hinge" axis="0 -1 0" armature="0.000135" damping="0.06366"/>
        <geom class="solid" mesh="yaw_spindle_base_spindle_100t_drive_wheel" pos="0 0 0" quat="1 0 0 0" material="pla_yaw_spindle" density="682.0"/>
        <geom class="solid" mesh="yaw_spindle_base_spindle_100t_drive_wheel_1" pos="0 0 0" quat="1 0 0 0" material="pla_yaw_spindle" density="682.0"/>
        <geom class="visual" mesh="yaw_spindle_body205" pos="0 0 0" quat="1 0 0 0" material="pla_yaw_spindle" density="682.0"/>
        <geom class="visual" mesh="pin_body1" pos="0 0 0" quat="0.9785591 0 0 0.2059662" material="steel" density="7850"/>
        <geom class="visual" mesh="pin_body1" pos="0 0 0" quat="0.9999384 0 0 0.0111012" material="steel" density="7850"/>
        <geom class="visual" mesh="pin_body1" pos="0 0 0" quat="0.5647663 0 0 -0.8252509" material="steel" density="7850"/>
        <geom class="visual" mesh="pin_body1" pos="0 0 0" quat="0.5463057 0 0 0.8375859" material="steel" density="7850"/>
        <geom class="visual" mesh="pin_body1" pos="0 0 0" quat="0.8375859 0 0 -0.5463057" material="steel" density="7850"/>
        <geom class="visual" mesh="pin_body1" pos="0 0 0" quat="0.9828906 0 0 -0.1841904" material="steel" density="7850"/>
        <geom class="visual" mesh="pin_body1" pos="0 0 0" quat="0.9195744 0 0 0.392916" material="steel" density="7850"/>
        <geom class="visual" mesh="pin_body1" pos="0 0 0" quat="-0.0111012 0 0 0.9999384" material="steel" density="7850"/>
        <geom class="visual" mesh="pin_body1" pos="0 0 0" quat="-0.392916 0 0 0.9195744" material="steel" density="7850"/>
        <geom class="visual" mesh="pin_body1" pos="0 0 0" quat="0.6992135 0 0 0.7149129" material="steel" density="7850"/>
        <geom class="visual" mesh="pin_body1" pos="0 0 0" quat="0.8252509 0 0 0.5647663" material="steel" density="7850"/>
        <geom class="visual" mesh="pin_body1" pos="0 0 0" quat="0.9280708 0 0 -0.3724037" material="steel" density="7850"/>
        <geom class="visual" mesh="pin_body1" pos="0 0 0" quat="0.3724037 0 0 0.9280708" material="steel" density="7850"/>
        <geom class="visual" mesh="pin_body1" pos="0 0 0" quat="0.1841904 0 0 0.9828906" material="steel" density="7850"/>
        <geom class="visual" mesh="pin_body1" pos="0 0 0" quat="-0.2059662 0 0 0.9785591" material="steel" density="7850"/>
        <geom class="visual" mesh="pin_body1" pos="0 0 0" quat="0.7149129 0 0 -0.6992135" material="steel" density="7850"/>
        <body name="first_link" pos="0 0 0">
          <joint name="shoulder" type="hinge" axis="0 0 -1" armature="0.001382" damping="0.6519"/>
          <geom class="shell" mesh="enclosuretop_body1" pos="0 0 0" quat="1 0 0 0" material="shell_first_link" density="682.0"/>
          <geom class="shell" mesh="enclosurebottom_body1" pos="0 0 0" quat="1 0 0 0" material="shell_first_link" density="682.0"/>
          <geom class="solid" mesh="stepper_body1" pos="0 -0.0705 0.015" quat="0 0 1 0" material="motor" mass="0.032321"/>
          <geom class="solid" mesh="stepper_body2" pos="0 -0.0705 0.015" quat="0 0 1 0" material="motor" mass="0.247679"/>
          <geom class="solid" mesh="stepper_body1" pos="0 -0.1145 0.015" quat="0 0 1 0" material="motor" mass="0.032321"/>
          <geom class="solid" mesh="stepper_body2" pos="0 -0.1145 0.015" quat="0 0 1 0" material="motor" mass="0.247679"/>
          <geom class="visual" mesh="bearing_body1" pos="0 0 -0.016" quat="1 0 0 0" material="steel" density="7850"/>
          <geom class="visual" mesh="bearing_body1" pos="0 0 0.011" quat="1 0 0 0" material="steel" density="7850"/>
          <geom class="visual" mesh="bearing_body1" pos="0 -0.185 -0.016" quat="1 0 0 0" material="steel" density="7850"/>
          <geom class="visual" mesh="bearing_body1" pos="0 -0.185 0.011" quat="1 0 0 0" material="steel" density="7850"/>
          <body name="shoulder_cam" pos="0 -0.0705 0">
            <joint name="shoulder_motor_shaft" type="hinge" axis="0 0 1"/>
            <geom class="visual" mesh="cam_a_b_body1" pos="0.024521 0.066098 0" quat="0.8209204 0 0 0.5710427" material="pla_cam" density="682.0"/>
            <geom class="visual" mesh="cam_a_c_body1" pos="0.024521 0.066098 0" quat="0.8209204 0 0 0.5710427" material="pla_cam" density="682.0"/>
            <geom class="visual" mesh="cam_bearing_body1" pos="0.000789 0.071434 -0.0065" quat="0.7071068 0 0 0.7071068" material="steel" density="7850"/>
            <geom class="visual" mesh="cam_bearing_body1" pos="-0.000278 0.07055 0" quat="0.7071068 0 0 0.7071068" material="steel" density="7850"/>
            <geom class="visual" mesh="cam_bearing_body1" pos="-0.00051 0.071916 0.0065" quat="0 0.7071068 0.7071068 0" material="steel" density="7850"/>
            <body name="shoulder_plate_a" pos="-0.000278 -0.00075 0">
              <joint name="shoulder_plate_a" type="hinge" axis="0 0 1"/>
              <geom class="visual" mesh="ring_a_body1" pos="0 0.0713 0" quat="0.7071068 0 0 0.7071068" material="pla_plate" density="682.0"/>
            </body>
            <body name="shoulder_plate_b" pos="-0.00051 0.000616 0">
              <joint name="shoulder_plate_b" type="hinge" axis="0 0 1"/>
              <geom class="visual" mesh="ring_b_body1" pos="0.000693 0.0701 0" quat="0.7071068 0 0 0.7071068" material="pla_plate" density="682.0"/>
            </body>
            <body name="shoulder_plate_c" pos="0.000789 0.000134 0">
              <joint name="shoulder_plate_c" type="hinge" axis="0 0 1"/>
              <geom class="visual" mesh="ring_c_body1" pos="-0.000693 0.0701 0" quat="0.7071068 0 0 0.7071068" material="pla_plate" density="682.0"/>
            </body>
          </body>
          <body name="elbow_cam" pos="0 -0.1145 0">
            <joint name="elbow_motor_shaft" type="hinge" axis="0 0 1"/>
            <geom class="visual" mesh="cam_a_b_mirror_body1" pos="0.024521 -0.066098 0" quat="0 0.8209204 -0.5710427 0" material="pla_cam" density="682.0"/>
            <geom class="visual" mesh="cam_a_c_mirror_body1" pos="0.024521 -0.066098 0" quat="0 0.8209204 -0.5710427 0" material="pla_cam" density="682.0"/>
            <geom class="visual" mesh="cam_bearing_mirror_body1" pos="0.000789 -0.071434 -0.0065" quat="0 -0.7071068 0.7071068 0" material="steel" density="7850"/>
            <geom class="visual" mesh="cam_bearing_mirror_body1" pos="-0.000278 -0.07055 0" quat="0 -0.7071068 0.7071068 0" material="steel" density="7850"/>
            <geom class="visual" mesh="cam_bearing_mirror_body1" pos="-0.00051 -0.071916 0.0065" quat="0.7071068 0 0 -0.7071068" material="steel" density="7850"/>
            <body name="elbow_plate_a" pos="-0.000278 0.00075 0">
              <joint name="elbow_plate_a" type="hinge" axis="0 0 1"/>
              <geom class="visual" mesh="ring_a_mirror_body1" pos="0 -0.0713 0" quat="0 -0.7071068 0.7071068 0" material="pla_plate" density="682.0"/>
            </body>
            <body name="elbow_plate_b" pos="-0.00051 -0.000616 0">
              <joint name="elbow_plate_b" type="hinge" axis="0 0 1"/>
              <geom class="visual" mesh="ring_b_mirror_body1" pos="0.000693 -0.0701 0" quat="0 -0.7071068 0.7071068 0" material="pla_plate" density="682.0"/>
            </body>
            <body name="elbow_plate_c" pos="0.000789 -0.000134 0">
              <joint name="elbow_plate_c" type="hinge" axis="0 0 1"/>
              <geom class="visual" mesh="ring_c_mirror_body1" pos="-0.000693 -0.0701 0" quat="0 -0.7071068 0.7071068 0" material="pla_plate" density="682.0"/>
            </body>
          </body>
          <body name="second_link" pos="0 -0.185 0">
            <joint name="elbow" type="hinge" axis="0 0 -1" armature="0.001382" damping="0.6519"/>
            <geom class="shell" mesh="shelltop_body9" pos="0 -0.185 -0.0075" quat="0 0 0 1" material="shell_second_link" density="682.0"/>
            <geom class="shell" mesh="shelltop_body11" pos="0 -0.185 -0.0075" quat="0 0 0 1" material="shell_second_link" density="682.0"/>
            <geom class="solid" mesh="17hs4023_stepper_42x23_front_end_cap" pos="0 -0.0525 0.0075" quat="0 0 0 1" material="motor" mass="0.030710"/>
            <geom class="solid" mesh="17hs4023_stepper_42x23_stator" pos="0 -0.0525 0.0075" quat="0 0 0 1" material="motor" mass="0.077320"/>
            <geom class="solid" mesh="17hs4023_stepper_42x23_rear_end_cap" pos="0 -0.0525 0.0075" quat="0 0 0 1" material="motor" mass="0.028637"/>
            <geom class="solid" mesh="17hs4023_stepper_42x23_shaft" pos="0 -0.0525 0.0075" quat="0 0 0 1" material="motor" mass="0.001172"/>
            <geom class="solid" mesh="17hs4023_stepper_42x23_connector" pos="0 -0.0525 0.0075" quat="0 0 0 1" material="motor" mass="0.002162"/>
            <geom class="visual" mesh="pin_mirror_body1" pos="0 0 0" quat="0 0.9785591 -0.2059662 0" material="steel" density="7850"/>
            <geom class="visual" mesh="pin_mirror_body1" pos="0 0 0" quat="0 0.9999384 -0.0111012 0" material="steel" density="7850"/>
            <geom class="visual" mesh="pin_mirror_body1" pos="0 0 0" quat="0 0.5647663 0.8252509 0" material="steel" density="7850"/>
            <geom class="visual" mesh="pin_mirror_body1" pos="0 0 0" quat="0 -0.5463057 0.8375859 0" material="steel" density="7850"/>
            <geom class="visual" mesh="pin_mirror_body1" pos="0 0 0" quat="0 0.8375859 0.5463057 0" material="steel" density="7850"/>
            <geom class="visual" mesh="pin_mirror_body1" pos="0 0 0" quat="0 0.9828906 0.1841904 0" material="steel" density="7850"/>
            <geom class="visual" mesh="pin_mirror_body1" pos="0 0 0" quat="0 0.9195744 -0.392916 0" material="steel" density="7850"/>
            <geom class="visual" mesh="pin_mirror_body1" pos="0 0 0" quat="0 0.0111012 0.9999384 0" material="steel" density="7850"/>
            <geom class="visual" mesh="pin_mirror_body1" pos="0 0 0" quat="0 0.392916 0.9195744 0" material="steel" density="7850"/>
            <geom class="visual" mesh="pin_mirror_body1" pos="0 0 0" quat="0 -0.6992135 0.7149129 0" material="steel" density="7850"/>
            <geom class="visual" mesh="pin_mirror_body1" pos="0 0 0" quat="0 0.8252509 -0.5647663 0" material="steel" density="7850"/>
            <geom class="visual" mesh="pin_mirror_body1" pos="0 0 0" quat="0 0.9280708 0.3724037 0" material="steel" density="7850"/>
            <geom class="visual" mesh="pin_mirror_body1" pos="0 0 0" quat="0 -0.3724037 0.9280708 0" material="steel" density="7850"/>
            <geom class="visual" mesh="pin_mirror_body1" pos="0 0 0" quat="0 -0.1841904 0.9828906 0" material="steel" density="7850"/>
            <geom class="visual" mesh="pin_mirror_body1" pos="0 0 0" quat="0 0.2059662 0.9785591 0" material="steel" density="7850"/>
            <geom class="visual" mesh="pin_mirror_body1" pos="0 0 0" quat="0 0.7149129 0.6992135 0" material="steel" density="7850"/>
            <body name="wrist_cam" pos="0 -0.0525 0">
              <joint name="wrist_motor_shaft" type="hinge" axis="0 0 1"/>
              <geom class="visual" mesh="cam_a_b_body1_2" pos="-0.046086 -0.124227 -0.0075" quat="0.5710427 0 0 -0.8209204" material="pla_cam" density="682.0"/>
              <geom class="visual" mesh="cam_a_c_body1_2" pos="-0.046086 -0.124227 -0.0075" quat="0.5710427 0 0 -0.8209204" material="pla_cam" density="682.0"/>
              <geom class="visual" mesh="cam_bearing_body1_2" pos="-0.000789 -0.133434 -0.014" quat="0.7071068 0 0 -0.7071068" material="steel" density="7850"/>
              <geom class="visual" mesh="cam_bearing_body1_2" pos="0.000278 -0.13255 -0.0075" quat="0.7071068 0 0 -0.7071068" material="steel" density="7850"/>
              <geom class="visual" mesh="cam_bearing_body1_2" pos="0.00051 -0.133916 -0.001" quat="0 0.7071068 -0.7071068 0" material="steel" density="7850"/>
              <body name="wrist_plate_a" pos="0.000278 0.00075 0">
                <joint name="wrist_plate_a" type="hinge" axis="0 0 1"/>
                <geom class="visual" mesh="ring_a_body1_2" pos="0 -0.1333 -0.0075" quat="0.7071068 0 0 -0.7071068" material="pla_plate" density="682.0"/>
              </body>
              <body name="wrist_plate_b" pos="0.00051 -0.000616 0">
                <joint name="wrist_plate_b" type="hinge" axis="0 0 1"/>
                <geom class="visual" mesh="ring_b_body1_2" pos="-0.000693 -0.1321 -0.0075" quat="0.7071068 0 0 -0.7071068" material="pla_plate" density="682.0"/>
              </body>
              <body name="wrist_plate_c" pos="-0.000789 -0.000134 0">
                <joint name="wrist_plate_c" type="hinge" axis="0 0 1"/>
                <geom class="visual" mesh="ring_c_body1_2" pos="0.000693 -0.1321 -0.0075" quat="0.7071068 0 0 -0.7071068" material="pla_plate" density="682.0"/>
              </body>
            </body>
            <body name="head" pos="0 -0.185 0">
              <joint name="wrist" type="hinge" axis="0 0 -1" armature="0.000512" damping="0.2526"/>
              <geom class="solid" mesh="1stsegment_body1" pos="0 0 -0.0075" quat="0 0 0 1" material="pla_head" density="682.0"/>
              <geom class="solid" mesh="1stsegment_body2" pos="0 0 -0.0075" quat="0 0 0 1" material="pla_head" density="682.0"/>
              <geom class="visual" mesh="bearing_1_body1" pos="-0.0235 -0.045 0" quat="1 0 0 0" material="steel" density="7850"/>
              <geom class="solid" mesh="01_housing_lower_cover_black_polymer" pos="-0.017107 -0.045 -0.01" quat="0.5 0.5 0.5 0.5" material="servo" mass="0.016829"/>
              <geom class="solid" mesh="01_housing_center_housing_red" pos="-0.017107 -0.045 -0.01" quat="0.5 0.5 0.5 0.5" material="servo" mass="0.027728"/>
              <geom class="solid" mesh="01_housing_upper_gearbox_and_mounting_tabs_black" pos="-0.017107 -0.045 -0.01" quat="0.5 0.5 0.5 0.5" material="servo" mass="0.019530"/>
              <geom class="solid" mesh="01_housing_cable_strain_relief_rubber" pos="-0.017107 -0.045 -0.01" quat="0.5 0.5 0.5 0.5" material="servo" mass="0.000090"/>
              <geom class="visual" mesh="pin_body1" pos="0 0 -0.0075" quat="-0.2059662 0 0 0.9785591" material="steel" density="7850"/>
              <geom class="visual" mesh="pin_body1" pos="0 0 -0.0075" quat="-0.0111012 0 0 0.9999384" material="steel" density="7850"/>
              <geom class="visual" mesh="pin_body1" pos="0 0 -0.0075" quat="0.8252509 0 0 0.5647663" material="steel" density="7850"/>
              <geom class="visual" mesh="pin_body1" pos="0 0 -0.0075" quat="0.8375859 0 0 -0.5463057" material="steel" density="7850"/>
              <geom class="visual" mesh="pin_body1" pos="0 0 -0.0075" quat="0.5463057 0 0 0.8375859" material="steel" density="7850"/>
              <geom class="visual" mesh="pin_body1" pos="0 0 -0.0075" quat="0.1841904 0 0 0.9828906" material="steel" density="7850"/>
              <geom class="visual" mesh="pin_body1" pos="0 0 -0.0075" quat="-0.392916 0 0 0.9195744" material="steel" density="7850"/>
              <geom class="visual" mesh="pin_body1" pos="0 0 -0.0075" quat="0.9999384 0 0 0.0111012" material="steel" density="7850"/>
              <geom class="visual" mesh="pin_body1" pos="0 0 -0.0075" quat="0.9195744 0 0 0.392916" material="steel" density="7850"/>
              <geom class="visual" mesh="pin_body1" pos="0 0 -0.0075" quat="0.7149129 0 0 -0.6992135" material="steel" density="7850"/>
              <geom class="visual" mesh="pin_body1" pos="0 0 -0.0075" quat="0.5647663 0 0 -0.8252509" material="steel" density="7850"/>
              <geom class="visual" mesh="pin_body1" pos="0 0 -0.0075" quat="0.3724037 0 0 0.9280708" material="steel" density="7850"/>
              <geom class="visual" mesh="pin_body1" pos="0 0 -0.0075" quat="0.9280708 0 0 -0.3724037" material="steel" density="7850"/>
              <geom class="visual" mesh="pin_body1" pos="0 0 -0.0075" quat="0.9828906 0 0 -0.1841904" material="steel" density="7850"/>
              <geom class="visual" mesh="pin_body1" pos="0 0 -0.0075" quat="0.9785591 0 0 0.2059662" material="steel" density="7850"/>
              <geom class="visual" mesh="pin_body1" pos="0 0 -0.0075" quat="0.6992135 0 0 0.7149129" material="steel" density="7850"/>
              <body name="head_tilt" pos="0 -0.045 0">
                <joint name="head_tilt" type="hinge" axis="-1 0 0" range="-2.3562 2.3562"/>
                <geom class="solid" mesh="2nd_segments_body4" pos="-0.0005 0.045 -0.0075" quat="0 0 0 1" material="pla_head_tilt" density="682.0"/>
                <geom class="visual" mesh="2nd_segments_body8" pos="-0.0005 0.045 -0.0075" quat="0 0 0 1" material="pla_head_tilt" density="0"/>
                <geom class="visual" mesh="2nd_segments_body10" pos="-0.0005 0.045 -0.0075" quat="0 0 0 1" material="pla_head_tilt" density="0"/>
                <geom class="solid" mesh="2nd_segments_body9" pos="-0.0005 0.045 -0.0075" quat="0 0 0 1" material="pla_head_tilt" density="682.0"/>
                <geom class="visual" mesh="02_output_shaft_and_horn_output_shaft_brass_spline_envelope" pos="-0.017107 0 -0.01" quat="0.5 0.5 0.5 0.5" material="servo" mass="0.000187"/>
                <geom class="visual" mesh="02_output_shaft_and_horn_single_arm_horn_aluminum" pos="-0.017107 0 -0.01" quat="0.5 0.5 0.5 0.5" material="servo" mass="0.001585"/>
                <geom class="visual" mesh="02_output_shaft_and_horn_retaining_screw_black_steel" pos="-0.017107 0 -0.01" quat="0.5 0.5 0.5 0.5" material="servo" mass="0.000051"/>
              </body>
            </body>
          </body>
        </body>
      </body>
    </body>
  </worldbody>
  <contact>
    <exclude body1="world" body2="yaw_spindle"/>  <!-- spindle + 100T wheel sit below the base plate, through the table -->
    <exclude body1="base" body2="yaw_spindle"/>
    <exclude body1="yaw_spindle" body2="first_link"/>
  </contact>
  <equality>
    <joint class="gear" name="base_gear_20T_100T" joint1="base_motor_shaft" joint2="yaw" polycoef="0 -5 0 0 0"/>
    <joint class="gear" name="shoulder_cycloid_16to1" joint1="shoulder_motor_shaft" joint2="shoulder" polycoef="0 -16 0 0 0"/>
    <joint class="gear" name="elbow_cycloid_16to1" joint1="elbow_motor_shaft" joint2="elbow" polycoef="0 16 0 0 0"/>
    <joint class="gear" name="wrist_cycloid_16to1" joint1="wrist_motor_shaft" joint2="wrist" polycoef="0 16 0 0 0"/>
    <joint class="gear" name="shoulder_plate_a_no_spin" joint1="shoulder_plate_a" joint2="shoulder_motor_shaft" polycoef="0 -1 0 0 0"/>
    <joint class="gear" name="shoulder_plate_b_no_spin" joint1="shoulder_plate_b" joint2="shoulder_motor_shaft" polycoef="0 -1 0 0 0"/>
    <joint class="gear" name="shoulder_plate_c_no_spin" joint1="shoulder_plate_c" joint2="shoulder_motor_shaft" polycoef="0 -1 0 0 0"/>
    <joint class="gear" name="elbow_plate_a_no_spin" joint1="elbow_plate_a" joint2="elbow_motor_shaft" polycoef="0 -1 0 0 0"/>
    <joint class="gear" name="elbow_plate_b_no_spin" joint1="elbow_plate_b" joint2="elbow_motor_shaft" polycoef="0 -1 0 0 0"/>
    <joint class="gear" name="elbow_plate_c_no_spin" joint1="elbow_plate_c" joint2="elbow_motor_shaft" polycoef="0 -1 0 0 0"/>
    <joint class="gear" name="wrist_plate_a_no_spin" joint1="wrist_plate_a" joint2="wrist_motor_shaft" polycoef="0 -1 0 0 0"/>
    <joint class="gear" name="wrist_plate_b_no_spin" joint1="wrist_plate_b" joint2="wrist_motor_shaft" polycoef="0 -1 0 0 0"/>
    <joint class="gear" name="wrist_plate_c_no_spin" joint1="wrist_plate_c" joint2="wrist_motor_shaft" polycoef="0 -1 0 0 0"/>
  </equality>
  <actuator>
    <position name="base_motor" joint="yaw" kp="500" kv="15" timeconst="0.15" ctrlrange="-3.1416 3.1416" forcerange="-2 2"/>
    <position name="shoulder_motor" joint="shoulder" kp="5120" kv="153.6" timeconst="0.15" ctrlrange="-3.1416 3.1416" forcerange="-6.4 6.4"/>
    <position name="elbow_motor" joint="elbow" kp="5120" kv="153.6" timeconst="0.15" ctrlrange="-3.1416 3.1416" forcerange="-6.4 6.4"/>
    <position name="wrist_motor" joint="wrist" kp="1984" kv="59.52" timeconst="0.15" ctrlrange="-3.1416 3.1416" forcerange="-2.48 2.48"/>
    <position name="head_servo" joint="head_tilt" kp="20" dampratio="1" ctrlrange="-2.3562 2.3562" forcerange="-1.96 1.96"/>
  </actuator>
  <sensor>
    <jointpos name="yaw_pos" joint="yaw"/>
    <jointpos name="shoulder_pos" joint="shoulder"/>
    <jointpos name="elbow_pos" joint="elbow"/>
    <jointpos name="wrist_pos" joint="wrist"/>
    <jointpos name="head_tilt_pos" joint="head_tilt"/>
    <actuatorfrc name="base_motor_force" actuator="base_motor"/>
    <actuatorfrc name="shoulder_motor_force" actuator="shoulder_motor"/>
    <actuatorfrc name="elbow_motor_force" actuator="elbow_motor"/>
    <actuatorfrc name="wrist_motor_force" actuator="wrist_motor"/>
    <actuatorfrc name="head_servo_force" actuator="head_servo"/>
  </sensor>
  <keyframe>
    <key name="home" qpos="-0 0 0 -0 0 0 0 0 -0 -0 -0 0 0 -0 -0 -0 0 0" ctrl="0 0 0 0 0" act="0 0 0 0"/>
    <key name="reach" qpos="-3 0.6 -0.5 8 -8 -8 -8 17.6 -17.6 -17.6 -17.6 1.1 9.6 -9.6 -9.6 -9.6 0.6 -0.4" ctrl="0.6 -0.5 1.1 0.6 -0.4" act="0.6 -0.5 1.1 0.6"/>
  </keyframe>
</mujoco>
