Victor-JB/IEEE-Minimalist-AI-Challenge-2026/apps/lumen/lumen/app.py

"""Main loop: camera -> perception -> events -> state machine -> director -> arm + light.

    camera frame ─► Perception.step(rates of the current state) ─► events
                                                                    │
    MotionWorker (thread, 25 Hz) ◄─ Director ◄─ Machine.handle(event) ◄┘
"""
import socket
import time

from .light import config as light_cfg
from .state.director import Director
from .movement.expressive import Expressive
from .light.light import Light, make_backend
from .io.power import Power
from .movement.worker import MotionWorker
from .state.machine import Machine
from .ai import Perception
from .ai.book.detector import BookDetector
from .ai.hands.landmarker import HandLandmarker
from .ai.motion_gate.gate import MotionGate
from .translog import TransitionLog


def run(args):
    from .ui import hud
    from .io.camera import Camera, FpsCounter
    from .perfstats import count, timed  # no-op unless PERF=1

    expressive = Expressive()
    worker = MotionWorker(expressive, fake=args.fake_arm)
    light = Light(make_backend(light_cfg.LIGHT_BACKEND, worker))   # env LUMEN_LIGHT; sim by default
    power = Power()
    director = Director(worker, light, expressive, power=power)
    face = None
    if not args.no_face:
        from .ai.face.tracker import FaceTracker
        face = FaceTracker()
    perception = Perception(face=face, hands=HandLandmarker(), book=BookDetector(),
                            gate=MotionGate())
    log = TransitionLog()
    web = None
    if args.stream:                                   # the one web page: HUD + desk + Auto/Manual
        from .ui.web import WebPage
        web = WebPage(args.stream, fake_arm=args.fake_arm)
        print(f"Web page at http://{socket.gethostname()}:{args.stream}/ (starts in {web.requested})")

    def entered(state, m):
        director.on_enter(state, m)
        perception.on_state_change(m.ctx)

    worker.start()
    machine = Machine(on_enter=entered, on_exit=director.on_exit, now=time.monotonic())
    print(f"Lumen running: state {machine.path}" + (" (fake arm)" if args.fake_arm else ""))

    with Camera(args.camera) as cam:
        power.attach(cam)
        fps = FpsCounter()
        last_print = 0.0
        while True:
            with timed("camera.read"):
                frame = cam.read()                   # paced in SLEEP (io/power.py)
            now = time.monotonic()                   # after the read: the frame's own time
            if frame is None:
                print("Camera frame grab failed")
                break
            count("frames")

            with timed("perception"):
                events = perception.step(frame, now, machine.models, machine.ctx)
            machine.ctx["at_pause_pose"] = False
            events += director.poll_events(now, machine, perception)
            if web:
                events += web.events(machine, worker)
            director.note_events(events, now)

            for tr in [machine.handle(ev, now) for ev in events] + [machine.tick(now)]:
                if tr:
                    why = None
                    if tr.dst == "FAULT":               # reason: 'CODE: detail' (movement/worker.py)
                        why = director.fault_reason if tr.event == "FAULT" else f"{tr.src} {tr.event}"
                        director.fault_reason = why    # the HUD shows it while in FAULT
                    log.write(tr, machine.models, expressive.energy, perception.sched.counts, why)
                    print(f"{tr.src:>10} --{tr.event}--> {machine.path}")
                    if why:
                        latched = "" if director.faults <= 1 else " (latched: hold an open palm 3 s, or restart Lumen)"
                        print(f"FAULT #{director.faults}: {why}{latched}")

            director.tick(now, machine, perception, frame.shape)
            light.update(now)                                # advance the light's ramp, write the LED
            fps.tick()

            if web:
                web.update(machine, now, worker.doing)
                if web.feed.watched:
                    hud.draw(frame, machine, perception, light, expressive.energy, fps.fps,
                             fault=director.fault_reason if machine.state == "FAULT" else None,
                             now=now, doing=worker.doing)
                    web.feed.publish(frame)
            if args.headless and now - last_print > 5:
                last_print = now
                print(f"[{machine.path}] {fps.fps:.1f} fps, inferences {perception.sched.counts}")
