Victor-JB/IEEE-Minimalist-AI-Challenge-2026/apps/lumen/tests/test_worker.py

"""Motion worker fault handling with a fake arm: stalls are acknowledged and survived, repeated
stalls become a FAULT, and a faulted worker reconnects when BOOT asks. No board needed."""
import random
import sys
import time
import unittest
from pathlib import Path

sys.path.insert(0, str(Path(__file__).resolve().parents[1]))
from lumen import events as E  # noqa: E402
from lumen.movement.expressive import Expressive  # noqa: E402
from lumen.movement import worker as W  # noqa: E402


class FakeArm:
    """Stands in for ArmMotion: streams fine except on the points listed in stall_at."""
    def __init__(self, stall_at=()):
        self.stall_at, self.points, self.halts, self.closed = set(stall_at), 0, 0, False

    def stream_point(self, pose, vel=None, horizon=0.1):
        self.points += 1
        return {"state": "stalled" if self.points in self.stall_at else "streaming", "angles": pose}

    def halt(self):
        self.halts += 1

    def roll(self, angle, speed=None):
        pass

    def angles(self):
        return [0.0, 60.0, 5.0]

    def servo_status(self):
        return {"stalled_joint": "head", "stall_angle": 5.1}

    def relax(self):
        pass

    def close(self):
        self.closed = True


class WorkerFaults(unittest.TestCase):
    def setUp(self):
        self.w = W.MotionWorker(Expressive(random.Random(1)), fake=True)
        self.w.arm = FakeArm(stall_at={3})
        self.w.current = [0.0, 60.0, 5.0]

    def test_stall_is_pushed_through_without_ending_the_move(self):
        W.STALL_PAUSE_S = 0
        self.assertTrue(self.w._guard(self.w._goto, [1.0, 61.0, 6.0], 0.2))
        self.assertEqual(self.w.arm.halts, 1)
        self.assertEqual(self.w.stall_count, 1)
        self.assertEqual(self.w.current, [1.0, 61.0, 6.0])      # got there after the retry

    def test_clip_survives_a_stall(self):
        W.STALL_PAUSE_S = 0
        self.w.arm = FakeArm(stall_at={10})
        self.assertTrue(self.w._guard(self.w._play, "nod_yes/small_calm", 1.0, 1.0))
        self.assertEqual(self.w.stall_count, 1)

    def test_unpushable_stall_abandons_then_faults_when_jammed(self):
        W.STALL_PAUSE_S = 0
        self.w.arm = FakeArm(stall_at=range(1, 10**6))
        for _ in range(W.GIVE_UP_LIMIT - 1):
            self.assertIsNone(self.w._guard(self.w._goto, [1.0, 61.0, 6.0], 0.1))
        self.assertEqual(self.w.arm.halts, (W.GIVE_UP_LIMIT - 1) * (W.STALL_RETRIES + 1))
        with self.assertRaises(RuntimeError):
            self.w._guard(self.w._goto, [1.0, 61.0, 6.0], 0.1)

    def test_goto_reports_done(self):
        self.w.cmds.put(("goto", [1.0, 61.0, 6.0], 0.2, 7, E.MOVE_DONE))
        self._run_loop_briefly()
        self.assertIn((E.MOVE_DONE, 7, None), self.w.poll_events())
        self.assertEqual(self.w.base, [1.0, 61.0, 6.0])

    def test_fault_then_reconnect_on_boot(self):
        connects = []
        w = self.w
        w.fake = False

        def connect():
            connects.append(1)
            w.arm = FakeArm()
            return True
        w._connect = connect

        def boom():
            raise RuntimeError("link lost")
        w._hold_tick = boom
        w.start()
        deadline = time.monotonic() + 2
        events = []
        while time.monotonic() < deadline and not any(e[0] == E.FAULT for e in events):
            events += w.poll_events()
            time.sleep(0.01)
        self.assertTrue(any(e[0] == E.FAULT for e in events))
        self.assertIsNone(w.arm)                     # session closed after the fault
        self.assertTrue(w.is_alive())                # but the thread is still there
        del w._hold_tick
        w.connect()
        deadline = time.monotonic() + 2
        while time.monotonic() < deadline and len(connects) < 2:
            time.sleep(0.01)
        w.stop()
        self.assertEqual(len(connects), 2)

    def test_seq_runs_steps_marks_and_reports_once(self):
        w = self.w
        w.arm = FakeArm()
        w.offset = w._off = [0.0, 0.0, 3.0]
        w.cmds.put(("seq", [("goto", [1.0, 61.0, 6.0], 0.1), ("mark", 0),
                            ("goto", [2.0, 62.0, 7.0], 0.1, True), ("rebase",)], 9, E.CLIP_DONE))
        self._run_loop_briefly()                              # (its hold tick stops the loop: no waits here)
        events = w.poll_events()
        self.assertEqual(events, [(E.STEP, 9, 0), (E.CLIP_DONE, 9, None)])
        self.assertEqual(w._off, [0.0, 0.0, 0.0])           # cleared by the return goto
        self.assertEqual(w.base, [2.0, 62.0, 7.0])

    def test_seq_wait_holds_at_the_last_goto(self):
        w = self.w
        w.arm = FakeArm()
        self.assertTrue(w._seq([("goto", [1.0, 61.0, 6.0], 0.1), ("wait", 0.1)], 1))
        self.assertEqual(w.current, [1.0, 61.0, 6.0])

    def test_rebase_keeps_the_pose_a_clip_ended_at(self):
        w = self.w
        w.current, w._off = [-20.0, 80.0, 30.0], [0.0, 0.0, 2.0]
        self.assertTrue(w._seq([("rebase",)], 1))
        self.assertEqual(w.base, [-20.0, 80.0, 28.0])

    def _run_loop_briefly(self):
        """Run _loop until the command queue is empty and one hold tick passed."""
        w = self.w
        orig = w._hold_tick

        def tick():
            w._stop.set()
            orig()
        w._hold_tick = tick
        w._loop()


# These tests exercise the general machinery with a driven shoulder (arm_config.SHOULDER_LOCK is
# set on the real arm while its motor is out); the locked behavior has its own tests.
_lock = None


def setUpModule():
    global _lock
    import arm_config
    _lock = arm_config.SHOULDER_LOCK
    arm_config.unlock_shoulder()


def tearDownModule():
    import arm_config
    if _lock is not None:
        arm_config.lock_shoulder(_lock)


if __name__ == "__main__":
    unittest.main()
