Victor-JB/IEEE-Minimalist-AI-Challenge-2026/(commit log)

2026-10-04 arduino app packaging ai + robot dynamics
2026-10-04 CAD-exact MuJoCo model of ARM v29 with stepper drive simulation
    Adds arm_mujoco/: a MuJoCo model generated from the Fusion 360 design
    (meshes, PLA/steel/datasheet masses, exact 16:1 cycloidal and 5:1 gear
    couplings, wobbling cam plates, stepper and servo actuators), plus:
    - build_mjcf.py: regenerates the model from the Fusion export
    - lamp_demo.py: expressive-lamp show with speed/accel-limited trajectories
    - elegnt_demo.py: the ELEGNT paper's six study scenarios at gamma 0 vs 1,
    plus a gallery of the remaining gestures
    - stepper_pid_sim.py: stepper drivers, AS5600 sensors and the STM32 control
    loop simulated on the arm (lost steps, gearbox backlash and flex), comparing
    a plain PID, a t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
    [01_housing_cable_strain_relief_rubber.stl, 01_housing_center_housing_red.stl, 01_housing_lower_cover_black_polymer.stl, 01_housing_upper_gearbox_and_mounting_tabs_black.stl, 02_output_shaft_and_horn_output_shaft_brass_spline_envelope.stl, 02_output_shaft_and_horn_retaining_screw_black_steel.stl, 02_output_shaft_and_horn_single_arm_horn_aluminum.stl, 17hs4023_stepper_42x23_connector.stl]
2026-10-05 Run the lamp and ELEGNT animations through the simulated stepper drives
    lamp_demo.py and elegnt_demo.py take --drive pid | pid_tuned | smooth (plus
    --sensor, --current, --vbus): the animation is streamed at 20 Hz to the
    simulated STM32 loop, drivers and steppers from stepper_pid_sim.py instead of
    ideal motors, with lost steps shown in the viewer and the report.
    - stepper_pid_sim.py: drive() helper to attach the drives to any scene; the
    stream follower slows all joints together when one hits its limit
    - elegnt_demo.py: social scenario points at the plant from 2 cm higher and
    closer (the old pose passed within 0.1 mm of the plant)
    - README: commands and results for the animations through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
    [lamp_demo.py, stepper_pid_sim.py]
2026-10-06 Face the base plate's long side, add labelled parts pictures
    - build_mjcf.py: FRONT_IS_LONG_SIDE - the arm bends toward the base plate's
    long side (the yaw-motor end), the other way round its output axles, with
    the parts exactly as in Fusion. Shoulder/elbow/wrist/head-tilt directions
    and the gear signs flip (shoulder -16, elbow +16, wrist +16)
    - scripts read the gear couplings from the model (lamp_demo.couplings /
    set_arm_pose) instead of hard-coding them
    - elegnt_demo.py: the look-at solver keeps the wrist within -125..+95 deg
    (the shade now meets the Second Link past +100 deg) by bending the arm
    more; project lean-in stops 2 cm shorter to clear the plant
    - stepper_pid_sim.py: t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
    [robot_arm.xml, robot_arm_xray.xml]
2026-10-10 Auto-detect USB camera by default
    On the UNO Q, /dev/video0-1 are the SoC video codec, so index 0 fails.
    Default --camera to 'auto', which picks the first /dev/v4l/by-id USB
    capture node and falls back to index 0.
    [camera.py]
2026-10-10 Add --stream: MJPEG feed of annotated frames over HTTP
    Viewing over ssh -X ships raw pixels and crawls; this serves JPEGs to a
    browser instead. Encoding is skipped while no client is connected.
2026-10-11 Add Arduino Q arm controller with live CAD view and joint limits
    Add STM32 firmware and a Linux Bridge gateway for three DRV8825 motors
    and AS5600 sensors through a PCA9548A. Provide a native Mac app with
    hold-to-run controls, independent ramps, calibrated CAD visualization,
    and the confirmed swapped motor mapping and microstep settings.
    Enforce calibrated shoulder, elbow, and head limits on the MCU, stop on
    invalid or stale sensor feedback, and allow inward recovery at limits.
    Save calibration, limits, CAD provenance, build/deploy scripts, diagnostics,
    and regression tests. Exclude generated application bundles and builds.
    Validation: motion, sensor, gateway, native control, CAD, and join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
2026-10-11 Closed-loop arm control, emote streaming and Tailscale link for stepper_desk
    Firmware: closed-loop position control on the AS5600 angles (servo.hpp),
    counted jogs, powered settling and D8 power management. The closed-loop
    STEP cap is 12,000 pulses/s (other paths keep 2,400). The shoulder minimum
    is now -34 deg, because the arm could not lift back from below about -36.
    Optional head gear-slack compensation is included but off by default.
    Python: arm_client/arm_motion/script_gateway, armctl, calibration and
    analysis tools, and scripts/emote.py, which streams motion_lib clips with
    per-joint speed caps and returns home after a stall.
    Link: USB via ADB when plugged in, otherwise Tailscale to da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
2026-10-11 Real stepper-arm sim model and real-vs-sim comparison
    sim/stepper_desk.toml describes the 3-joint arm with the app's ARM v29
    CAD parts and the CAD branch's masses. It sets the firmware limits and
    holding torques fitted to the measured stalls; behaviour the kinematic
    sim does not model yet is recorded under [measured]. configurator.py and
    view.py take any config, and only robot.toml regenerates the
    expressive_robot constants. motion_lib selects a robot with ROBOT_CONFIG
    and drops clip joints the robot lacks. sim/compare_real.py replays
    emote.py traces in the sim and plots tracking error against the real arm.
2026-10-12 Port the lamp show to arm clips; per-joint emote gains and elbow lift cap
    scripts/make-lamp-clips.py turns arm_mujoco/lamp_demo.py's poses (from
    full-model-animations) into additive clips in clips/lamp_*__arm.json, and
    emote.py plays them by name. emote.py gains --gains to exaggerate single
    joints, an automatic 0.3 s streaming horizon over Tailscale, a retry when
    a network gap lapses the lease on the move home, and --elbow-lift (14 deg/s)
    because straightening the elbow stalls far sooner than folding it. The
    default speed caps are now 30/25/22 deg/s. CLOSED_LOOP.md records the
    results and the elbow and head weakening late in the session.
2026-10-12 Run emotes on the Arduino Q itself through a local gateway link
    On the board, arm_client sees the router socket and starts script_gateway
    as a local process instead of SSH. STEPPER_LINK=local forces this. STATUS
    round trips are 16 ms median and 33 ms worst there, against Tailscale's
    spikes of up to 250 ms. deploy.sh now also installs emote.py, armctl.py,
    the calibration, the arm clips, and motion_lib's player and clips, and
    python/requirements.txt adds numpy for the board venv.
2026-10-12 Add inverse-kinematics straight-line demo for the head pivot
    scripts/ik_line.py solves the planar two-link IK (18.5 cm links) for a
    horizontal line, a vertical line and a square around home. It streams the
    result through the closed loop, then reports the measured path error via
    forward kinematics. --no-level holds the head joint still instead of
    keeping the head level. Shapes are checked against the shoulder's -30..+10
    emote range and the head's slow zone before anything moves.
2026-10-12 ik_line: run any segment back and forth with a joint-speed cap
    --line X0 Z0 X1 Z1 (cm from the shoulder pivot) with --repeat runs one
    segment back and forth. --joint-speed slows the tool until no joint
    exceeds the cap; 8.5 deg/s is about 25 motor RPM. The longest
    torque-safe line behind upright is 17.3 23.9 -6.6 35.4 (26.8 cm).
2026-10-12 Add longest straight-line search for the head pivot
    sim/longest_line.py searches the reachable workspace for the longest
    straight segment the head pivot can travel on one elbow branch within
    the joint limits. It can also cap shoulder gravity torque using the CAD
    masses in stepper_desk.toml, and prints an ik_line.py --line command for
    the result. Results: 41.9 cm within the hard limits, 32.8 cm in the safe
    demo range, 28.1 cm torque-safe, and 26.8 cm with the shoulder kept
    behind upright.
2026-10-12 Local link: run the gateway with a Python that has the router bridge
    On the Arduino Q, scripts started from a repo clone with the system
    Python spawned script_gateway.py with that same interpreter, which lacks
    arduino-router-bridge. The local link now falls back to the deploy venv
    (/home/arduino/stepper-desk-q/.venv, or STEPPER_VENV) when the current
    interpreter can't import it.
2026-10-12 Run the Arduino Q from its repo clone instead of stepper-desk-q
    The board-side install moves from /home/arduino/stepper-desk-q to
    apps/stepper_desk in the board's clone of this repo
    (/home/arduino/IEEE-Minimalist-AI-Challenge-2026). deploy.sh clones it if
    missing, copies the working tree in, builds apps/stepper_desk/.venv and
    flashes from there. motion_lib comes from the clone, so it is not copied
    separately. The SSH gateway path in arm_client and the Mac app, the
    local-link venv fallback, the helper scripts and the docs point at the
    new location. Board build directories are gitignored.
2026-10-12 Remove the -34 deg shoulder floor and the script safety envelopes
    A recheck after hardware work lifted the shoulder back cleanly from -31
    to +36 deg at 30 deg/s, so the firmware, client, app and sim go back to
    the user's -45..38 deg shoulder limits. emote.py and ik_line.py now use
    the joint limits less the firmware's 2 deg margin.
2026-10-12 Refactor: shared arm/ module used by Lumen and the arm tools
2026-10-12 Lean main: Lumen app + shared arm module (test bench lives on dev)
2026-10-12 Lumen: survive arm stalls and faults, center the face first
    - Stalled STREAM is no longer fatal: the gateway returns it (state stalled) instead of
    ending the session and sleeping the drivers; arm_motion.stream_point reports it.
    - Motion worker recovers stalls in place: HALT, hold powered, push again slower
    (10/6/4 deg/s); clips resume from the stall, slower. FAULT only if the arm is jammed.
    - Worker thread survives errors, logs the traceback and reconnects when BOOT asks
    (was: thread died, app stuck in BOOT forever).
    - BOOT timeout -> FAULT; FAULT reasons printed; faults >2 min apart don't latch.
    - Integrating look-at: centers the face vertically before STANDBY clips start;
    offset ke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
2026-10-12 Recovered board work from 2026-10-12 (Arduino Q died before it was pushed)
    Rebuilt from the Claude session transcript that the desktop app mirrored to the
    Mac, by replaying its recorded edits on top of the partial bd93b4e commit below:
    - b8e1407 firmware stall grind (servo.hpp, arm_motion.py docstring, servo_test.cpp)
    - head-tilt servo J5 on D2, elbow DIR moved to D6 (roll.hpp, sketch, gateway,
    ArmMotion, trajectory, worker, tests)
    - Lumen Desk browser page (apps/lumen/lumen/desk, test_desk.py, arm/cad)
    - driver sleep on jog release and idle-awake safety net
    - docs/CHANGES-board-2026-10-12.md: the CHANGES.md written on the board
    Not recoverable (never in the transcript): the rest of bd93b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
2026-10-12 Fix the stuck-joint servo test: keep the stream goal inside the head's range
    The goal ramped past the head limit during the ~4.5 s of grinds, so the stream
    was refused, the lease lapsed to HOLDING and the final STALLED never came. The
    firmware was right; the test now caps the goal at 40 deg. arm/scripts/test.sh
    passes in full on the Mac.
2026-10-12 test_worker: give FakeArm a roll() stub for the head-tilt servo
    The board session made this edit after adding J5 roll; the original was lost
    with the board, so this is a reconstruction.
2026-10-13 Lumen: crops for hands and book, book-lost confirm, GOODBYE face check, fault reset
    - Perception now sets hand_roi (beside and below the target face, else over the
    last book) and book_roi (around the last book, full frame after a miss). They
    were read but never written, so every model ran on the full frame.
    - BOOK_LOST needs 3 misses in a row and 2 s without the book; a miss raises the
    book rate to 3 Hz. Before, one missed 0.5 Hz check fired it.
    - GOODBYE runs face at 5 Hz and the face flag is cleared on every state change,
    so STANDBY vs IDLE no longer depends on a sighting from minutes earlier.
    - A latched FAULT can be cleared with an open palm held 3 s (RESET -> BOOT).
    - tests/test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
2026-10-13 Lumen tests: transition coverage, every v1 edge, diagram-vs-code check
    - test_machine_edges.py: one test per v1 edge (LOST, GOODBYE both ways, REACQUIRE both
    ways, SLEEP <-> IDLE, SEARCH -> STANDBY on PALM, FAULT from every state and from inside
    ILLUMINATE with parent exit/re-entry), and every state timer with a fake clock.
    The spec's "latched until reset" has no RESET event: expectedFailure test documents it.
    - test_transition_coverage.py: runs the machine tests instrumented and fails if any
    (state, event) key in TRANSITIONS, or any outcome of a function target, is never driven.
    - test_state_diagram.py: parses the v1 mermaid blocks in docs/STATE_MACHINE.md; strict on
    states and ed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
2026-10-13 Lumen worker: seq command plays a plan (goto/wait/play/mark/rebase) as one command
    Lets the director chain moves without one command interrupting the next, and keep the pose a
    clip like go_to_sleep ends at (rebase). Marks come back as STEP events for the director only.
2026-10-13 Lumen: port GlanceBeforeMove, AnticipationWindup, IdleBreathe, Hesitation as plan functions
    behavior/modifiers.py builds worker plans from a move or a hold and slows every goto into the
    arm's speed, elbow-lift and accel caps. AIM uses glance + windup, ADJUST a small windup
    (>= 2.5 deg so the gear backlash doesn't swallow it). Adds test_modifiers and test_director
    (director with a fake worker and light).
2026-10-13 arm: lamp LED command (LIGHT <0-1000> [fade ms]) on D7 / TIM8
    Firmware: light.hpp (portable: clamp, linear fade, compare mapping) and an
    arm_light RPC driving a 20 kHz PWM on D7 (PB2, TIM8 CH4N), the only PWM
    header pin whose timer nothing else uses (TIM1/3/4 run the STEP trains,
    TIM2 is the roll servo's 50 Hz). Needs no session owner; the level stays
    when the session ends. Behind LIGHT_ENABLED (default 0): enabling it moves
    the head DIR from D7 to D12, so today's wiring keeps working until the LED
    is wired. Wiring and MOSFET notes in arm/README.md.
    Python: gateway LIGHT / LIGHTSTAT (old firmware reports supported False
    instead of ending the session), ArmMotion.light() / light_status(), whi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
2026-10-13 Lumen: headless full-loop demo simulator (tools/simulate.py)
    Drives the real Machine + Director + Perception (debouncers, scheduler, gesture rules)
    with fake face/hand/book/gate detectors reading a scripted world, a fake motion worker
    and a fake clock, through the whole demo: walk up, point, not found, find, illuminate,
    closer/further, check-in, book lost/reacquired, exit, leave, sleep, wake, fault, auto
    retry, latched fault, reset. Prints the state path, writes a translog-format CSV and,
    optionally, a clearly SYNTHETIC power trace for exercising the scorecard.
    TransitionLog takes an optional path and wall time (defaults unchanged).
    tests/test_simulate.py runs it; an expectedFailure test do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
2026-10-13 Lumen SLEEP: pace the camera to 2 fps, opt-in CPU governor, slump once then breathe slowly
    - io/power.py: FrameThrottle (Camera.set_fps paces read() on fixed slots; the V4L2 backend
    only applies a new fps by restarting the stream), CpuGovernor (opt-in via
    SLEEP_CPU_GOVERNOR, writes scaling_governor only where already permitted, restores on
    wake, never raises) and Power, the director's SLEEP enter/exit hooks.
    - SLEEP plays go_to_sleep/drowsy once and rebases on its slumped end pose, then loops
    idle_breathe/calm at amplitude 0.3, time_scale 2.
    - app.py timestamps a frame after the read; the scheduler allows 10 ms of slack so a 2 Hz
    gate on 2 fps frames doesn't skip every other one.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
2026-10-13 Arm firmware: backlash compensation so slow reversals don't read as stalls
    servo.hpp gets a gear-slack observer (Settings::backlashDeg, head 2.5 deg): pulses
    that only cross the slack after a reversal don't count in the stall windows and
    widen the following-error limit, and the gear then engages gently (correction
    capped at refV*speedGain + engageSpeed until the joint is back on its reference).
    Before, the error built up while crossing the slack slammed the gear in at ~7 deg/s
    and the head's tight spot lost steps: Lumen's hold drift faulted every ~30 s.
    Sim: the tight spot now only loses steps when the gear is engaged (the motor turns
    freely inside the slack). New test holdDriftThroughBackl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
2026-10-13 Lumen: lamp light layer (eased ramps, gamma, coupling, backends)
    io/light.py: Light now ramps over time (smoothstep ease in/out, 0.5 s by
    default, 0.3 s for ADJUST steps) advanced by light.update(now) from the
    main loop, instead of jumping. Levels are perceptual (what the HUD shows);
    backends get duty = level ** 2.2. Retargeting mid-ramp starts from the
    current level. couple(scale) implements LightCoupling: the director dims
    to 70 % on entering CHECK-IN and restores on exit (two small hooks).
    Backends, chosen with env LUMEN_LIGHT (config.py), default "sim":
    - sim: logs the duty when a ramp lands
    - firmware: hands the motion worker a per-mille target; the worker (which
    owns the arm session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
2026-10-13 arm: kinematics for the lamp head (FK to the shade, IK that lights a desk point)
    kinematics.py, pure Python: links 18.5/18.5 cm and the 4.5 cm head-tilt pivot from
    cad/model.json, the shade from the CAD meshes, shoulder height and LED offset from the
    MuJoCo model (to measure on the real arm). The shade's axis runs along the head link, so
    J5 swings the beam sideways (+roll = lamp's right). aim() points the light axis exactly at a
    desk point from a comfortable height inside SAFE_RANGES / ROLL_RANGE; move_along_beam() steps
    it along its axis for CLOSER/FURTHER, clamped to reach and shade clearance. fk() takes a yaw
    for a future yaw joint.
    FK matches MuJoCo (dev c088a9d) to 1e-15 over 500 rando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
2026-10-13 Lumen: AIM at the book, a desk-covering SEARCH sweep, ADJUST along the light axis
    - behavior/aim.py: pinhole camera (CAMERA_HFOV_DEG, an assumption until measured) for
    pixel -> ray -> desk point, AIM pose from the book box, SEARCH pause planning and coverage.
    - AIM: perception.last_book's centre, seen from the settled sweep pause, through the camera
    onto the desk, then kinematics.aim(); falls back to where the camera looked.
    - SEARCH: 4 pauses near to far with a +-20 deg J5 left/right zig-zag: ~97% of DESK_AREA
    in frame (pitch alone ~65%). Moves are timed to the speed caps.
    - Settle: the worker reports AT_POSE only once the measured angles are within 1.5 deg (after
    0.25 s, at most 1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
2026-10-13 Lumen CHECK-IN: actually look up at the user, track the face, return to the aim pose
    The director remembers the camera pitch that centered the face in STANDBY (and refines it
    during each check-in). CHECK-IN plays a plan: head up most of the way toward it, mark, 1.5 s
    of look-at on the face (10 Hz face model), mark, glide back to the aim pose with the look-at
    offset cleared; CLIP_DONE returns to HOLD. In clearly separated _checkin methods.
2026-10-13 Lumen: scorecard report from transition logs, perfstats and a power meter
    tools/scorecard.py reads translog CSVs (sessions split on restarts), and optionally a
    PERF_CSV and a meter CSV (time + watts, or volts + amps; epoch, ISO, HH:MM:SS or the
    translog t clock). It prints markdown for bench/RESULTS.md: per-state visits, time and
    share; measured inferences/min per model per state next to the configured rate; with
    power, average W per state, energy, mJ/inference and mJ/inference above idle; perfstats
    latency percentiles; and a ready "Full system" row.
    tests/test_scorecard.py checks exact numbers on a hand-made log and runs it on the
    simulated demo.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
2026-10-13 Lumen REACQUIRE: small widening local sweep around the aim pose, back to it on exit
    Peeks fit inside the 4 s timeout while the book model runs at 3 Hz on the crop perception
    widens to the full frame after a miss (tested end to end with a fake book). Plans keep a 4th
    pose value (J5 roll) and the seq goto uses set_base, to stay compatible with lumen-geometry.
2026-10-13 Lumen: leave AIM and ADJUST motion to behavior/aim.py (lumen-geometry owns them)
    Reverts the AIM/ADJUST wiring of the modifier commit; behavior/modifiers.py stays as a library
    (expressive_move(..., "aim") is ready for AIM to adopt).
2026-10-13 Lumen faults: stale encoders are SENSOR_STALE, not a stall
    The firmware stops by itself when an AS5600 sample is stale or invalid (age > 100 ms,
    I2C error, magnet bits): servo FAULT with reason sensor, or a STREAM refused with
    -EINVAL because the measured angle is NaN. Both used to surface as a generic
    ArmError ("Firmware rejected command: -22").
    - arm_client: SensorStale(ArmError) and stale_joints() (which joint and why).
    - script_gateway: a rejection whose status shows stale axes replies kind=sensor_stale;
    the transport raises SensorStale for it.
    - arm_motion: stream_point/angles/_movable/move_to raise SensorStale on unhealthy
    feedback (angles() no longer returns -2147483 deg), and a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
2026-10-13 Lumen faults: a dead gateway, router socket or link is LINK_LOST, fast
    - arm_client.Transport: LinkLost(ArmError) for no reply within the per-request
    deadline (0.25 s local, 0.6 s Tailscale; 8 s only for the first reply, which
    includes gateway start-up), for the gateway closing stdout (e.g. 'Arduino router
    is unavailable') and for a broken pipe to a dead gateway (was a raw OSError).
    Error replies with kind=link_lost raise LinkLost too.
    - script_gateway: router RPC timeouts, closed sockets and lost MCU ownership reply
    kind=link_lost.
    - worker: LinkLost / ConnectionError / TimeoutError / BrokenPipeError -> 'LINK_LOST: ...'.
    While relaxed nothing streamed, so a dead link went unnoti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
2026-10-13 Lumen mirror mode: a wave in STANDBY plays the mirror pool and the head follows the hand
    perception/gestures.WaveDetector: >= 2 wrist-x direction reversals within 1.2 s, each swing
    at least half a hand size (jitter, drift and slow sways don't count). Perception emits WAVE
    (no machine transition) and records wave_t. The director, in STANDBY only and for a fresh
    wave, plays one clip from the mirror pool and steers the head toward the hand for MIRROR_S
    before handing back to the face look-at; WAVE is an interaction, so energy goes up.
2026-10-13 Lumen faults: OVERTEMP from the board's thermal sensors, with hysteresis
    - lumen/thermal.py: ThermalMonitor reads every /sys/class/thermal zone and hwmon
    temp*_input (millidegrees; the hottest counts). No sensors (macOS) = disabled.
    Trips at OVERTEMP_C (85), stays hot until all are below OVERTEMP_CLEAR_C (75);
    sampled at most every OVERTEMP_CHECK_S (1 s). The stepper drivers are plain
    STEP/DIR drivers and the firmware exposes no temperature for them, so this is
    SoC/board only.
    - worker: checks it from the motion loop (every move/clip step and between
    commands, rate-limited to 1 Hz): too hot raises Overtemp -> 'OVERTEMP: <sensor>
    <temp> C >= 85 C', the session closes and the dri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
2026-10-13 Lumen faults: the reason is on the HUD and in the transitions log
    - app: a transition into FAULT computes its reason once ('CODE: detail' from the
    worker, or e.g. 'BOOT TIMEOUT'), keeps it in director.fault_reason, prints it,
    logs it and passes it to the HUD while in FAULT.
    - translog: new last column 'reason' (empty except into FAULT). A same-day file with
    the old header gets a new file instead of mixed layouts.
    - hud: up to two 'fault ...' lines.
    - README: the reason codes. Test: the log column (the HUD needs cv2, not tested).
2026-10-13 test_light: give the fake worker a pose (current, base_roll)
    After merging lumen-geometry the director plans AIM/ADJUST from the worker's
    current pose; the catch-all fake answered those with functions.
2026-10-13 simulate: fake worker gets path(); keep the book covered until 76 s
    ADJUST is now a path() command, and it takes a little longer, so the
    check-in timer fires at 71.6 s, inside the old 70-73 s cover window; the
    state change resets the miss count and BOOK_LOST never fired.
2026-10-13 HUD: show what Lumen is thinking (state + time, where it can go next, what the arm plays)
    - lumen/thinking.py (pure text, tested): "STATE <path> <s in state>", then
    "next:" with each reachable state and what takes it there (the state's own
    edges, then its parent's; the global -> FAULT is left out), the pending
    timer shown as "(in 6.5s)", and "arm: <clip name | move | sweep | hold>".
    - MotionWorker.doing: set when a command starts (the clip name for play and
    for clips inside a seq plan), back to "hold" when it ends.
    - GOODBYE's function target gets a label (STANDBY/IDLE).
2026-10-13 Lumen: one folder per feature, each with its own config.py
    Reorganizes apps/lumen/lumen so each feature is cordoned off and every tunable
    number is in the config.py of its folder:
    - movement/ worker, aim, look_at, modifiers, expressive, pools + config.py
    (arm hardware limits re-exported from arm/python/arm_config.py)
    - ai/ Perception + scheduler + config.py (event rules, crops), and one
    folder per model with its own config: face/, hands/, book/,
    motion_gate/ (model paths, thresholds, tracking, gesture rules)
    - state/ machine (STATES/TRANSITIONS), director + config.py (timers)
    - light/ light + config.py; io/ camera, power, therma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
2026-10-13 Book detector: YOLOX-S w8a8 (COCO "book"), wired into ai/book/
    From the lumen-book benchmark (docs/MODEL_SELECTION.md): Qualcomm AI Hub
    Yolo-X v0.64.0, YOLOX-S w8a8 TFLite at 640x640, Apache-2.0, 9.4 MB, in
    models/book_det-tflite-w8a8/. BookDetector keeps class 73, letterboxes with
    YOLOX's gray, honours the book_roi crop (boxes come back in frame pixels),
    and degrades to available=False / [] without a runtime or model.
    Every setting is in ai/book/config.py: model folder, SCORE_THRESHOLD 0.3
    (recall 0.45 vs 0.25 at 0.5; BOOK_FOUND still needs 2 hits), NMS, class,
    BGR channel order (scored better than the documented RGB), input range,
    letterbox pad, minimum roi, threads. Also moves the last h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
2026-10-13 bench: book detector eval harness, COCO stand-in set, candidates, YOLOX export
    eval_detector.py (recall @ IoU 0.5, FP/frame, false-alarm images, latency),
    coco_bookset.py (COCO val2017 eval set + train2017 int8 calibration set),
    capture_desk_set.py (record + pre-label the real lamp-camera set),
    book_candidates.py (fetch the published candidates), export_yolox.py
    (YOLOX nano/tiny to a book-only TFLite, fp32 + int8). Data and candidate
    models are gitignored. Written on lumen-book; imports moved to lumen.ai.book.
2026-10-13 docs: MODEL_SELECTION.md (why each model, book benchmark + quantization, UNO Q compute budget)
    - Why face_det_lite, MediaPipe hands and YOLOX-S; every model is int8.
    - Book: candidates and why some were excluded (AGPL/GPL, login), the eval set
    and metrics, how int8 was calibrated, the results table, the 0.3 threshold
    and BGR decisions, and why our YOLOX-nano int8 export failed (activation
    ranges ~15x too wide; re-evaluate after quantizing).
    - Compute budget: each live-loop piece timed on the Mac and scaled by the face
    model's known board time (~20x): neural nets dominate, kinematics/planning
    are negligible, inference releases the GIL (25 Hz arm thread worst gap 46 ms
    under back-t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
2026-10-13 Reconcile recovered-board-work (luxoIII board) onto the new layout
    Brings Tong tong's luxoIII work (13 commits, 9027b93..b2e7c57) onto main:
    - Replacement board: scripts/luxoIII-board-setup.sh; host daboard -> luxo3
    everywhere; the board's USB serial is now ARDUINO_Q_SERIAL (default
    634018433) in arm_client and both deploy scripts; flash-local.sh finds the
    core under internal/ after a profile build.
    - Boot: lumen-desk.service runs the desk page (:8081) at boot, Lumen installed
    but off (they Conflicts= each other). apps/lumen/scripts/deploy.sh now keeps
    that choice instead of re-enabling Lumen: LUMEN_BOOT=desk (default) or
    LUMEN_BOOT=lumen (Lumen + HUD :8080); exactly one service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
2026-10-13 Locked shoulder: the arm runs on elbow + head while the shoulder motor is out
    The shoulder motor is gone; the joint is locked mechanically and its encoder
    still reads. arm_config.SHOULDER_LOCK (set) means:
    - Every clamp pins the shoulder: SAFE_RANGES[0] = (lock, lock), HOME[0] = lock
    (both are lists now, updated in place by lock_shoulder()).
    - Lumen's motion worker and the desk page re-lock it at the MEASURED angle on
    connect (relock_shoulder), so no setpoint ever asks the dead motor to move.
    - Clips fold their shoulder motion into the elbow (fold_locked_shoulder): the
    forearm's and head's world angles, and so where the light points, move as
    authored. If the folded elbow would leave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
2026-10-13 One web page on :8080: HUD + desk controls with an Auto/Manual switch
    Lumen serves the desk page itself (ui/web.py): the camera feed carries the
    HUD, and an Auto/Manual switch hands the arm over. Manual = new MANUAL state
    (worker.release(), then the desk connects); Auto = desk disconnects, BOOT.
    Starts in Manual (ui/config.py START_MODE). lumen-desk.service is gone;
    deploy.sh and the luxoIII setup enable only lumen.service and remove the old
    desk service. In Auto the server refuses arm commands except STOP.
